ethanewer/ece455/util/README.md

# Utilities

Python tools that read the design files, simulate, lay out, and test them. Run from the repository root.

| Module | Purpose |
|---|---|
| `design.py` | The one place that knows where the design files are, the roles of the LTspice parts, and how the drawing's nodes map to board nets |
| `kicad.py` | Parses KiCad schematics, boards, and BOM exports into parts and nets, without kicad-cli |
| `ltspice.py` | Parses an LTspice `.asc` drawing into a netlist and writes an ngspice deck, including an equivalent of LTspice's UniversalOpAmp2 |
| `xlsx.py` | Reads cell values from an `.xlsx` workbook |
| `spice.py` | Runs ngspice operating-point, AC, noise, and transient analyses |
| `physics.py`, `crb.py` | Proton precession constants, the Curie-law FID amplitude, the FID model, and the frequency Cramér–Rao bound |
| `coil.py` | Winding length, resistance, and inductance by the CoilDesign.xlsx method, and their inverses |
| `printfile.py` | Measures printed parts from Bambu Studio `.gcode.3mf` files |
| `simulate.py` | `make sim`: writes `docs/simulation/` from the LTspice drawing, the tuning bank, the coil workbook and forms, and the firmware's ADC settings |
| `breadboard.py` | `make breadboard`: checks the fixed breadboard layout against the LTspice netlist and board nets, then writes `docs/breadboard/` |
| `firmware.py`, `firmware_host/` | Compile the Pico firmware on the host with stub SDK headers and run its estimator |
| `flash.py` | `make flash`: reboot a Pico into BOOTSEL over USB and copy a UF2 image onto it |
| `tests/` | `make test` |

The readers (`kicad`, `ltspice`, `xlsx`, `printfile`, `spice`) take paths and values and know nothing about this design. `tests/fixtures/` holds a frozen copy of the LTspice drawing with LTspice 17.2.4's results for it, so the translation is tested against LTspice even after the live drawing changes.
