ethanewer/ece455/local/device-diagram-options/diagram-options.md

# boat, towfish, sensor, proton wiggle

Five silly MS Paint–style options for how our proton magnetometer should work.

The boat tows the towfish. The sensor lives inside the towfish. We briefly line up the protons, let go, and listen to their wiggle. How fast they wiggle tells us the magnetic field.

## 1. The classic boat situation

Boat up here. Towfish down there. Tiny proton party inside.

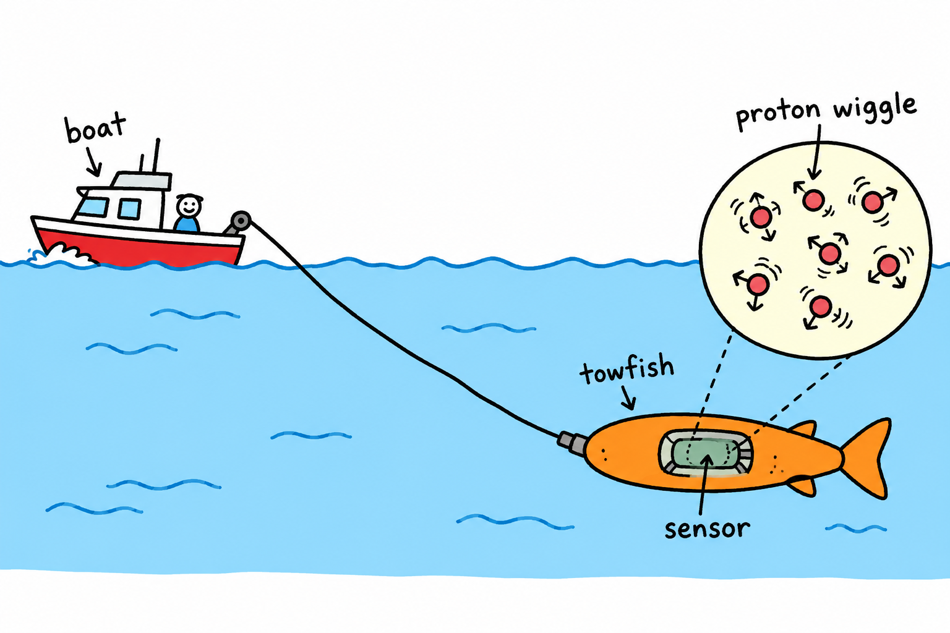
[picture p16: local/device-diagram-options/01-classic-side-view.png]
Boat towing an underwater towfish, with its sensor and a magnified proton wiggle.


## 2. Enhance. ENHANCE.

Zoom into the towfish, then into the sensor, then into the wiggle.

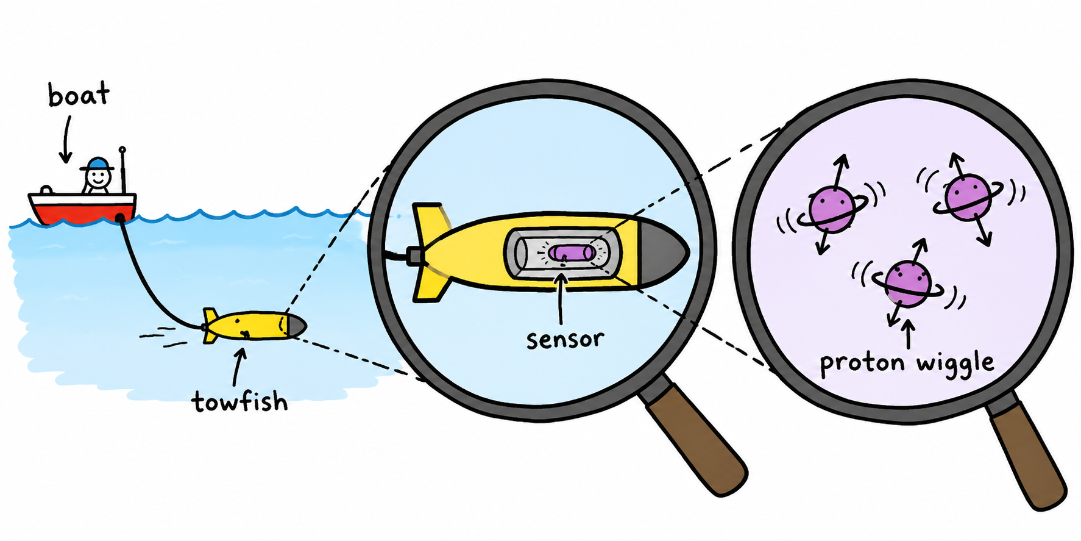
[picture p17: local/device-diagram-options/02-extreme-zoom.png]
Successive magnifying glasses reveal the sensor inside the towfish and the proton wiggle inside the sensor.


## 3. The wiggle trilogy

Tow it. Line the protons up. Let go and listen.

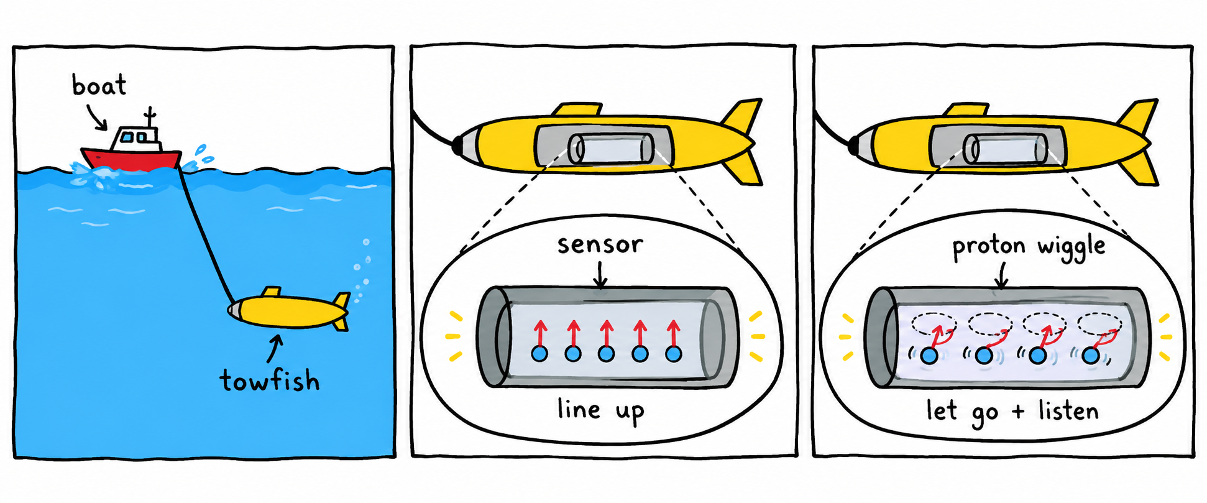
[picture p18: local/device-diagram-options/03-wiggle-comic.png]
Three-panel comic showing the boat and towfish, protons lining up inside the sensor, and proton wiggle after release.


## 4. Very serious science potato

The towfish has achieved potato form. Science continues.

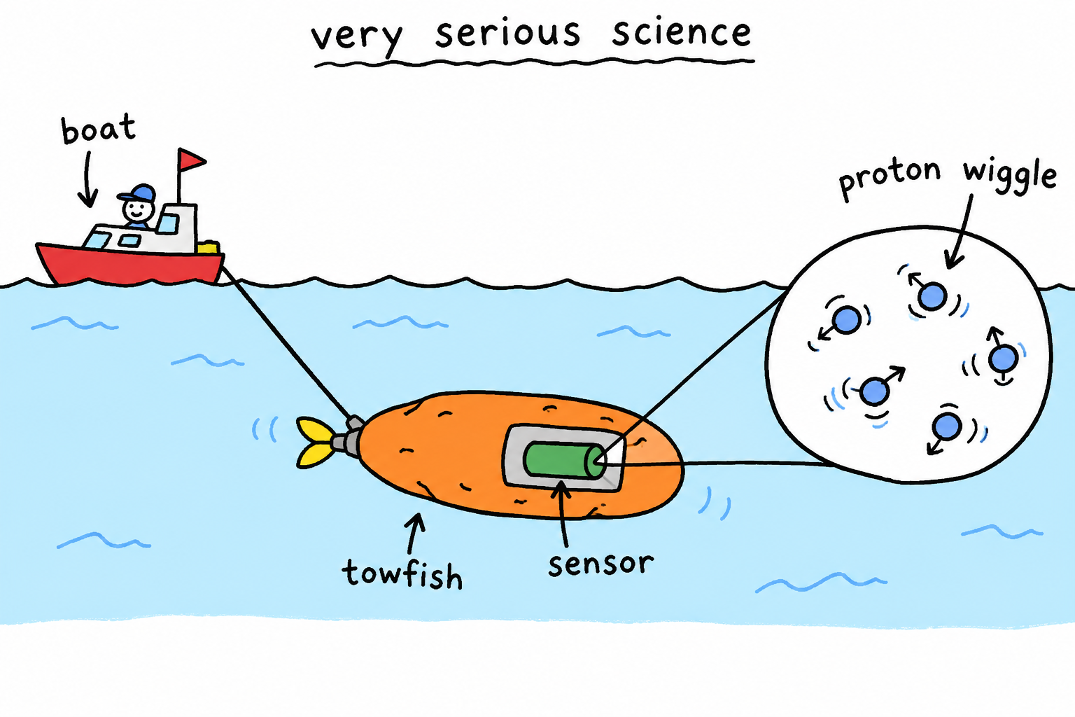
[picture p19: local/device-diagram-options/04-professional-potato.png]
A potato-shaped towfish contains the sensor, with a callout showing proton wiggle and a boat towing it.


## 5. Follow the wiggle

Tiny wiggles underwater become magnetic-field measurements on the boat.

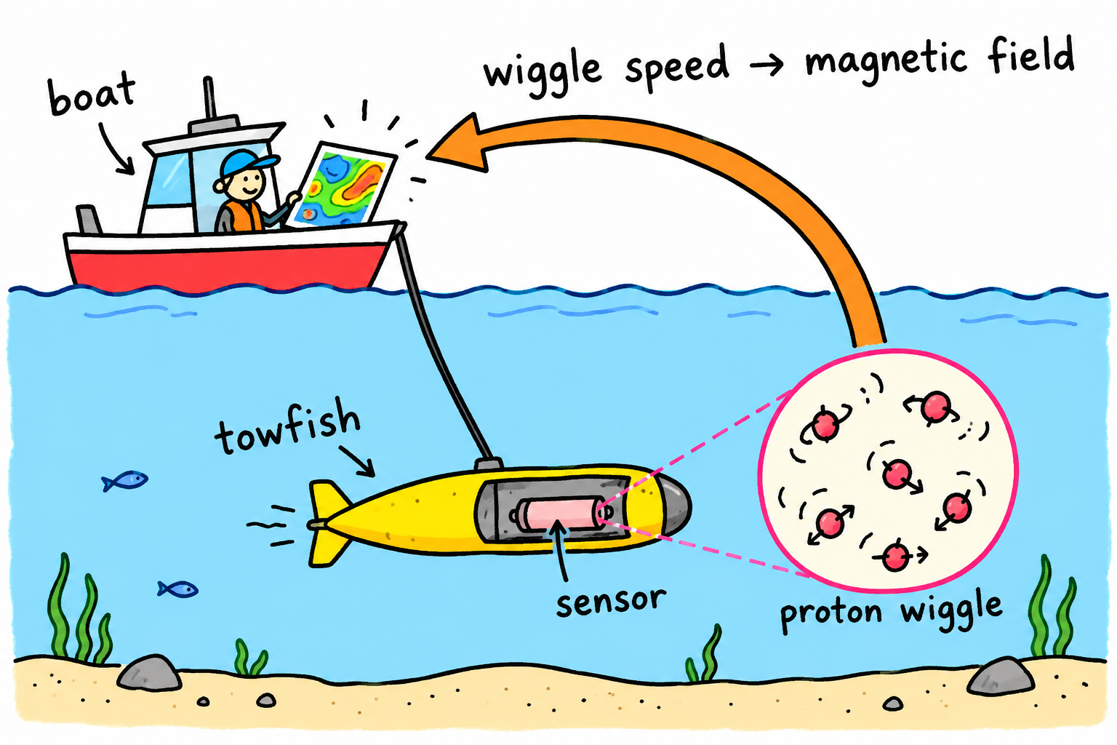
[picture p20: local/device-diagram-options/05-follow-the-wiggle.png]
Boat towing a towfish with a sensor, a proton wiggle close-up, and an arrow from wiggle speed to a magnetic-field map.


---

Generated with the built-in image generation tool. The five complete prompts are saved in [generation-prompts.json](generation-prompts.json). These are concept cartoons; shapes and sizes are illustrative.
