ethanewer/ece455/docs/past_work/proton_magnetometer/ECE 455 Final Documentation Slides Hook Line and Towfish.pptx.pdf

## Towfish Proton Precession Magnetometer (PPM) Design Documentation

Tanner Brasfield, Matt Schutt, Blake Helland

ECE 455: CAPSTONE DESIGN IN ELECTRICAL AND COMPUTER ENGINEERING

## Agenda

ECE 455: CAPSTONE DESIGN IN ELECTRICAL AND COMPUTER ENGINEERING

Background and PPM Coil Design

Circuit Block Diagram

Circuit Schematics, PCB and BOM

Software

Physical Towfish

Future Improvements

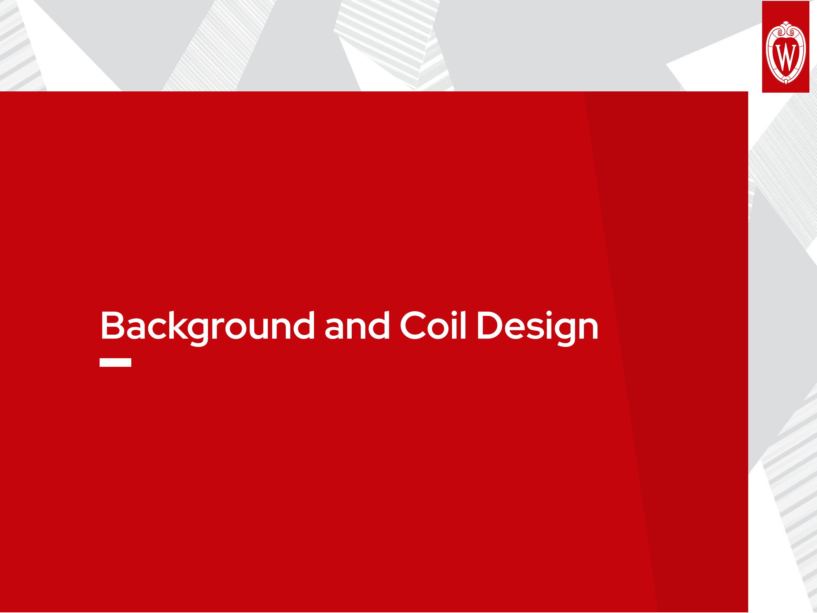
[picture p63: page 3]

## Background and Coil Design

## Proton Precession Magnetometry Background

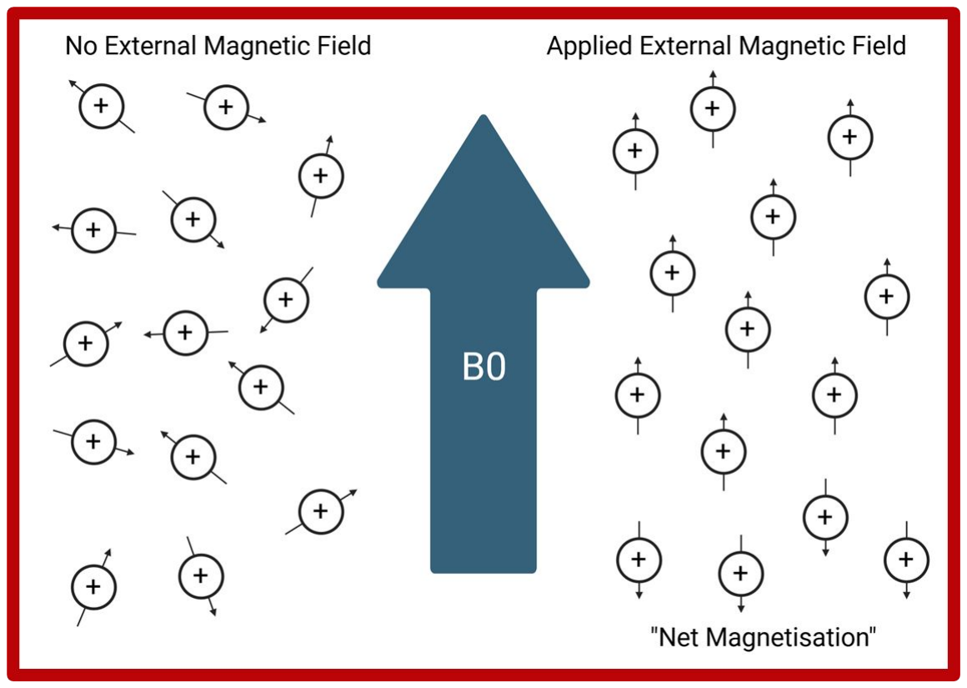
[picture p64: figure]

- Polarization: A DC current
through copper coils generates a
magnetic field (B₀) that aligns protons in a fluid such as water or kerosene.
- Switch-off: The current is abruptly cut off, causing the protons to begin realigning with Earth’s weaker magnetic field.
- Induction & Measurement: As the protons precess, they induce a small AC voltage in the coils, which is amplified and measured to determine the magnetic field strength.

## Coil Design

•3D-printed hollow coil
frame

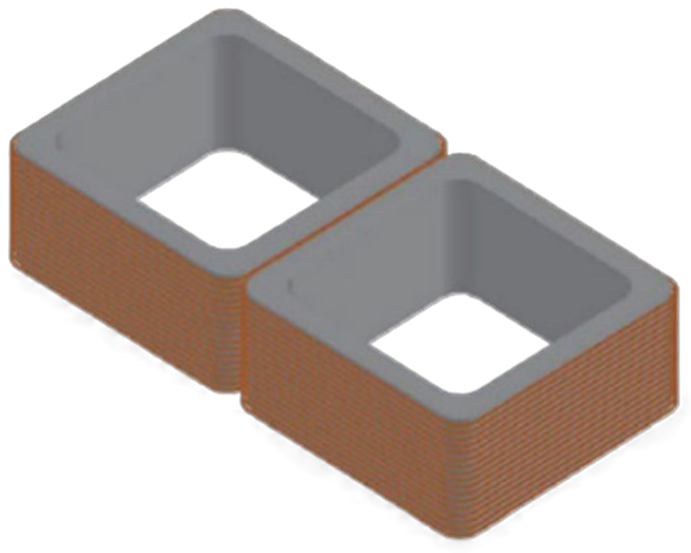
[picture p65: figure]

•10 x 10 x 10 cm

•265 turns per coil, 530
total turns

•Oppositely Wound

•18.5 Ohms Resistance

GitHub 3D Model Link: Link (https://github.com/mattyicebox/ECE445_Towfish_Magnetometer/blob/4ac4c7066d201a6bf55dc5be46255e430674249e/CAD_Files/SP26_HookLineandTowfish_AutoDeskInventorFil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)

## Coil Design Build Steps

•Enclosure: Custom 3D-printed 10x10x10 cm square housings
- Configuration: Oppositely wound coils, each wound to exactly 265 turns.
- Material: 24 AWG copper wire
- Insulation: Windings encapsulated in electrical tape to protect against shorts and improve mechanical stability
- Mounting: Coils securely mounted in PCB holder within Towfish
- PCB Connectivity: Direct terminal soldering to Coil(+) and Coil(-) pads.

## Image of Final Coils Design

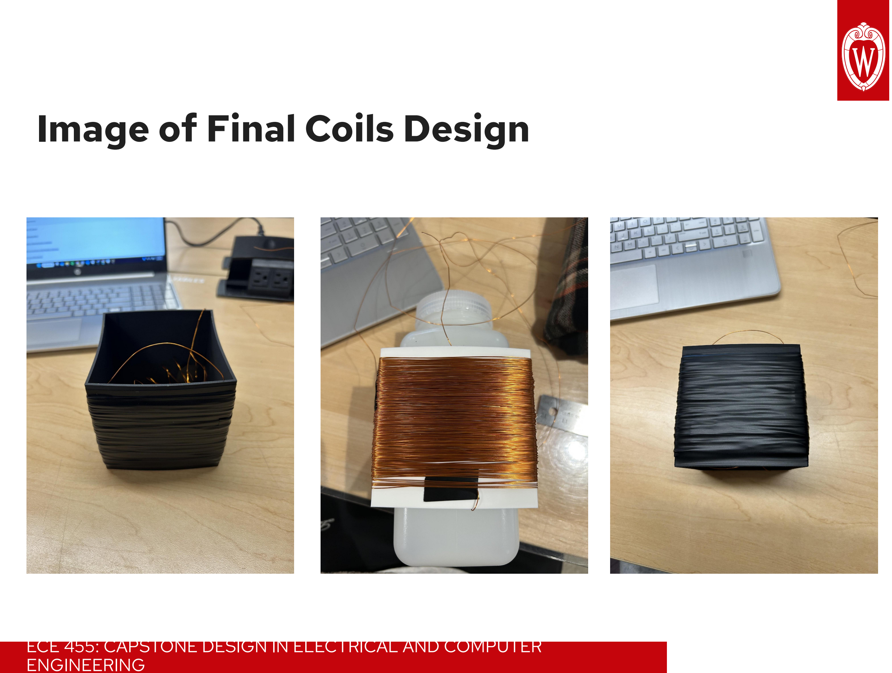
[picture p66: page 7]

## Reasoning For Oppositely Wound Coil Design

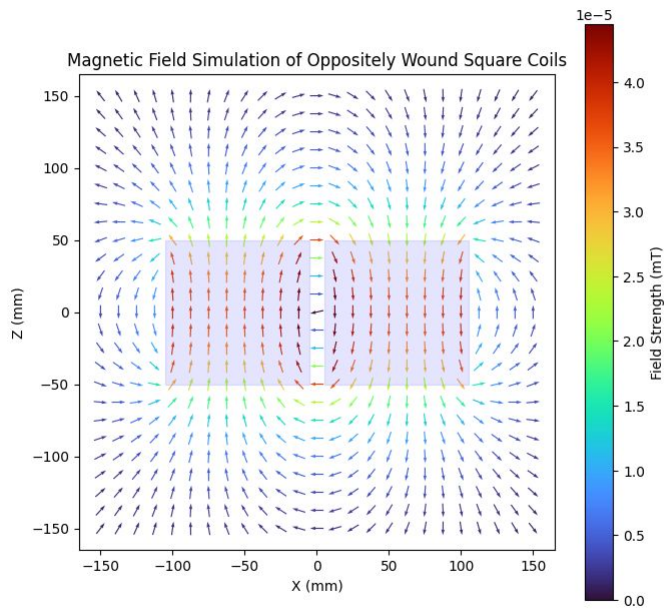
[picture p67: figure]

- Oppositely wound coils help
eliminate external noise by
cancelling voltage induced in one coil equally and
oppositely with voltage
induced in the other coil
- Flux Concentration:
Oppositely wound coils
compress the magnetic field into the center of the two coils, maximizing the
polarization of the fluid

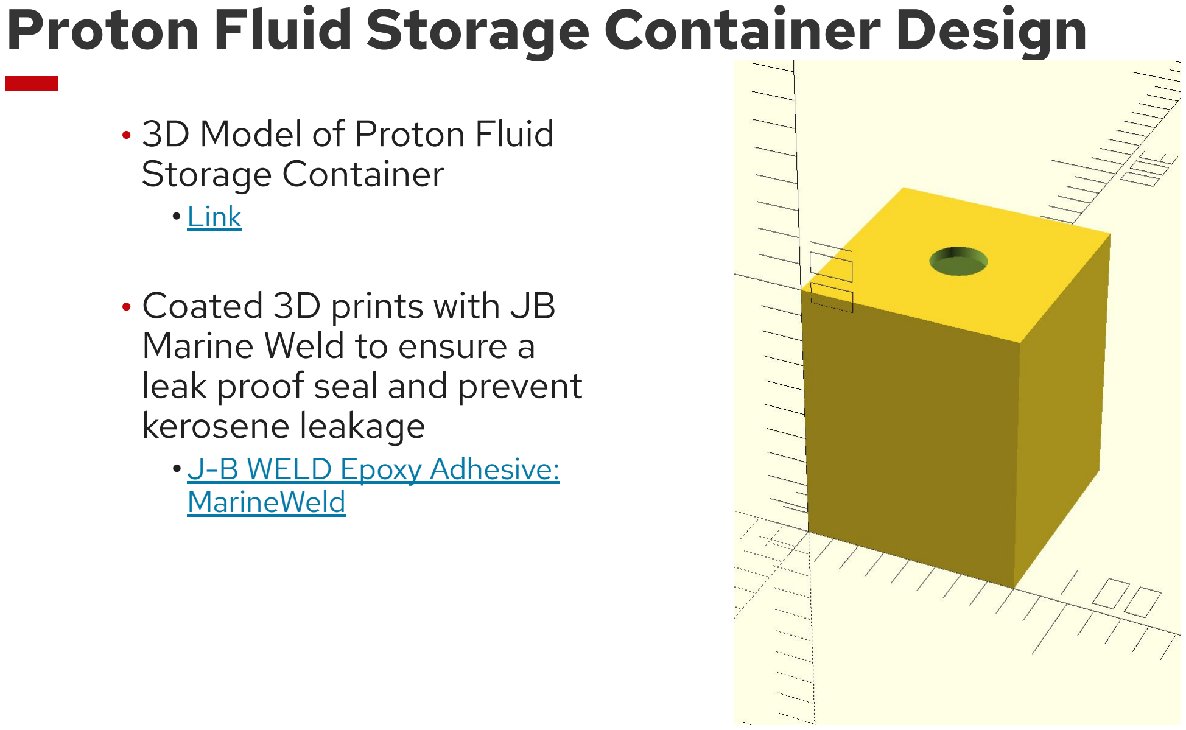
[picture p68: figure]
Proton Fluid Storage Container Design; • 3D Model of Proton Fluid Storage Container • Link; • Coated 3D prints with JB Marine Weld to ensure a leak proof seal and prevent kerosene leakage • J-B WELD Epoxy Adhesive: MarineWeld
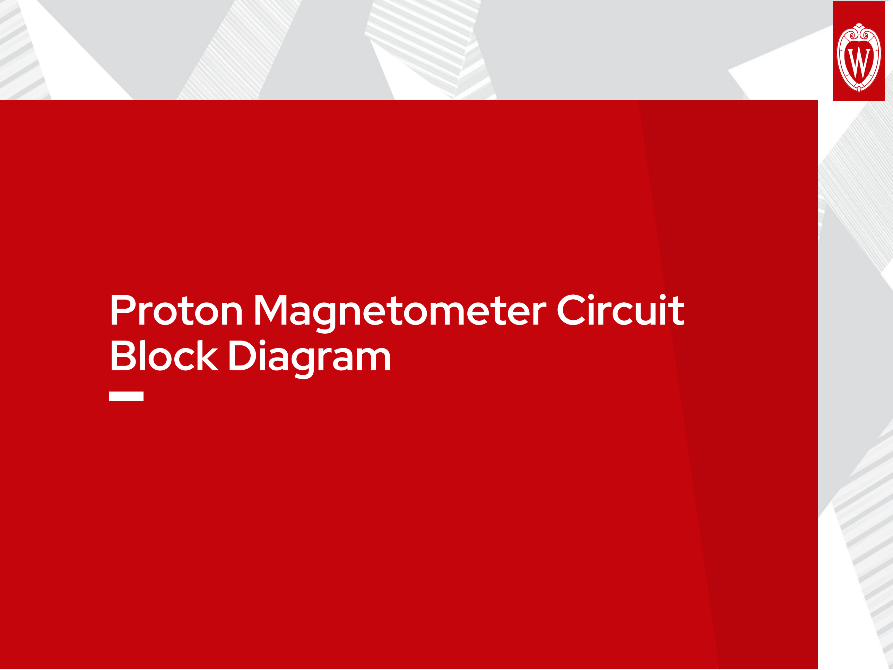
[picture p69: page 10]

## Proton Magnetometer Circuit Block Diagram

## Proton Magnetometer Circuit Design Block Diagram

Design for signal path to accurately measure Proton precession signal
- Powers and controls proton alignment
•Amplifies the proton alignment signal induced after polarization

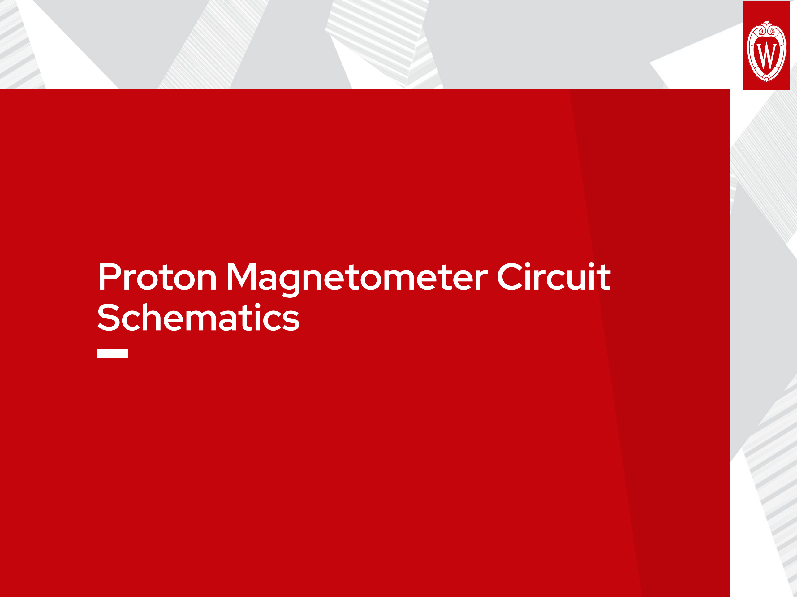
[picture p70: page 12]

## Proton Magnetometer Circuit Schematics

## Proton Magnetometer Circuit Schematics

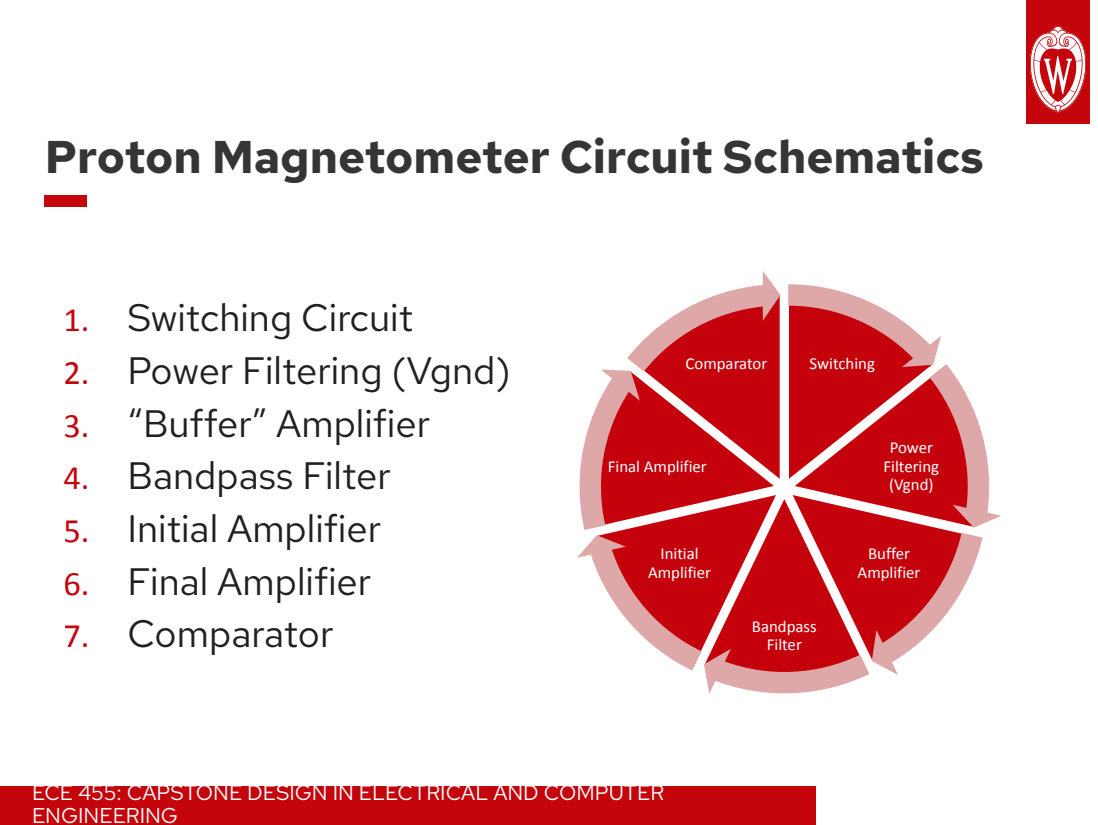
[picture p71: page 13]
Switching; Power Filtering (Vgnd); Buffer Amplifier; Bandpass Filter; Initial Amplifier; Final Amplifier; Comparator

1. Switching Circuit
2. Power Filtering (Vgnd)
3. “Buffer” Amplifier
4. Bandpass Filter
5. Initial Amplifier
6. Final Amplifier
7. Comparator

## Switching Circuit Schematic

- Link to Switching Circuit design files
- Link (https://github.com/mattyicebox/ECE445_Towfish_Magnetometer/blob/074da328fa0f320e46bdf93387bcc2017dd2d0d5/Hardware_Specs/Schematic%20PDF_%5BNo%20Variations%5D.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)
- Simulation File (https://github.com/mattyicebox/ECE455_Towfish_Magnetometer/blob/90d202d4218aa6b1bbdd6d729666215dad1faaf2/Simulations/SP26_HookLineandTowfish_SwitchingSimulati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)
- Switching Circuit Description
- Switches coil between DC polarization and AC sensing circuit to read signal
- When charging is complete and MOSFET is turned off, TVS diode and resistor are used to deplete stored energy before sensing
•Gate driver is used to control high-side MOSFET, and relay control MOSFET
- Current PCB design and BOM includes non-inverting drivers, but currently an inverting driver is soldered to the board for the high side MOSFET, along with a pulldown resistor. Both work, just changes "on" signal from microcontroller.
- Coil charge circuit is currently turned on with an input of 3.3V. Once saturated, turn off charge circuit, wait set time (~900us), then turn on sensing circuit relay with 3.3V input.
- This circuit was chosen for simplicity, and rapid discharge of the coil
- We recommend using a low side N-channel Mosfet to float the coil once it's discharged so you can use an instrumentation amplifier to remove noise in the coil before the main gain stages.

## Switching Circuit Schematic Design

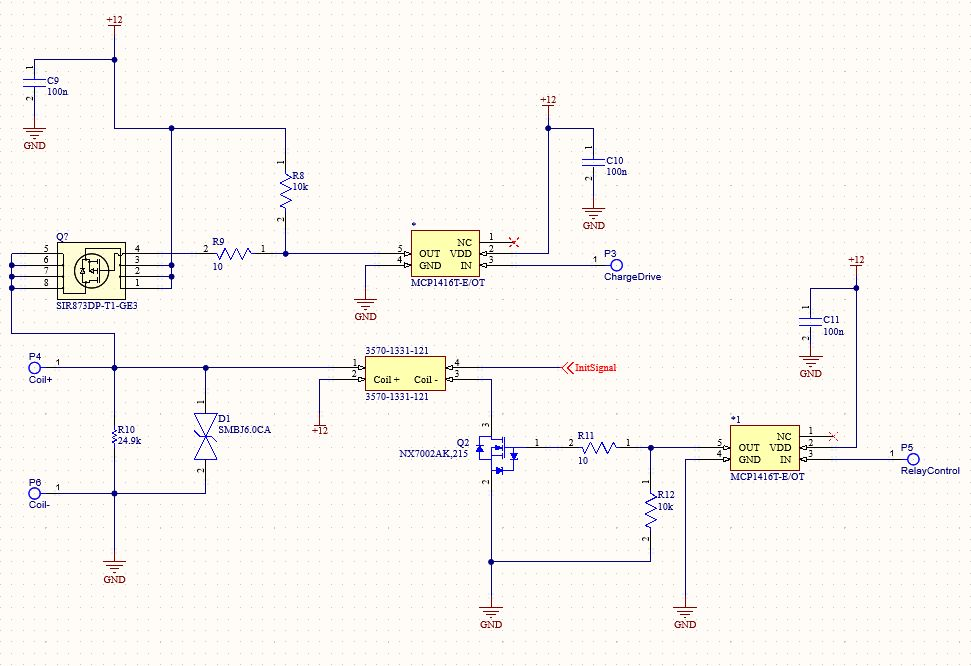
[picture p72: figure]

## Power Filtering Circuit Schematic

•Link to Power Filtering Circuit design files •Link (https://github.com/mattyicebox/ECE445_Towfish_Magnetometer/blob/074da328fa0f320e46bdf93387bcc2017dd2d0d5/Hardware_Specs/Schematic%20PDF_%5BNo%20Variations%5D.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)
•Power Filtering Circuit Description
•Generates stable virtual ground for amplifiers •Voltage divider creates ~6V for a virtual ground with two resistors and decoupling capacitors •Buffer amplifier used to stabilize and strengthen virtual ground for use in circuit
•We chose to create a virtual ground instead of creating a negative voltage for op amps to reduce switching noise

## Power Filtering Circuit Schematic Design

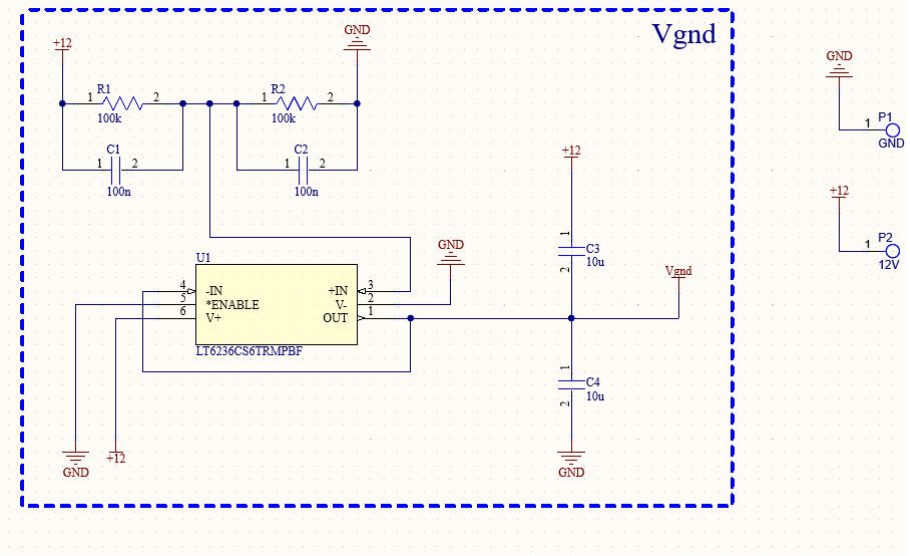
[picture p73: figure]

## “Buffer” Amplifier Circuit Schematic

## •Link to Buffer Amplifier Circuit design files

•Link (https://github.com/mattyicebox/ECE445_Towfish_Magnetometer/blob/074da328fa0f320e46bdf93387bcc2017dd2d0d5/Hardware_Specs/Schematic%20PDF_%5BNo%20Variations%5D.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)
•Simulation Link (https://github.com/mattyicebox/ECE455_Towfish_Magnetometer/blob/90d202d4218aa6b1bbdd6d729666215dad1faaf2/Simulations/SP26_HookLineandTowfish_BufferOffsetSimul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)

## •Buffer Amplifier Circuit Description

•Chosen for high impedance input for signal to prevent source loading
•Technically not a buffer stage as it has 10x gain •Before input, has a decoupling capacitor and a resistor to Vgnd to add DC offset to signal

## Buffer Amplifier Circuit Schematic Design

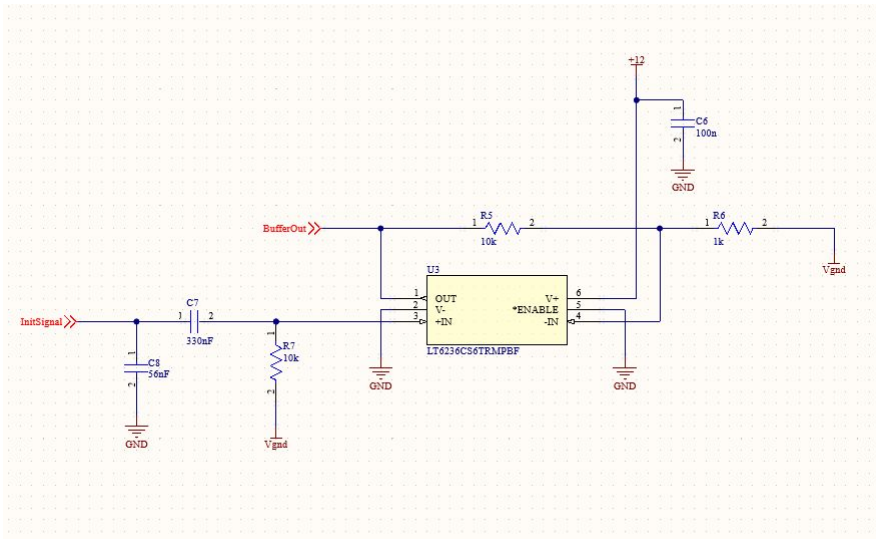
[picture p74: figure]

## Bandpass Filter Circuit Schematic

## •Link to Bandpass Filter Circuit design files

•Link (https://github.com/mattyicebox/ECE445_Towfish_Magnetometer/blob/074da328fa0f320e46bdf93387bcc2017dd2d0d5/Hardware_Specs/Schematic%20PDF_%5BNo%20Variations%5D.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)

## •Bandpass Filter Circuit Description

•Isolates target band (850–5kHz), adds 10x gain

## Bandpass Circuit Design

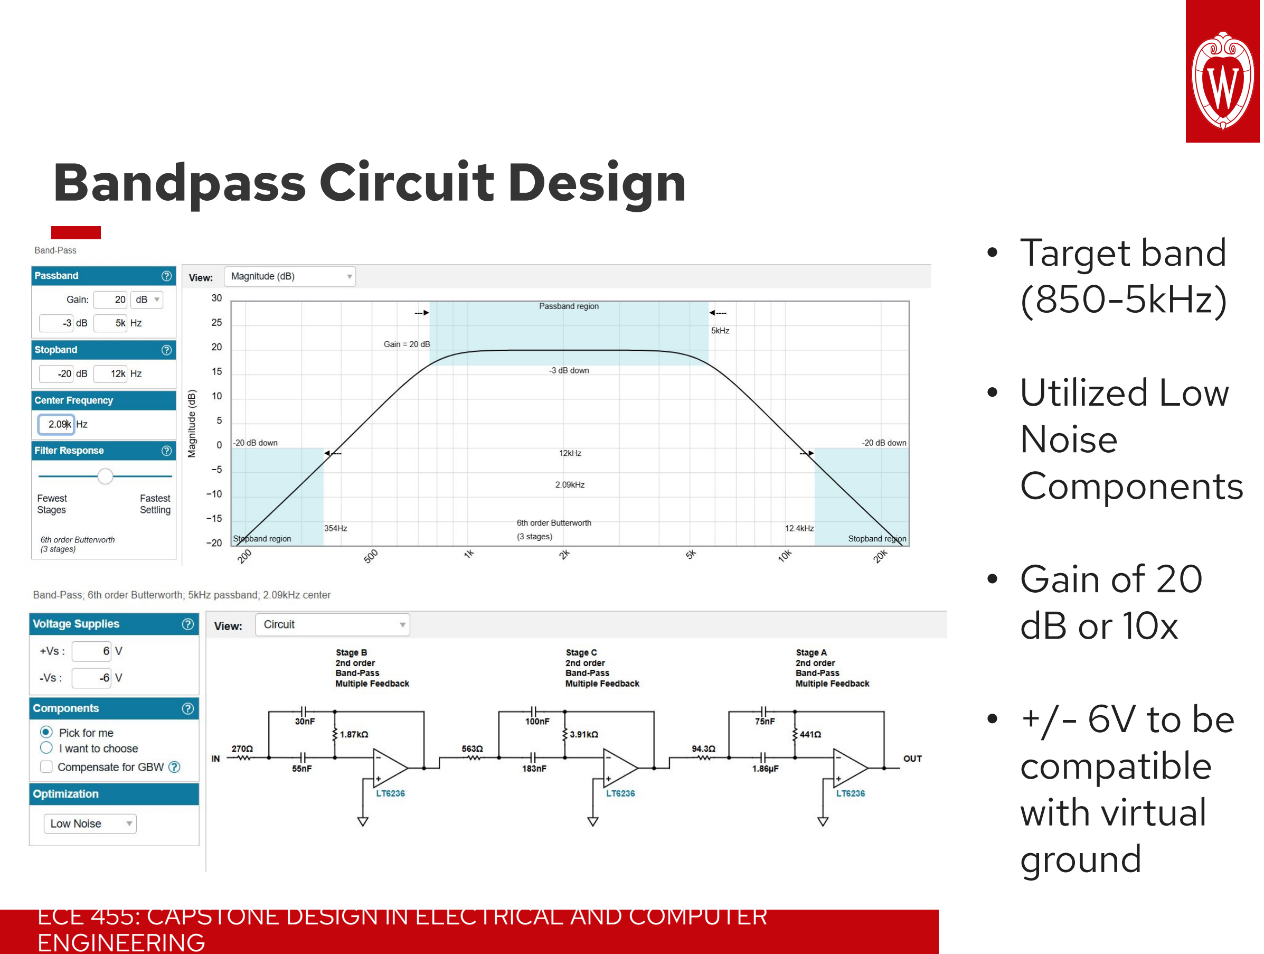
[picture p75: page 21]

- Target band
(850-5kHz)
- Utilized Low
Noise
Components
- Gain of 20
dB or 10x
- +/- 6V to be
compatible
with virtual
ground

## Bandpass Filter Circuit Schematic Design

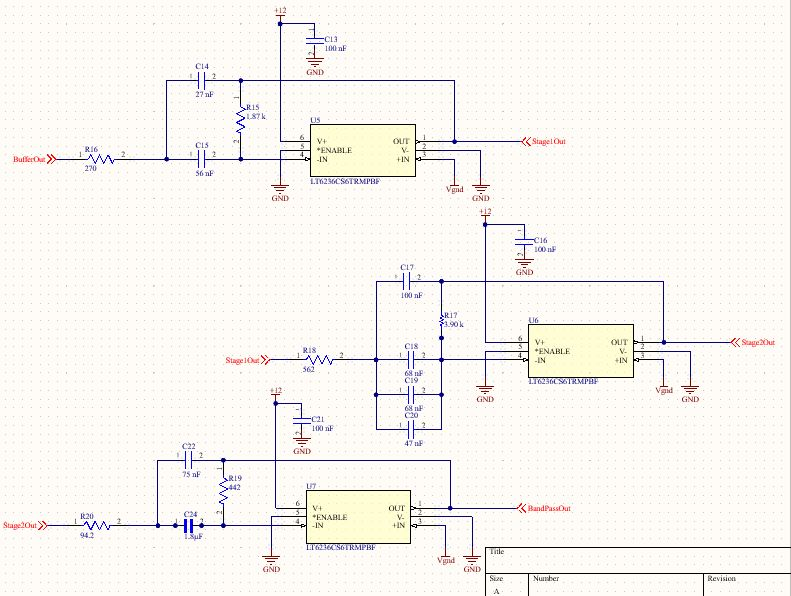
[picture p76: figure]

## Initial Amplifier Circuit Schematic

## •Link to Initial Amplifier Circuit design files

•Link (https://github.com/mattyicebox/ECE445_Towfish_Magnetometer/blob/074da328fa0f320e46bdf93387bcc2017dd2d0d5/Hardware_Specs/Schematic%20PDF_%5BNo%20Variations%5D.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)

## •Initial Amplifier Circuit Description

•Boosts signal by 10x using for signal enhancement
•Simple non-inverting amplifier
•Current PCB set to a gain of 2x for noise testing

## •Chosen for simplicity and reliability

## Initial Amplifier Circuit Schematic Design

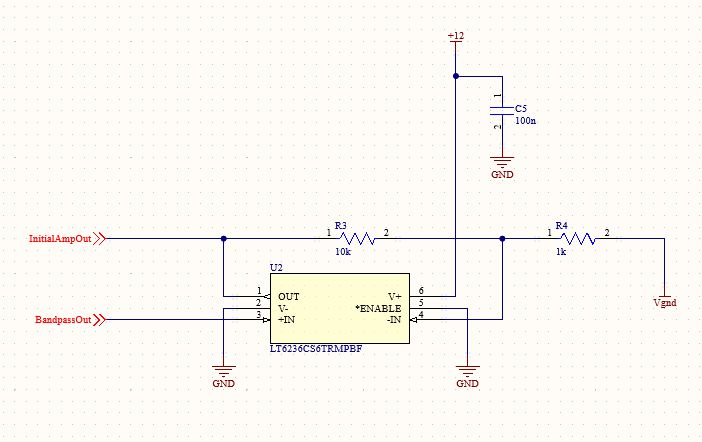
[picture p77: figure]

## Final Amplifier Circuit Schematic

## •Link to Final Amplifier Circuit design files

•Link (https://github.com/mattyicebox/ECE445_Towfish_Magnetometer/blob/074da328fa0f320e46bdf93387bcc2017dd2d0d5/Hardware_Specs/Schematic%20PDF_%5BNo%20Variations%5D.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)

## •Final Amplifier Circuit Description

•Boosts signal by 10x for signal enhancement •Simple non-inverting amplifier, same as initial amplifier
•Current PCB set to a gain of 2x for noise testing

## •Chosen for simplicity and reliability

## Final Amplifier Circuit Schematic Design

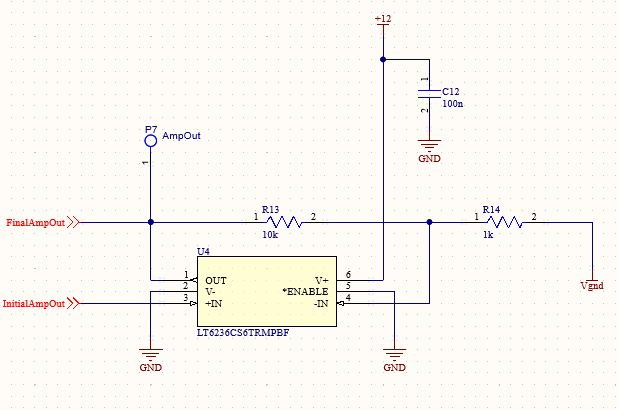
[picture p78: figure]

## Comparator Circuit Schematic

## •Link to Comparator Circuit design files

•Link (https://github.com/mattyicebox/ECE445_Towfish_Magnetometer/blob/074da328fa0f320e46bdf93387bcc2017dd2d0d5/Hardware_Specs/Schematic%20PDF_%5BNo%20Variations%5D.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)
•Simulation File (https://github.com/mattyicebox/ECE455_Towfish_Magnetometer/blob/90d202d4218aa6b1bbdd6d729666215dad1faaf2/Simulations/SP26_HookLineandTowfish_ComparatorSimulat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)

## •Comparator Circuit Description

•Digitizes sine wave to a square wave for microcontroller reading
•Hysteresis added with R24 and R22 to prevent chatter at zero crossings, adjustable if needed •Voltage divider to lower output to ~3.3V

## •Chosen to simplify software frequency measurement

## Comparator Circuit Schematic Design

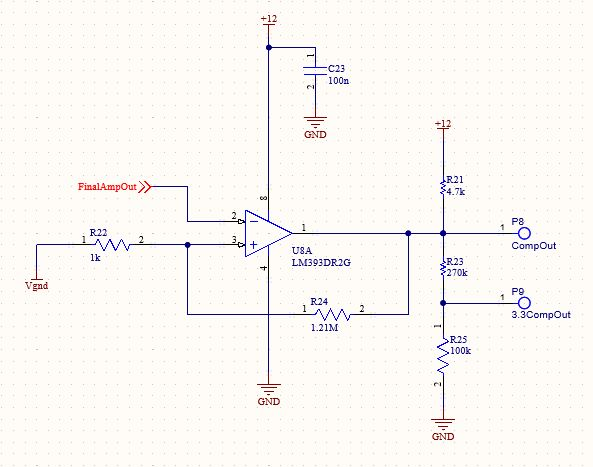
[picture p79: figure]
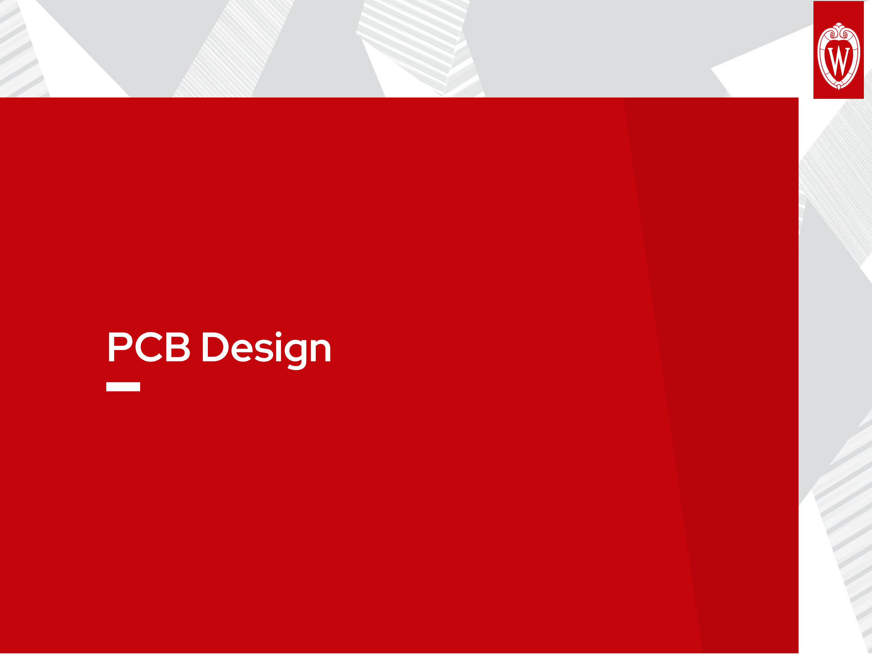
[picture p80: page 29]

## PCB Design

## PCB Design Overview

•4 Layer Board
1. Signal Layer
2. GND Layer
3. 12V Layer
4. Signal Layer

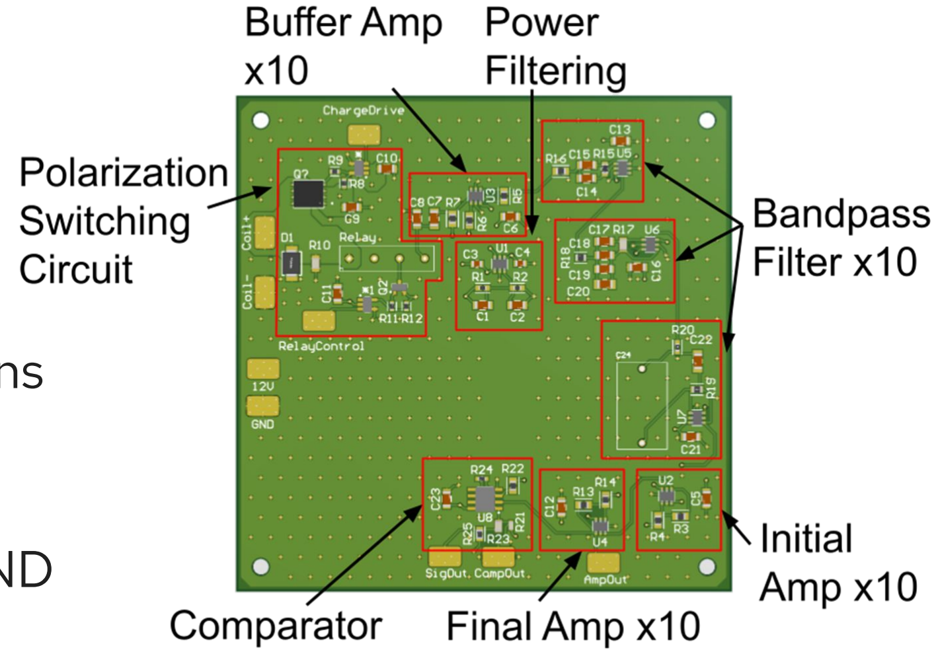
[picture p81: figure]

•Separated by sections
•Pads used for wire
connections
•Stitching Vias for GND
plane connections
•PCB Link (https://github.com/mattyicebox/ECE445_Towfish_Magnetometer/blob/08579f05e6128498e36a938e63e62c8eefcd9f1c/Hardware_Specs/BIGPCBV1.zip)

## PCB Issue Info

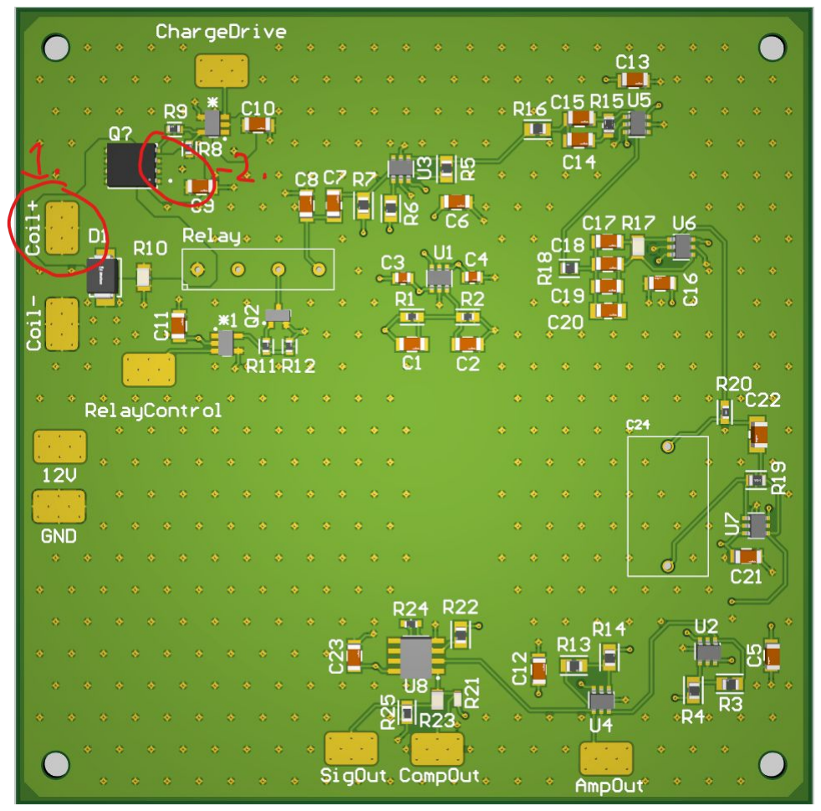
[picture p82: figure]

•Due to error when
ordering
1. Coil+ is not connected
to correct pour
2. N-channel Mosfet
source pour not
connected to 12V
•These issues were
fixed on board by
removing solder
mask and making
connections.
•PCB and schematic
are fixed

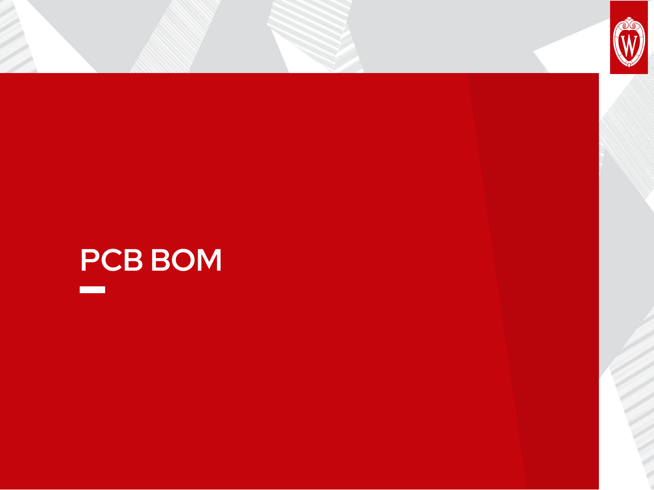
[picture p83: page 32]

## PCB BOM

## PCB Bom

- Link to PCB BOM GitHub: Link (https://github.com/mattyicebox/ECE445_Towfish_Magnetometer/blob/9278c8e1132b8ad25c7479a6de5f1147648d9e36/PCB_Order_Files/pcb.txt)

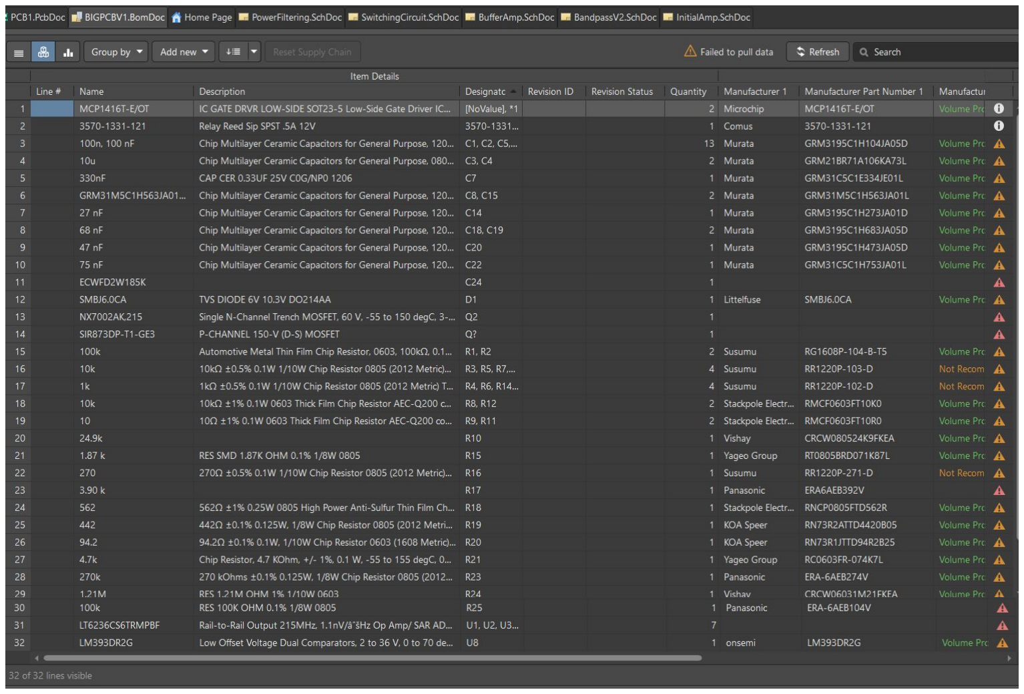
[picture p84: figure]
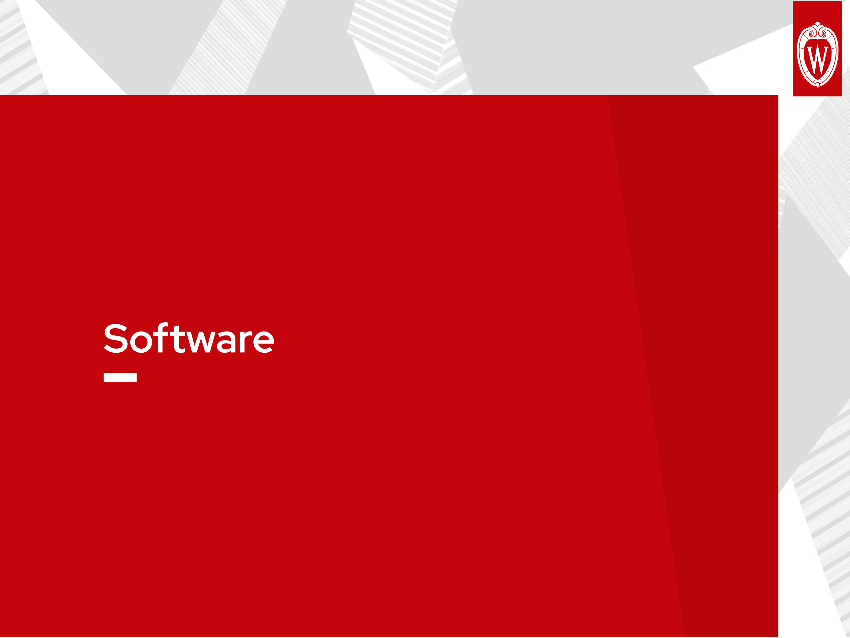
[picture p85: page 34]

## Software

## High-Level Overview

- Two Microcontrollers at use – Pi Zero and Pi Pico which communicate via UART
- Peripherals include GT-U7 GPS Module and a GY-521 IMU

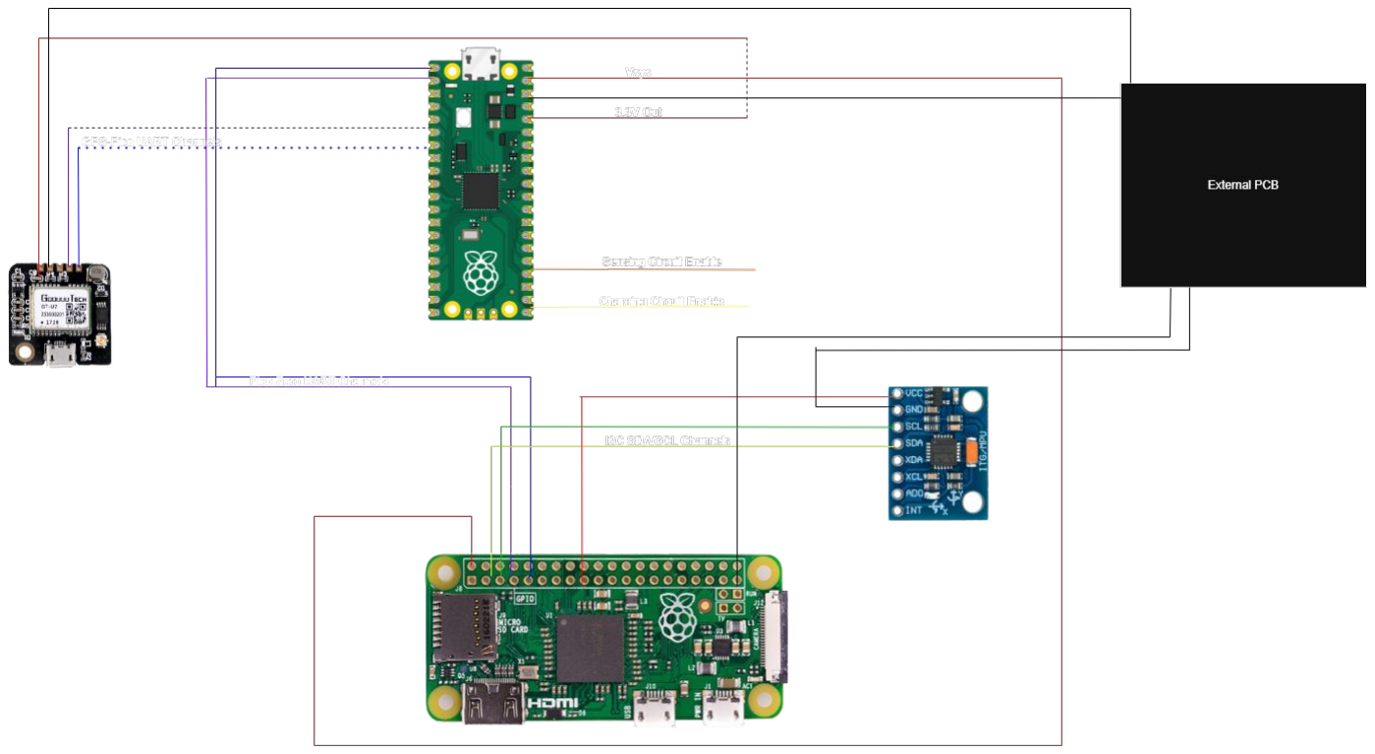
[picture p86: figure]

## Why 2 Microcontrollers?

- Please trust me, if you want to expand features/functionality to the boat keep 2 microcontrollers
- Pi Pico has 2 UART channels, but if you axe the pi zero, you can only read UART from GPS and one more peripheral, but still need to communicate with the boat, write to an external SD etc.
- Pi Zero also cannot be sole microcontroller (for the time being), as it doesn’t have the PIO functionality onboard the RP2040 Pico chip used for measuring the comparator output.

## Division of Labor Between Microcontrollers

- Pi Pico Responsibilities :
- Use PIO to gather
frequency data fed from
coil comparator (initiated by Pi Zero)
- Read GT-U7 GPS
coordinates
- Send data VIA UART to PI
- Pi Zero Responsibilities :
- Send controls signals to both send current through coils and stop charging
- Tell Pi Zero via UART to begin measurement
- Receive GPS/Frequency
Measurements, apply IMU
corrections to frequency data and calculate magnetic field strength
- Format all data into CSV file for storage, to be uncovered after a completed journey.

## GY-521 IMU

- Need to account for roll, pitch and yaw of the Towfish when measuring magnetic field in a single dimension
- Can gather this data by polling an IMU for duration of frequency measurement, and applying
corrections

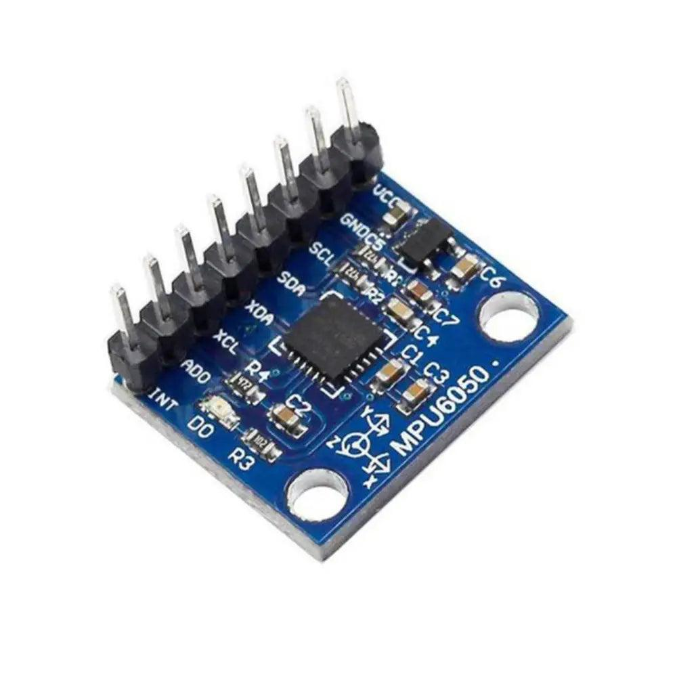
[picture p87: figure]

- Calculations and extra things of that nature are in a LaTeX file inside of the github repo – it's like 3 pages of calculations that are not needed here.

## Using Programable IO (PIO) to Measure Sensor Comparator Frequency

- Programmable IO (PIO) is a feature new to RP2040 chip, allowing for low-level assembly-like control of IO ports
- Take advantage of this instead of unreliable pi pico ADC in order to poll one pin from a comparator at a high frequency
- Can read 9MHz reliably from a lab oscilloscope, reads a 2kHz signal (frequency of Earths's b field) at a 0.3nT sensitivity
- Code is in the Github repo – please use it, it works well!
- If you'd like to axe the comparator and do an ADC, I'd recommend using a CPLD, an altera one preferably so you can use modelsim ,quartus etc tools that UW students are familiar with.

## Turning Frequency into Magnetic Field and Sensitivity

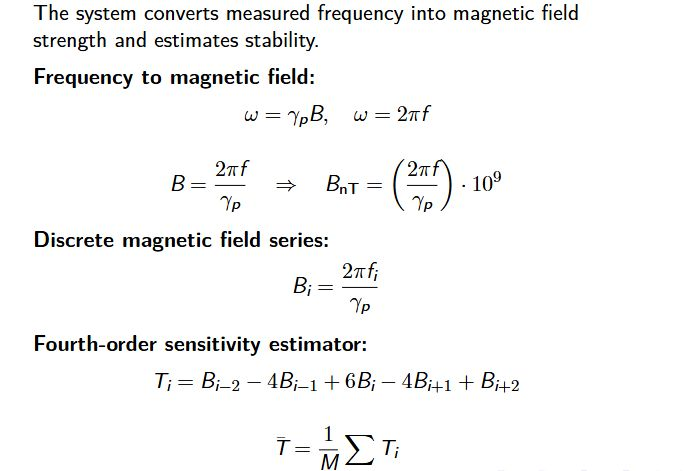
[picture p88: figure]

## GT-U7 GPS Module

- Gather GPS coordinates and send via UART channels to Pi Pico.
- GT-U7 takes a while to lock, module must have access to the sky to lock onto satellites.
- For future groups that will integrate this into telemetry of the boat – there are boat versions of the code with software that will enable idle charging and will tell the boat not to move until a gps-lock is achieved. Both of these require transmitting GPS coordinate to the boat's microcontroller via UART or some other comm. Protocol.

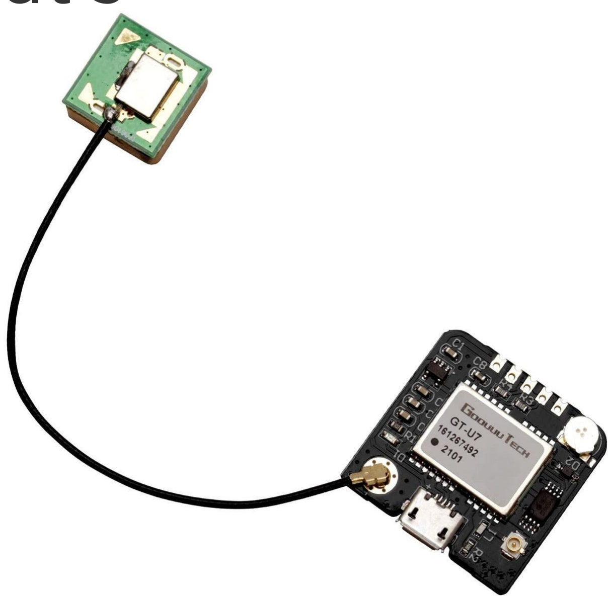
[picture p89: figure]

## IMPORTANT

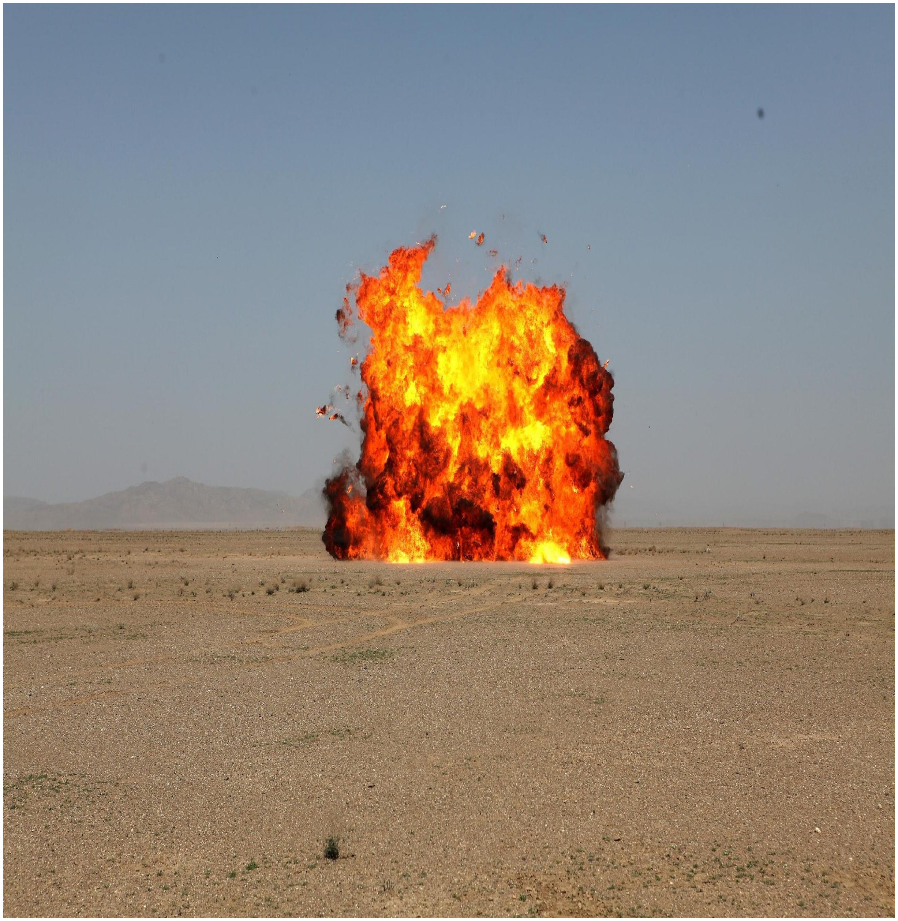
[picture p90: figure]

- The closer the timing
window between the
charging circuit discharging and initiating the sensing circuit, the better the
measurement
- However – if the charge
circuit is still discharging and the sensor circuit is enabled there is a chance of damage to the sensing circuit.

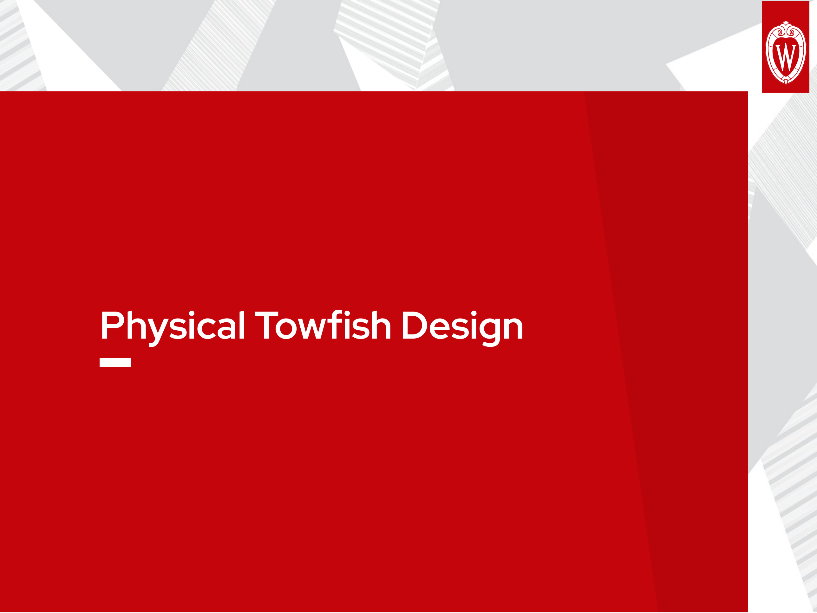
[picture p91: page 43]

## Physical Towfish Design

## Physical TowFish Design

- Low-cost 3D printed housing allows for more customization
- Multiple cable attachment points
- Hydro stabilizing fins
- 8 inch diameter housing to store large coils + proton rich fluid
- End cap complete with O-ring to provide waterproof seal

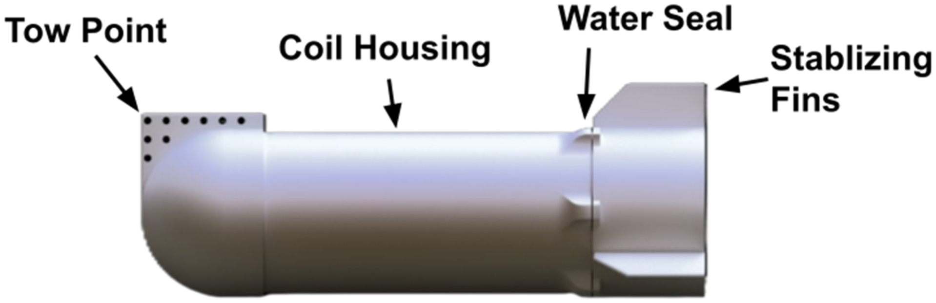
[picture p92: figure]

## Physical Towfish Design Process

- Glued in stopper block at front edge of Front Tube piece with Super Glue
- Glued in O-ring to Back Tube with super glue
- Super Glue (https://www.officedepot.com/a/products/778361/Super-Glue-Gel-1-Pack-Clear/)
- O'ring (https://www.amazon.com/dp/B0FM8D21DT?ref=ppx_yo2ov_dt_b_fed_asin_title&th=1)
- Connected Nose Cone to Front Tube and Front Tube to Back Tube with JB Weld Marine Weld
- J-B WELD Epoxy Adhesive: MarineWeld (https://www.grainger.com/product/5DFV0?gclsrc=aw.ds&gad_source=1&gad_campaignid=22475795893)
- Coated Entire Outside of all sections with Flex Seal Rubber Sealant to make 3D Prints Waterproof
- Flex Seal Liquid Rubber Sealant Coating Spray (https://www.quill.com/flex-seal-liquid-rubber-sealant-coating-spray-14-oz-black-fsr20/cbs/55379527.html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)

## Physical TowFish Design Process

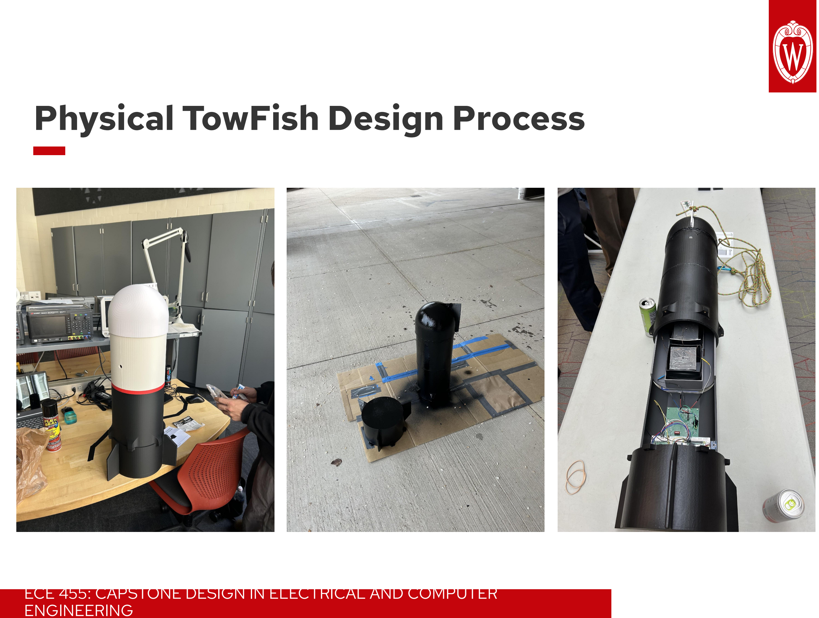
[picture p93: page 46]

## Physical TowFish Design Documentation Links

- 3D Model of Nose Cone GitHub Link: •Link (https://github.com/mattyicebox/ECE445_Towfish_Magnetometer/blob/4ac4c7066d201a6bf55dc5be46255e430674249e/CAD_Files/SP26_HookLineandTowfish_AutoDeskInventorFil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)
- 3D model of Front Tube GitHub Link: •Link (https://github.com/mattyicebox/ECE445_Towfish_Magnetometer/blob/4ac4c7066d201a6bf55dc5be46255e430674249e/CAD_Files/SP26_HookLineandTowfish_AutoDeskInventorFil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)
- 3D Model of Back Tube GitHub Link: •Link (https://github.com/mattyicebox/ECE445_Towfish_Magnetometer/blob/4ac4c7066d201a6bf55dc5be46255e430674249e/CAD_Files/SP26_HookLineandTowfish_AutoDeskInventorFil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)
- 3D Model of Back Cap GitHub Link: •Link (https://github.com/mattyicebox/ECE445_Towfish_Magnetometer/blob/4ac4c7066d201a6bf55dc5be46255e430674249e/CAD_Files/SP26_HookLineandTowfish_AutoDeskInventorFil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)
- 3D Model of Coil Holder inside of TowFish: •Link (https://github.com/mattyicebox/ECE445_Towfish_Magnetometer/blob/4ac4c7066d201a6bf55dc5be46255e430674249e/CAD_Files/SP26_HookLineandTowfish_AutoDeskInventorFil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)
- 3D Model of PCB Holder inside of TowFish: •Link (https://github.com/mattyicebox/ECE445_Towfish_Magnetometer/blob/4ac4c7066d201a6bf55dc5be46255e430674249e/CAD_Files/SP26_HookLineandTowfish_AutoDeskInventorFil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)
- 3D Model of Stopper Block inside of TowFish: •Link (https://github.com/mattyicebox/ECE445_Towfish_Magnetometer/blob/4ac4c7066d201a6bf55dc5be46255e430674249e/CAD_Files/SP26_HookLineandTowfish_AutoDeskInventorFil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)

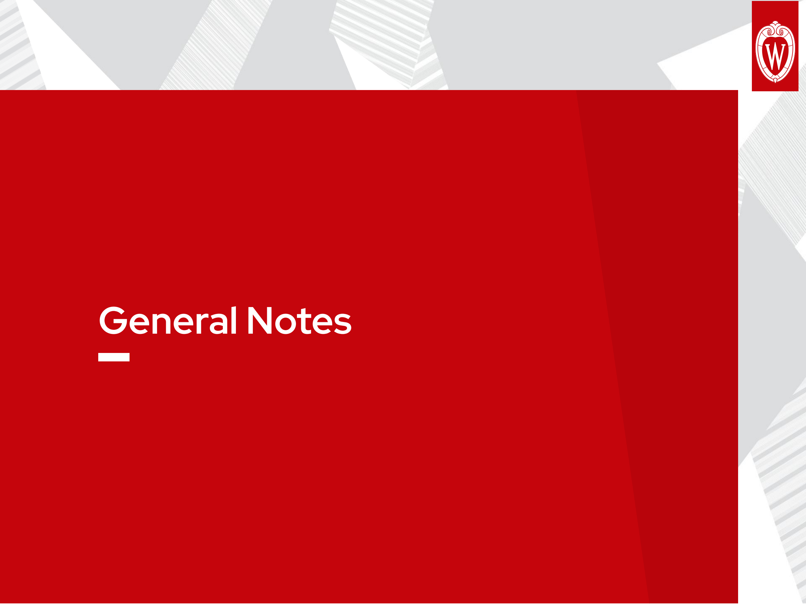
[picture p94: page 48]

## General Notes

## General Notes

## •Simulation files for most circuit schematics are available on GitHub to demonstrate working designs •Stencils for spray-painting Towfish with a Wisconsin inspired design have been added to GitHub

## •Finalize Towfish waterproofing by inserting the cable into the cable hole in Front Tube and seal with with JB Weld

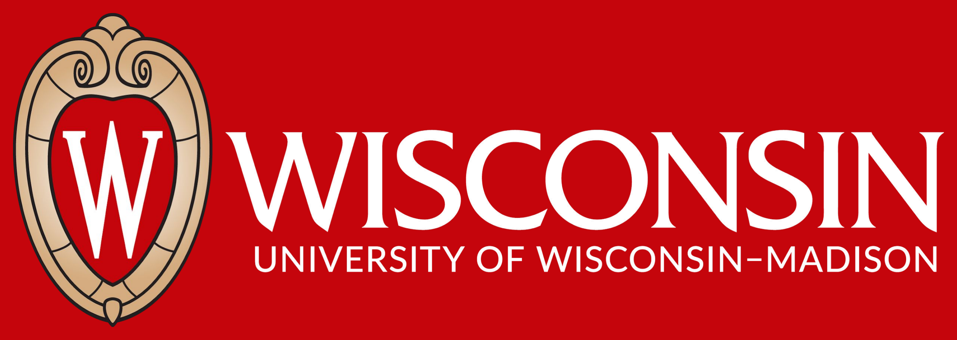
[picture p95: figure]
