ethanewer/ece455/CoilDesign.xlsx

Sheet: Coil summary
Final magnetometer coils - Once coil is wound, measure L and R and do recalculations!!
Characteristic | Polarization | Sensing / coil | Unit
Physical build and electrical resistance
Spool wire length | 153.92 | 384.96 | m
Usable wire length | 149.31 | 373.41 | m
Design wire OD | 0.714 | 0.462 | mm
Bobbin outer dimensions | 146 × 76 | 60 × 60 | mm
Bobbin inner dimensions | 140 × 70 | 56 × 56 | mm
Turns per complete layer | 140 | 216 | turns
First-layer turn perimeter | 0.447 | 0.242 | m
Perimeter added per layer | 0.006 | 0.004 | m
Wire in complete layers | 125.919 | 325.410 | m
Next-layer turn perimeter | 0.458 | 0.264 | m
Turns in partial final layer | 51 | 181 | turns
Estimated total turns | 331 | 1477 | turns
Occupied layers | 3 | 7 | layers
Wire used in winding | 149.29 | 373.20 | m
Wire left on spool | 4.63 | 11.76 | m
Estimated DC resistance at 20 °C | 7.91 | 49.97 | Ω
Polarization coil • predicted operation
Operating current | 3.00 |  | A
Applied coil voltage | 23.72 |  | V
Resistive power while on | 71.15 |  | W
Ampere-turns | 993.00 |  | A·turn
Estimated center field | 8.63 |  | mT
Estimated inductance | 9.84 |  | mH
Stored magnetic energy | 44.26 |  | mJ
L/R turn-on time constant | 1.24 |  | ms
Approximate TVS turn-off time | 0.37 |  | ms
Sensing coils • predicted receive behavior
Estimated inductance per coil |  | 76.28 | mH
Series-pair resistance |  | 99.94 | Ω
Estimated series-pair inductance |  | 152.57 | mH
Relative induced signal / coil |  | 2.40 | × baseline
Illustrative peak signal / coil |  | 36.02 | µV peak
Illustrative series-pair peak |  | 72.03 | µV peak
Johnson noise density / coil |  | 0.90 | nV/√Hz
Johnson noise density / pair |  | 1.27 | nV/√Hz
Relative coil-only SNR / coil |  | 0.76 | × baseline
Series-pair tuning capacitor |  | 51.53 | nF
Unloaded series Q near 1.795 kHz |  | 17.22 | dimensionless
Electrical amplitude ring-down τ |  | 3.05 | ms
Approximate 5τ settling time |  | 15.27 | ms

Sheet: Inputs and method
Inputs and calculation method
Values in the input columns are editable. Heavy-build OD uses conservative published limits.
Editable inputs
Characteristic | Polarization | Sensing / coil | Unit | Basis or interpretation
Wire length per spool | 505.00 | 1263.00 | ft | EMTEL listing; one polarization spool, one spool per sensing coil.
Design insulated wire outside diameter | 0.714 | 0.462 | mm | Heavy-build maximum OD from published magnet-wire dimensions; confirm actual EMTEL insulated OD.
Bobbin outer long dimension | 146.00 | 60.00 | mm | Approximate winding core dimensions.
Bobbin outer short dimension | 76.00 | 60.00 | mm | Approximate winding core dimensions.
Bobbin inner long dimension | 140.00 | 56.00 | mm | Approximate clear aperture.
Bobbin inner short dimension | 70.00 | 56.00 | mm | Approximate clear aperture.
Winding width | 100.00 | 100.00 | mm | Usable axial width; actual flanges may reduce this.
Lead / winding margin | 0.03 | 0.03 | fraction | 3% of spool length held for leads, imperfect packing and variation.
Copper resistance at 20 °C | 16.14 | 40.81 | Ω/1000 ft | Nominal AWG copper values; measure finished coils.
Planned complete layers | 2.00 | 6.00 | layers | Used to calculate a partial final layer without circular formulas.
Polarization current limit | 3.00 |  | A | Prior design limit.
Supply voltage ceiling | 30.00 |  | V | Prior design limit.
Assumed TVS voltage across coil during turn-off | 68.00 |  | V | Illustrative effective TVS voltage across the coil during current decay; final value depends on the selected TVS and pulse current.
Signal / tuning frequency | 1795.00 | 1795.00 | Hz | Approximate proton precession frequency.
Noise temperature | 293.15 | 293.15 | K | 20 °C ambient; hot coil resistance/noise will increase.
Earlier sensing baseline turns |  | 590.00 | turns/coil | 20 AWG comparison design.
Earlier sensing baseline resistance |  | 5.05 | Ω/coil | 20 AWG comparison design.
Earlier baseline peak signal |  | 15.00 | µV peak | Illustrative prior assumption, not a measured signal.
Earlier 1544-turn signal ratio |  | 2.51 | × | Earlier area-adjusted estimate relative to 590-turn baseline.
Polarization reference turns | 342.00 |  | turns | Prior single-build geometric estimate.
Polarization reference center field | 8.92 |  | mT | Earlier finite rectangular-coil center-field estimate at 3 A.
Polarization reference inductance | 10.50 |  | mH | Earlier estimate at 342 turns.
Sensing reference turns |  | 1544.00 | turns | Earlier single-build geometric estimate.
Legacy sensing reference inductance |  | 41.00 | mH | Earlier per-coil estimate at 1544 turns. Retained for comparison; no longer used for the final sensing-coil inductance estimate.
Sensing reference resistance |  | 52.00 | Ω | Earlier estimate per coil at 1544 turns.
Listing diameter (bare copper) | 0.645 | 0.404 | mm | EMTEL listing diameters match nominal bare AWG sizes; do not use as winding pitch.
Method and limits
Winding pitch | Floor(winding width / insulated OD). Close packing assumed. Listing diameters are bare copper sizes.
Turn length | First turn uses outer bobbin dimensions plus one wire OD on each side; each added layer raises rectangular perimeter by 8 × OD.
Turns | Full-layer wire length is an arithmetic series; remaining usable wire forms a partial final layer.
Resistance | Used wire length × nominal 20 °C Ω/1000 ft; includes winding length but excludes connection/contact resistance.
Field and inductance | Polarization field and inductance are scaled from prior finite-geometry estimates. Sensing inductance uses a Wheeler multilayer-solenoid approximation with an equivalent circular radius derived from the mean wound rectangular area; measure the finished coils.
Induced voltage | Scaled from earlier area-adjusted 2.51× signal at 1544 turns. The 15 µV baseline is illustrative, not a measured absolute prediction.
Noise and SNR | Johnson density = √(4kTR). Coil-only SNR ratio = signal ratio × √(Rbaseline/Rcoil). Amplifier and environmental noise excluded.
Resonance | Pair assumes two equal series-aiding coils with negligible mutual coupling: Lpair = 2L, Rpair = 2R. C = 1/[(2πf)²Lpair].
Q and ring-down | Unloaded series Q = 2πfL/R. Voltage amplitude ring-down τ = 2Lpair/Rpair = Q/(πf); loading changes both.
TVS turn-off | For the TVS directly across the polarization coil: t = (L/R) ln[1 + I·R/VTVS], where VTVS is the reverse voltage developed across the coil. The MOSFET sees approximately Vsupply + VTVS, plus parasitic overshoot.
