ethanewer/ece455/receiver_design/analysis/receiver-frequency-response.csv

frequency_hz | gain_db | phase_deg
100.0 | 39.2313026 | -1.586231690574447
101.157945 | 39.2312607 | -1.6045964203028775
102.329299 | 39.2312179 | -1.62317369445499
103.514217 | 39.2311741 | -1.6419659767493033
104.712855 | 39.2311292 | -1.6609757480930702
105.925373 | 39.2310833 | -1.6802055295005893
107.151931 | 39.2310363 | -1.6996578591748932
108.392691 | 39.2309883 | -1.71933531542606
109.64782 | 39.2309391 | -1.7392404937529016
110.917482 | 39.2308887 | -1.7593760354908534
112.201845 | 39.2308372 | -1.7797445934345069
113.501082 | 39.2307845 | -1.8003488662150775
114.815362 | 39.2307306 | -1.8211915811116692
116.144861 | 39.2306754 | -1.8422754883216994
117.489755 | 39.230619 | -1.8636033781496302
118.850223 | 39.2305612 | -1.8851780638182358
120.226443 | 39.230502 | -1.9070024101164917
121.6186 | 39.2304415 | -1.9290792932925296
123.026877 | 39.2303796 | -1.951411635431104
124.451461 | 39.2303163 | -1.9740023815352825
125.892541 | 39.2302514 | -1.996854528174334
127.350308 | 39.2301851 | -2.019971083376682
128.824955 | 39.2301172 | -2.0433551124665312
130.316678 | 39.2300477 | -2.067009697956819
131.825674 | 39.2299767 | -2.090937962467529
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
