ethanewer/ece455/receiver_design/analysis/receiver-waveforms.csv

time_s | fid_source_v | adc_differential_v
0.2000014 | 8.53776858e-08 | 2.38524967
0.2000064 | 5.34206833e-07 | 2.38528466
0.2000114 | 9.8138921e-07 | 2.3853205
0.2000164 | 1.42555029e-06 | 2.38535709
0.2000214 | 1.86532483e-06 | 2.38539431
0.2000264 | 2.29936111e-06 | 2.38543205
0.2000314 | 2.72632504e-06 | 2.3854702
0.2000364 | 3.14490431e-06 | 2.38550863
0.2000414 | 3.55381236e-06 | 2.38554723
0.2000464 | 3.95179239e-06 | 2.38558588
0.2000514 | 4.33762122e-06 | 2.38562445
0.2000564 | 4.71011301e-06 | 2.38566284
0.2000614 | 5.06812293e-06 | 2.38570093
0.2000664 | 5.41055068e-06 | 2.38573859
0.2000714 | 5.73634388e-06 | 2.38577571
0.2000764 | 6.04450128e-06 | 2.38581218
0.2000814 | 6.33407585e-06 | 2.38584789
0.2000864 | 6.60417768e-06 | 2.38588271
0.2000914 | 6.85397675e-06 | 2.38591656
0.2000964 | 7.08270544e-06 | 2.38594932
0.2001014 | 7.2896609e-06 | 2.3859809
0.2001064 | 7.47420722e-06 | 2.38601119
0.2001114 | 7.63577738e-06 | 2.3860401
0.2001164 | 7.77387499e-06 | 2.38606755
0.2001214 | 7.8880758e-06 | 2.38609345
0.2001264 | 7.97802905e-06 | 2.38611772
0.2001314 | 8.04345849e-06 | 2.38614028
0.2001364 | 8.08416325e-06 | 2.38616107
0.2001414 | 8.10001848e-06 | 2.38618003
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
