ethanewer/ece455/docs/week_2/figures/finding-titan_coil-orientation-cad.jpg

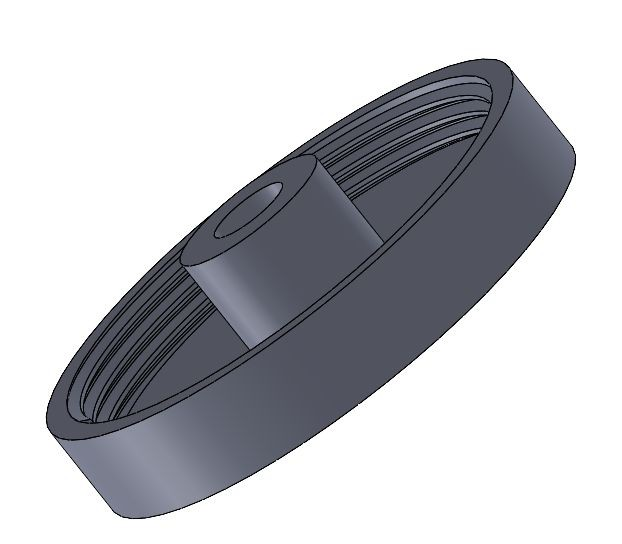
docs/week_2/figures/finding-titan_coil-orientation-cad.jpg
