ethanewer/ece455/docs/week_2/figures/finding-titan_comparator-square-wave.jpg

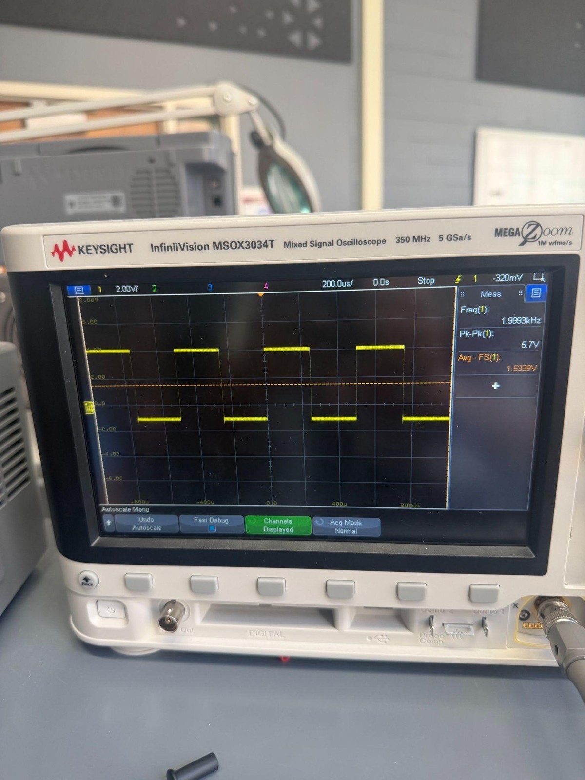
docs/week_2/figures/finding-titan_comparator-square-wave.jpg
