ethanewer/ece455/docs/week_2/figures/finding-titan_power-pcb.jpg

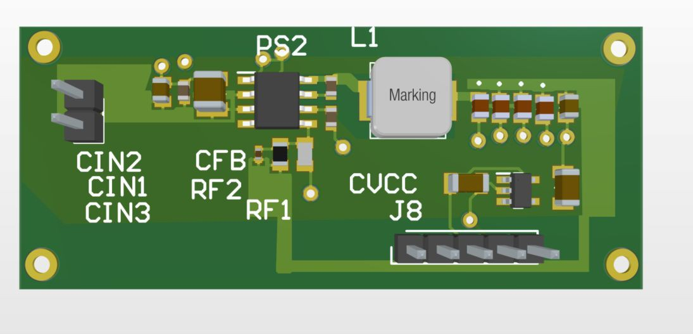
docs/week_2/figures/finding-titan_power-pcb.jpg
