ethanewer/ece455/docs/week_2/figures/finding-titan_preamp-output.jpg

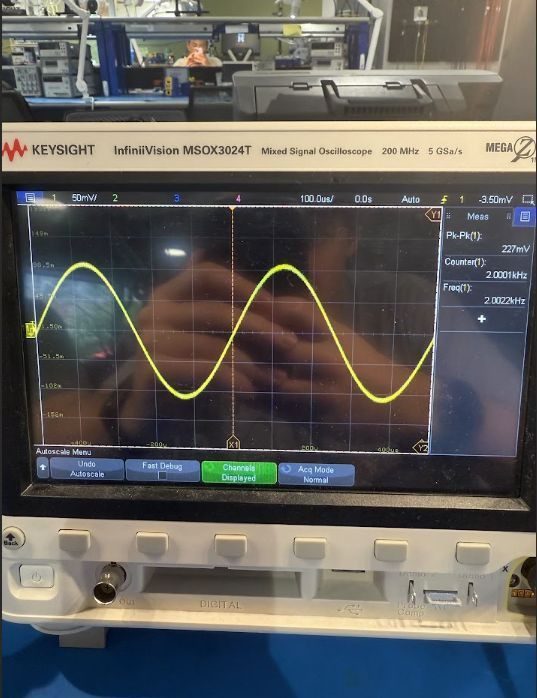
docs/week_2/figures/finding-titan_preamp-output.jpg
