ethanewer/ece455/docs/week_2/figures/finding-titan_sensing-coil-response.jpg

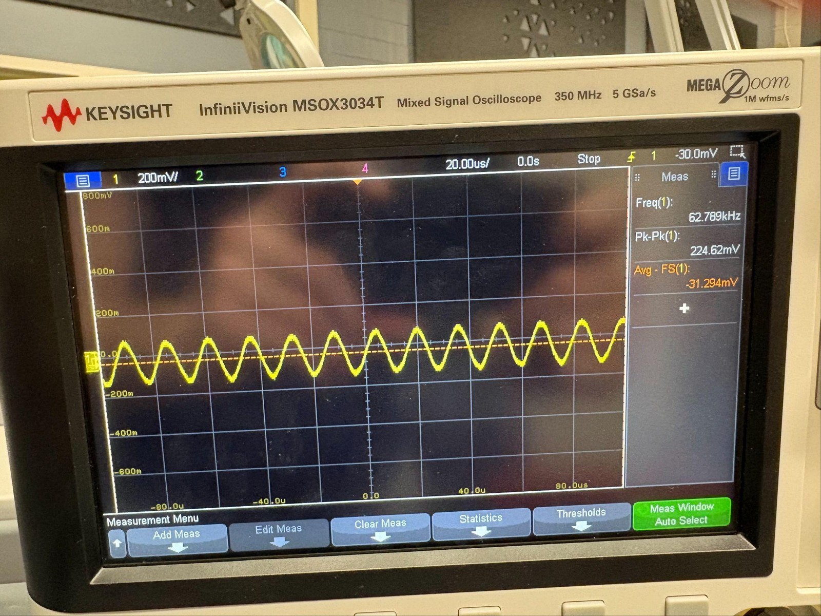
docs/week_2/figures/finding-titan_sensing-coil-response.jpg
