ethanewer/ece455/docs/week_2/figures/hook-line_bandpass-response.jpg

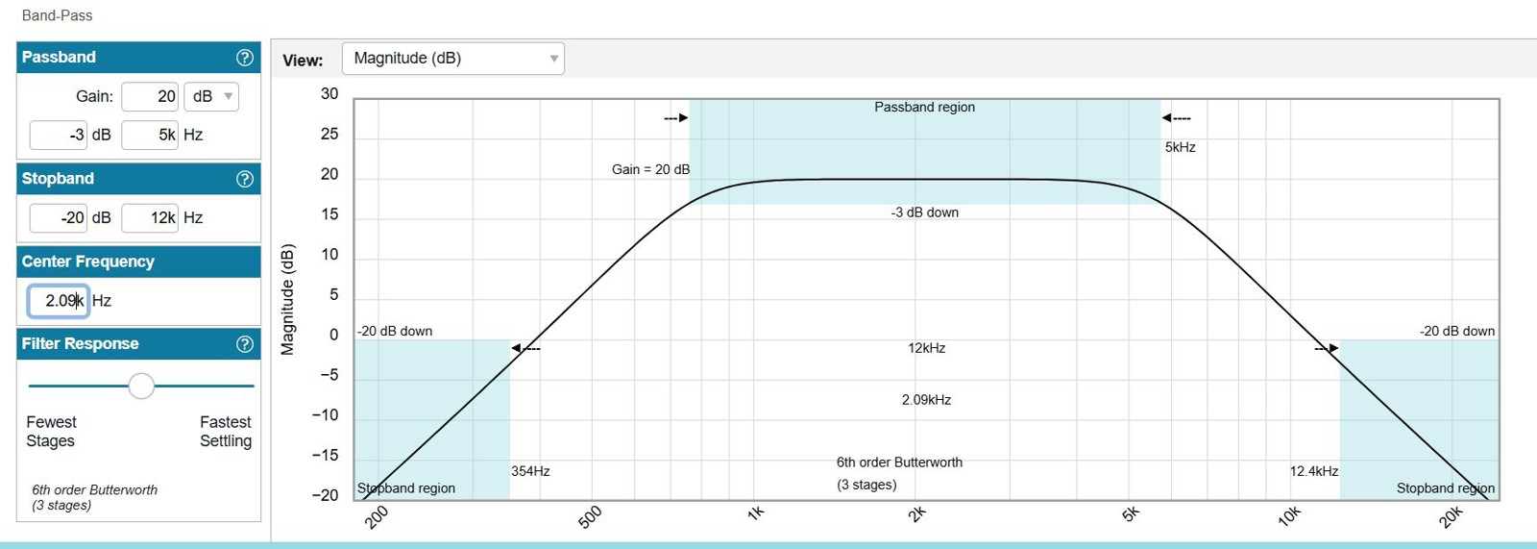
docs/week_2/figures/hook-line_bandpass-response.jpg
