ethanewer/ece455/docs/week_2/figures/hook-line_coil-housing-cad.jpg

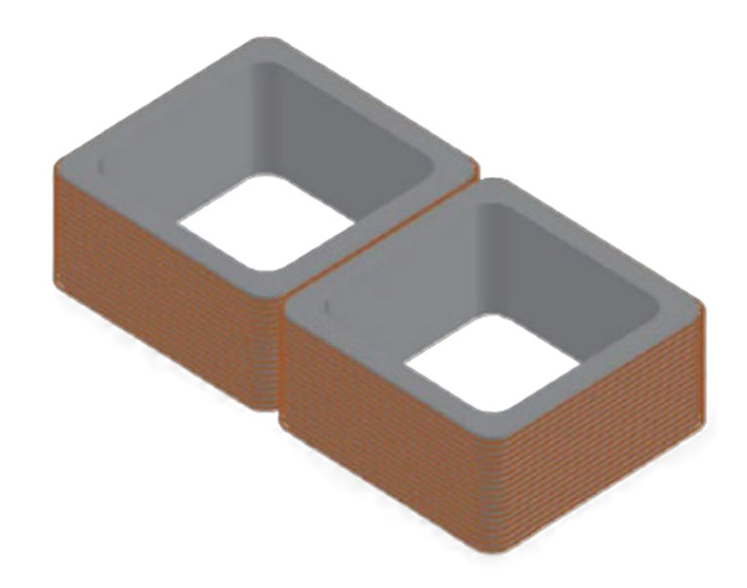
docs/week_2/figures/hook-line_coil-housing-cad.jpg
