ethanewer/ece455/docs/week_2/figures/hook-line_fluid-container-cad.jpg

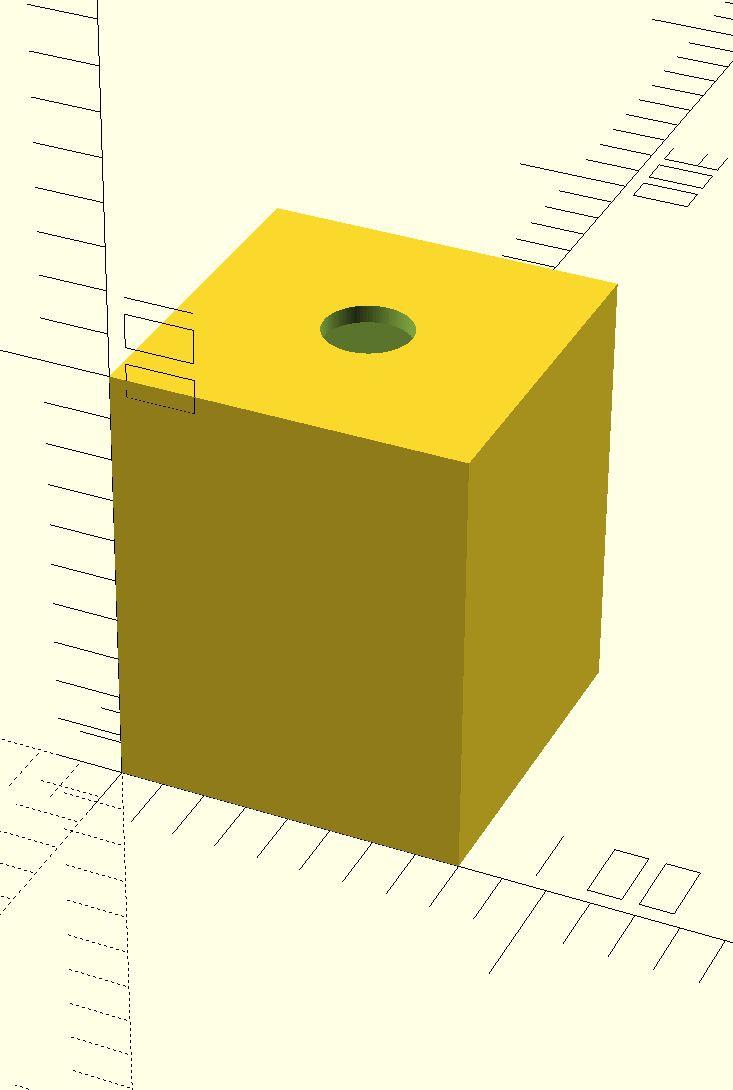
docs/week_2/figures/hook-line_fluid-container-cad.jpg
