ethanewer/ece455/docs/week_2/figures/hook-line_opposed-coil-field-sim.jpg

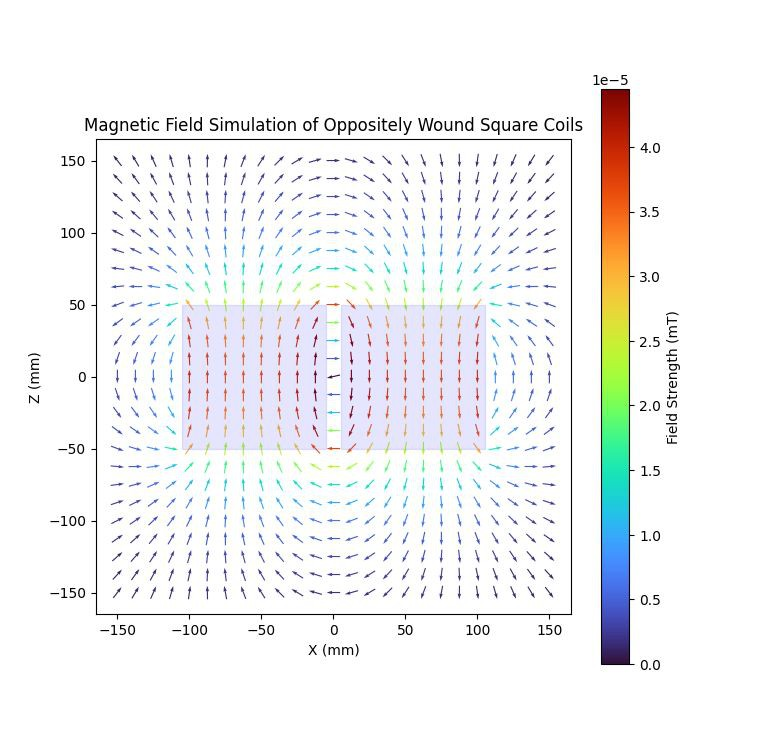
docs/week_2/figures/hook-line_opposed-coil-field-sim.jpg
