ethanewer/ece455/docs/week_2/figures/hook-line_pcb-3d.jpg

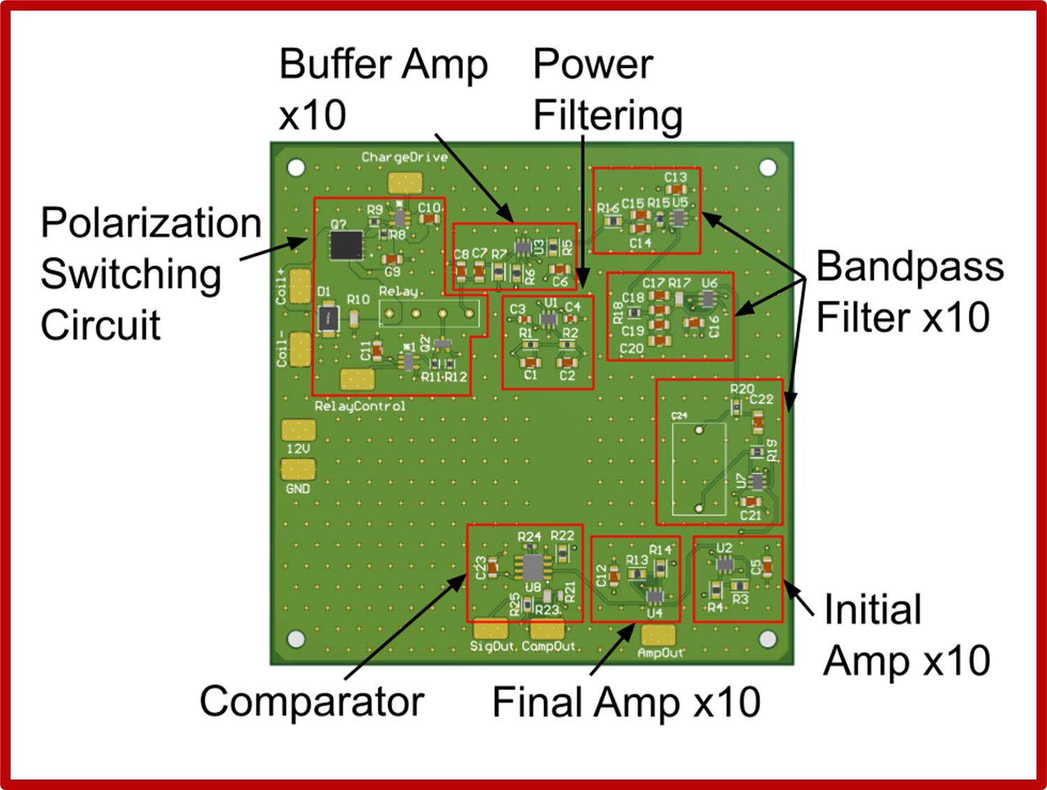
docs/week_2/figures/hook-line_pcb-3d.jpg
