ethanewer/ece455/docs/week_2/figures/hook-line_pcb-sections.jpg

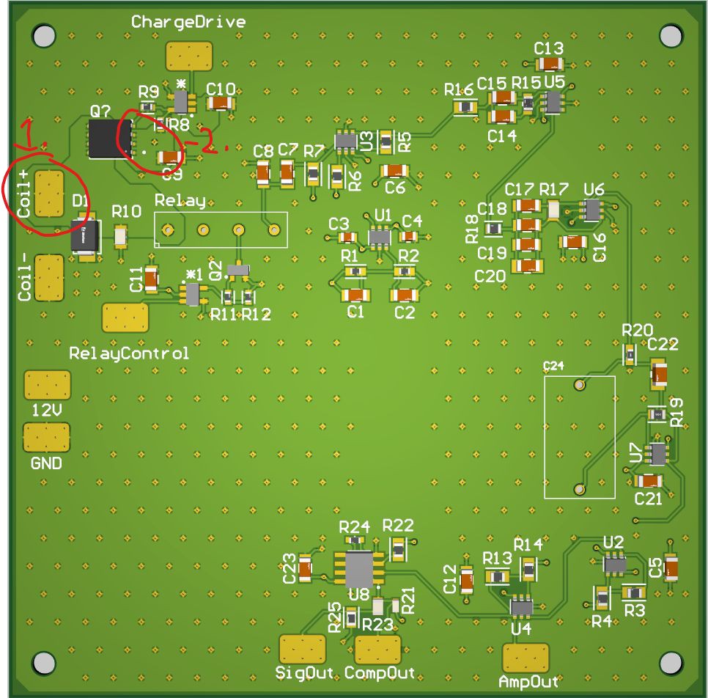
docs/week_2/figures/hook-line_pcb-sections.jpg
