ethanewer/ece455/docs/week_2/figures/hook-line_software-architecture.jpg

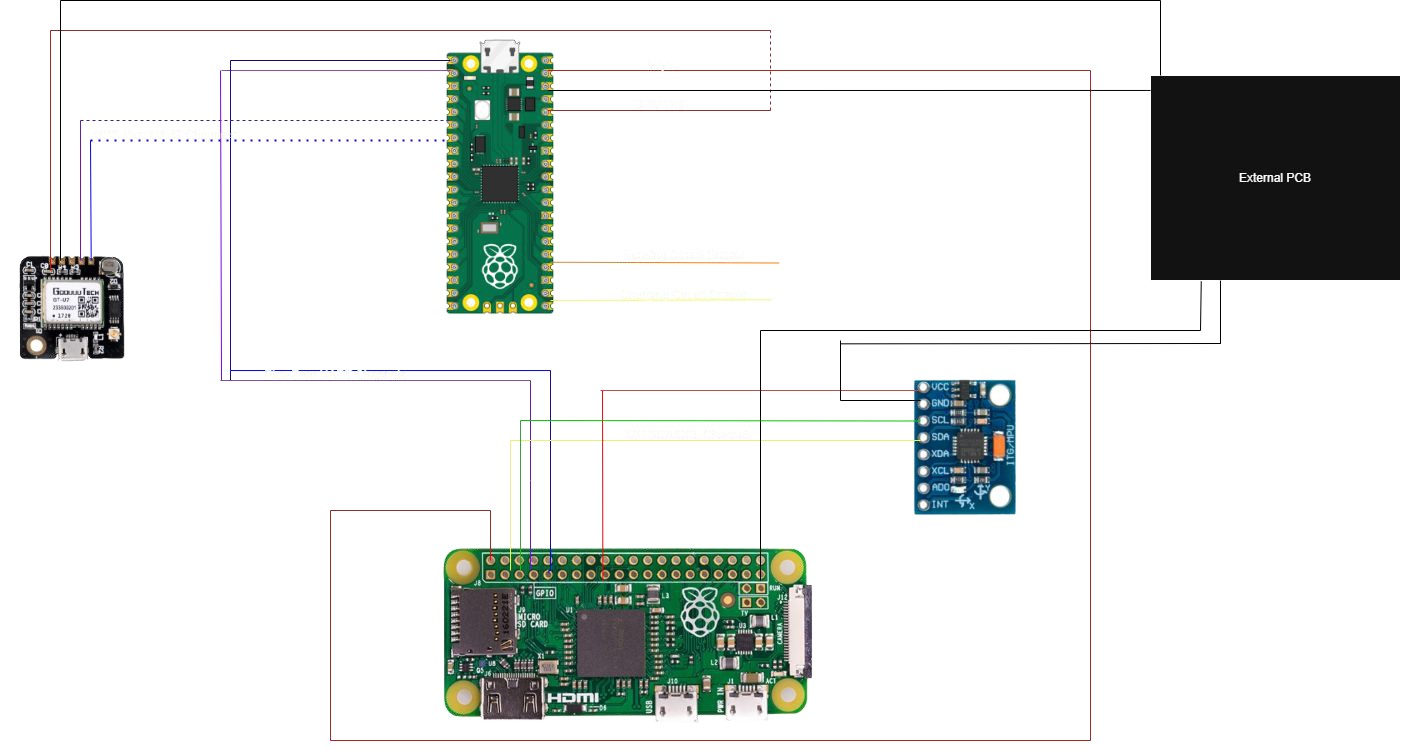
docs/week_2/figures/hook-line_software-architecture.jpg
