ethanewer/ece455/docs/week_2/figures/hook-line_towfish-internal.jpg

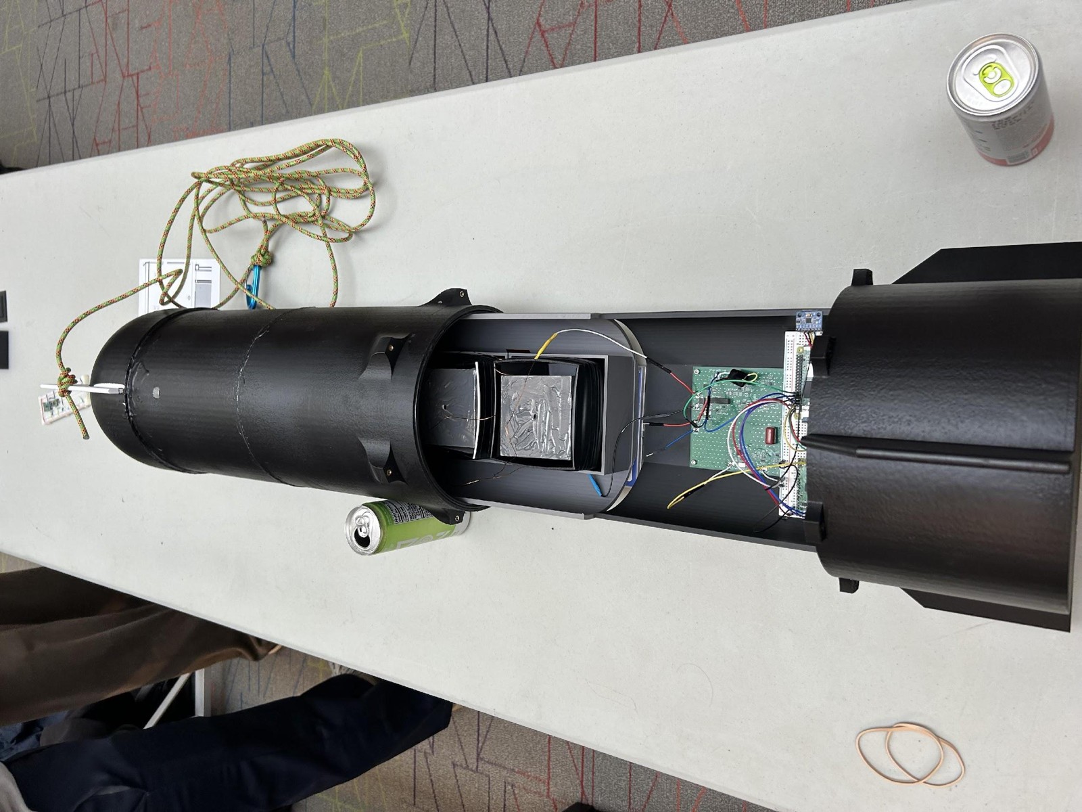
docs/week_2/figures/hook-line_towfish-internal.jpg
