ethanewer/ece455/docs/week_2/figures/hook-line_wound-coil.jpg

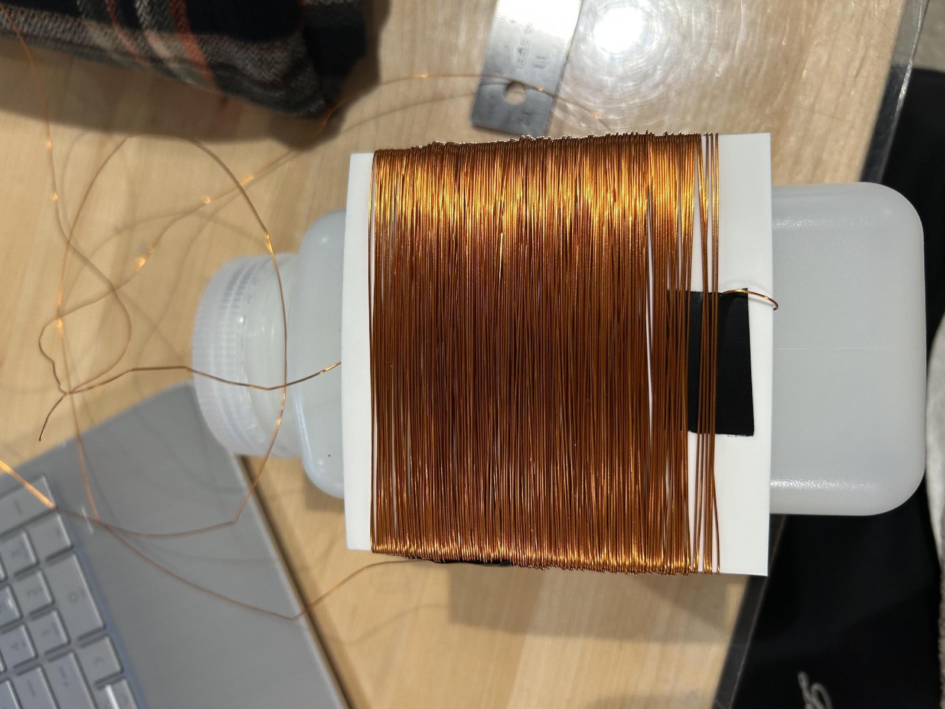
docs/week_2/figures/hook-line_wound-coil.jpg
