ethanewer/ece455/docs/week_2/figures/larmor-lads_function-generator-demo.jpg

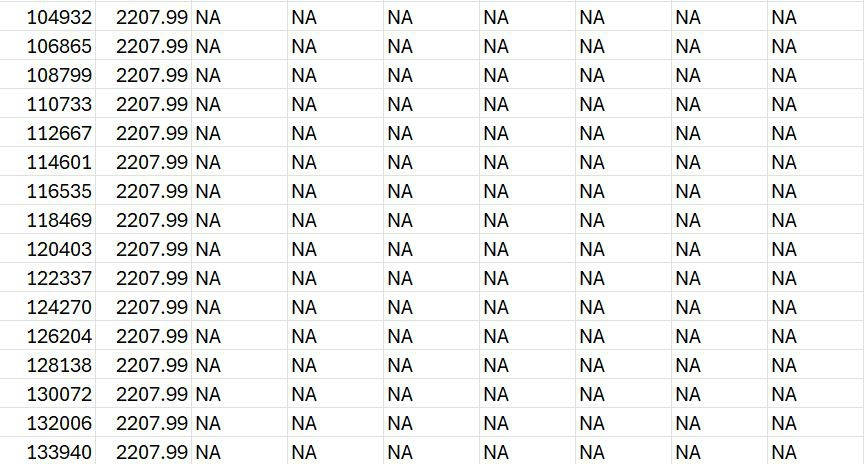
docs/week_2/figures/larmor-lads_function-generator-demo.jpg
