ethanewer/ece455/docs/week_2/figures/larmor-lads_mosfet-breadboard-demo.jpg

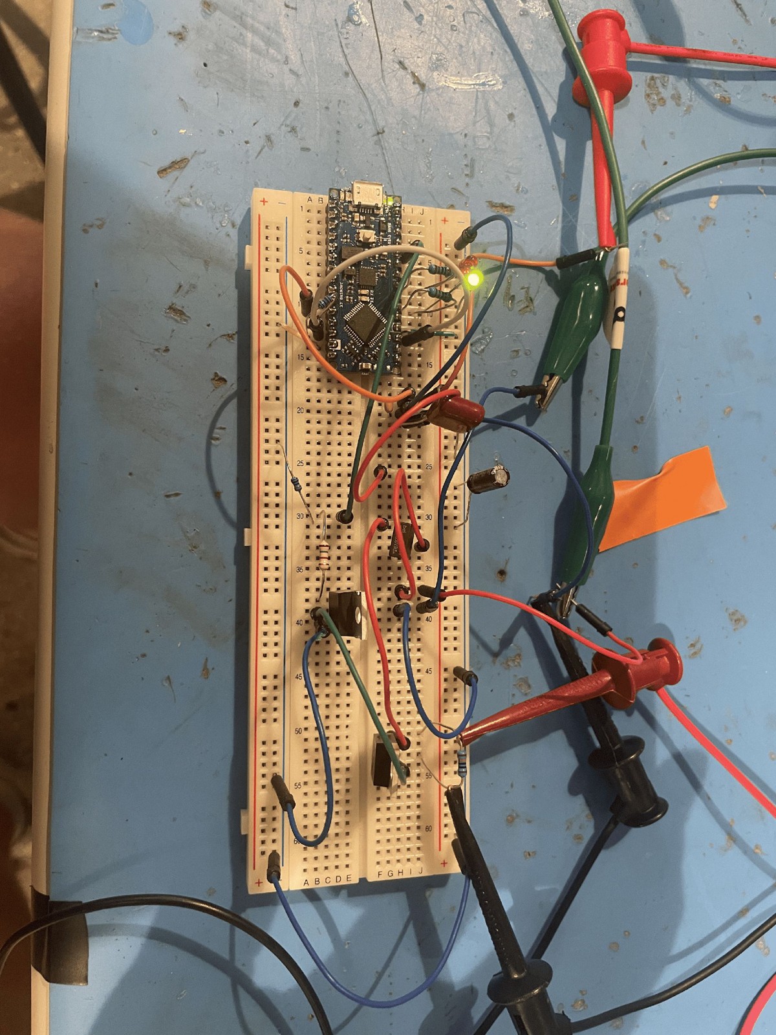
docs/week_2/figures/larmor-lads_mosfet-breadboard-demo.jpg
