ethanewer/ece455/docs/week_2/figures/larmor-lads_opamp-chain-schematic.jpg

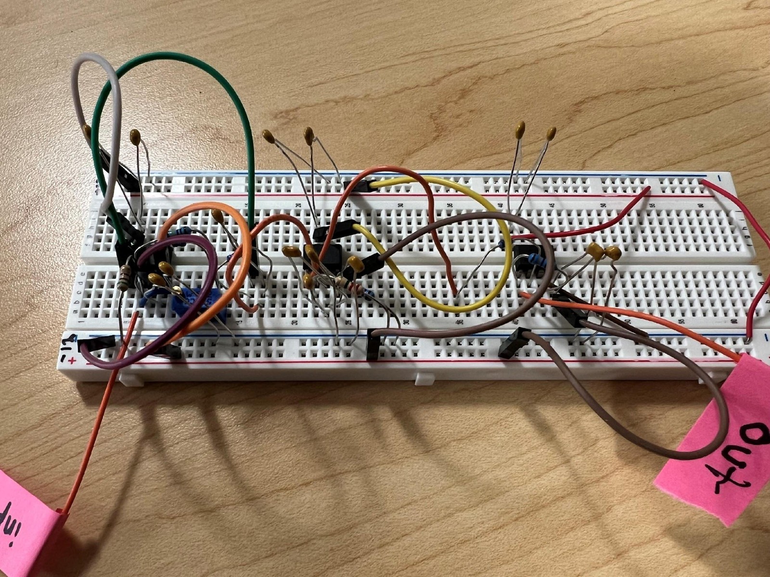
docs/week_2/figures/larmor-lads_opamp-chain-schematic.jpg
