ethanewer/ece455/docs/week_2/figures/larmor-lads_polarization-block-diagram.jpg

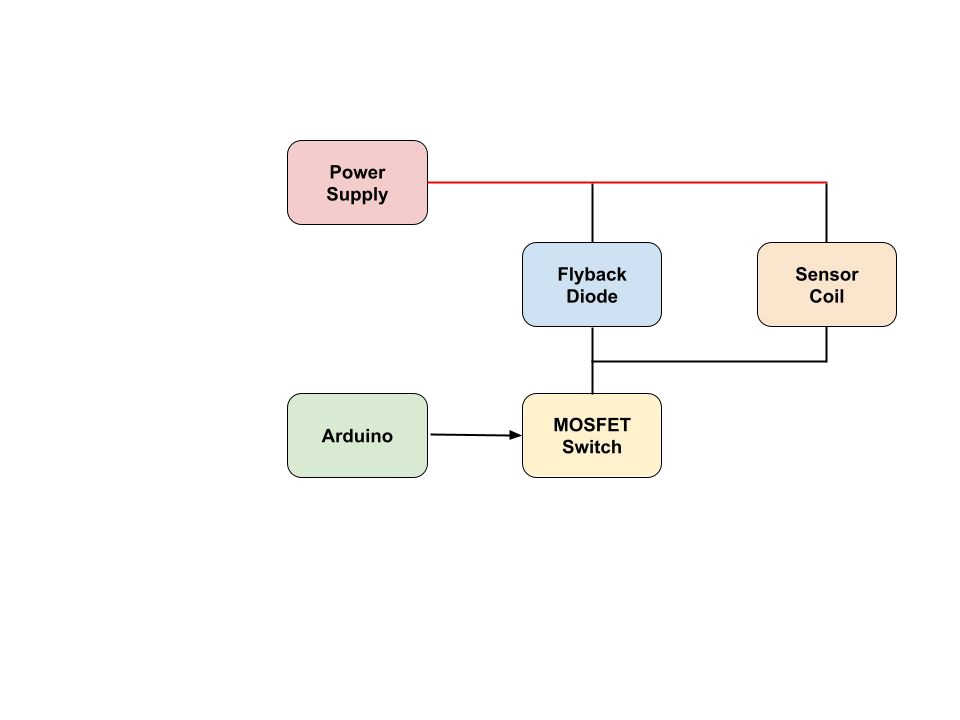
docs/week_2/figures/larmor-lads_polarization-block-diagram.jpg
