ethanewer/ece455/docs/week_2/figures/larmor-lads_polarization-pcb-3d.jpg

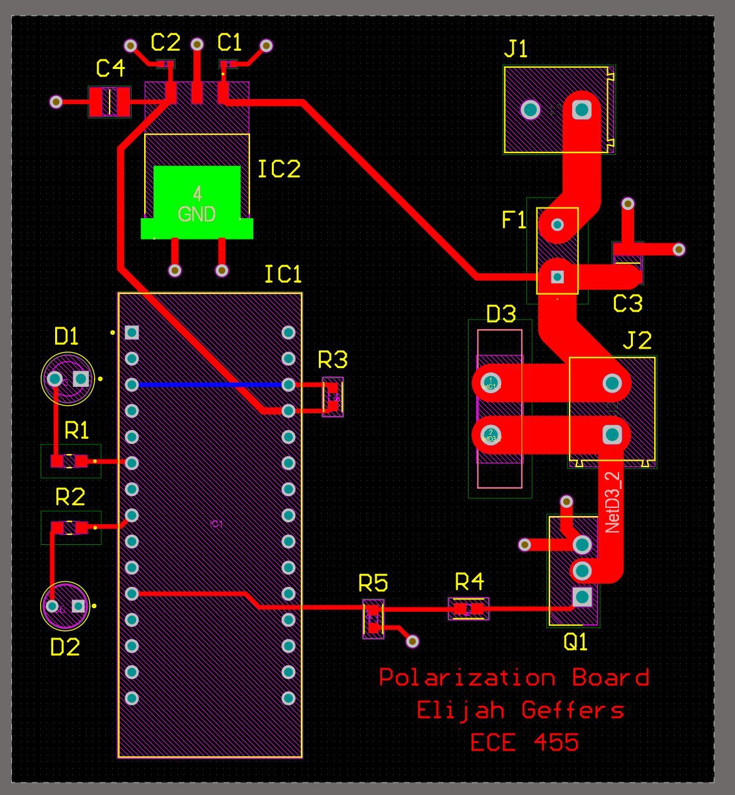
docs/week_2/figures/larmor-lads_polarization-pcb-3d.jpg
