ethanewer/ece455/docs/week_2/figures/larmor-lads_solenoid-field-diagram.jpg

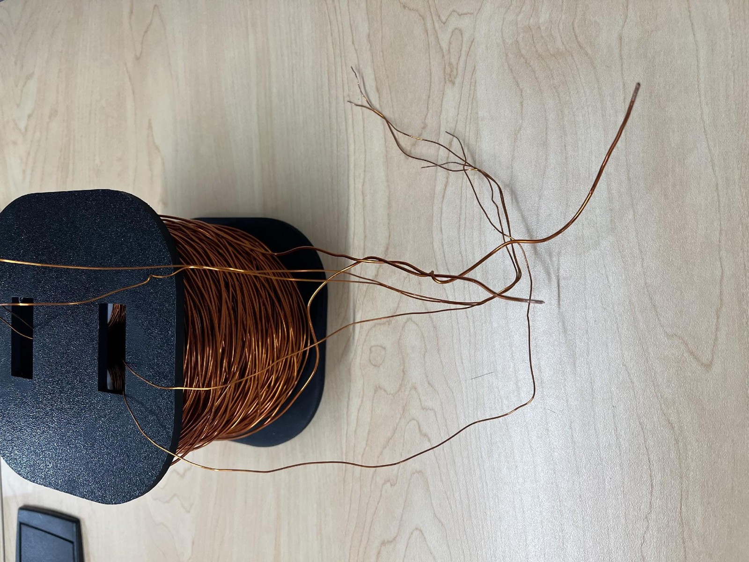
docs/week_2/figures/larmor-lads_solenoid-field-diagram.jpg
