ethanewer/ece455/docs/week_2/figures/towfish-furious_analog-chain-output.jpg

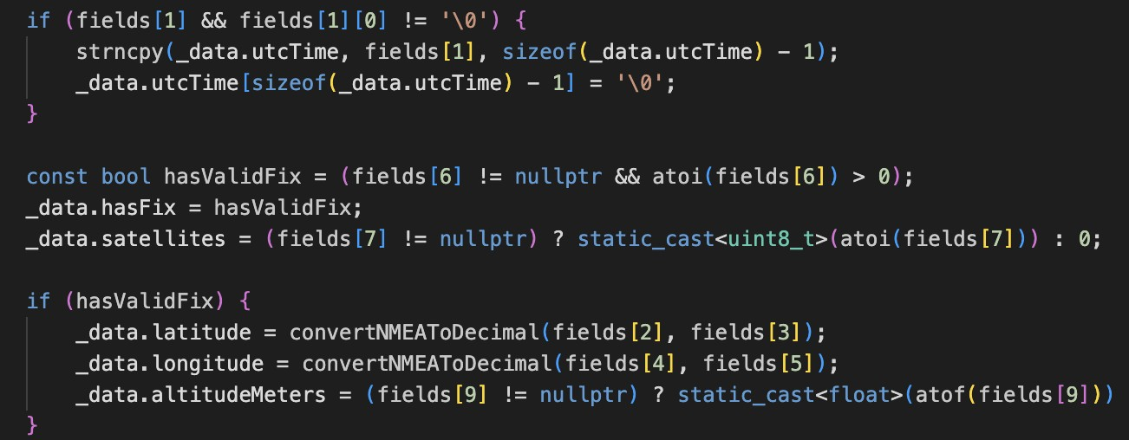
docs/week_2/figures/towfish-furious_analog-chain-output.jpg
