ethanewer/ece455/docs/week_2/figures/towfish-furious_coil-winding.jpg

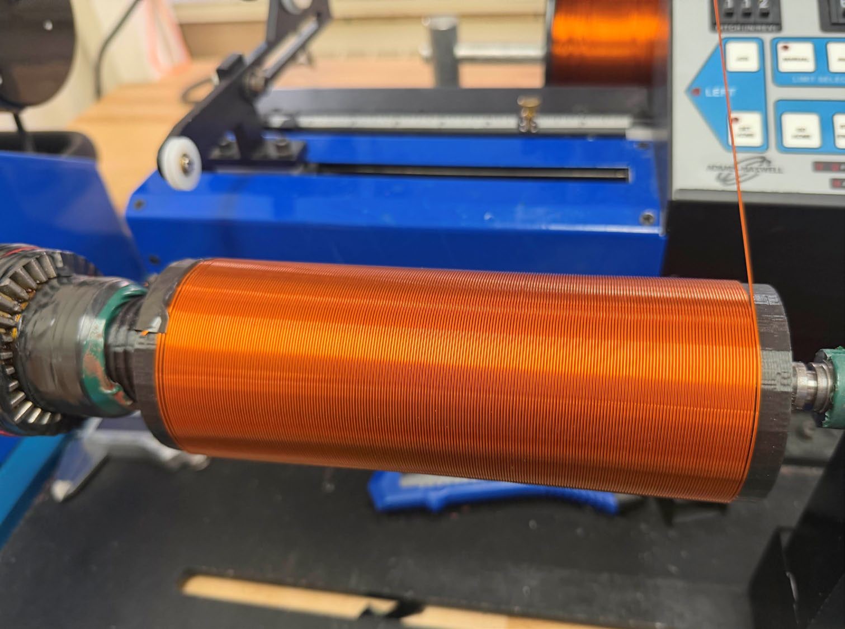
docs/week_2/figures/towfish-furious_coil-winding.jpg
