ethanewer/ece455/docs/week_2/figures/towfish-furious_csv-output.jpg

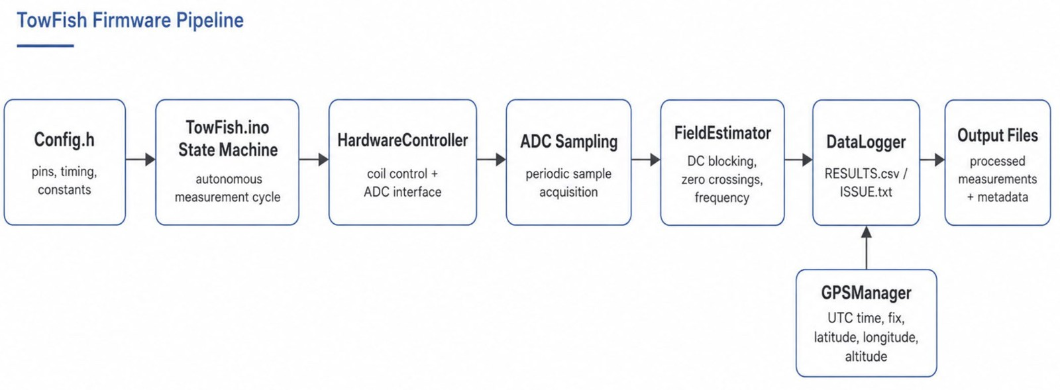
docs/week_2/figures/towfish-furious_csv-output.jpg
