ethanewer/ece455/docs/week_2/figures/towfish-furious_final-coil-bottle-cad.jpg

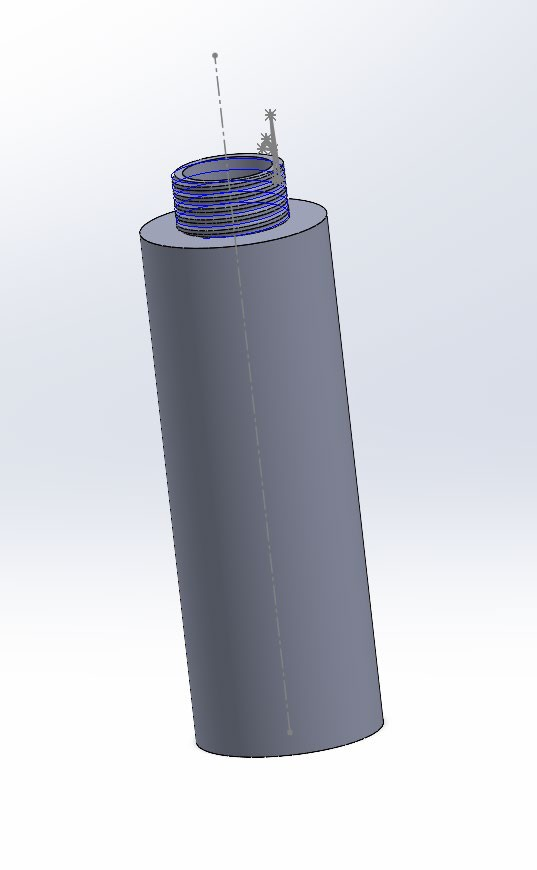
docs/week_2/figures/towfish-furious_final-coil-bottle-cad.jpg
