ethanewer/ece455/docs/week_2/figures/towfish-furious_firmware-architecture.jpg

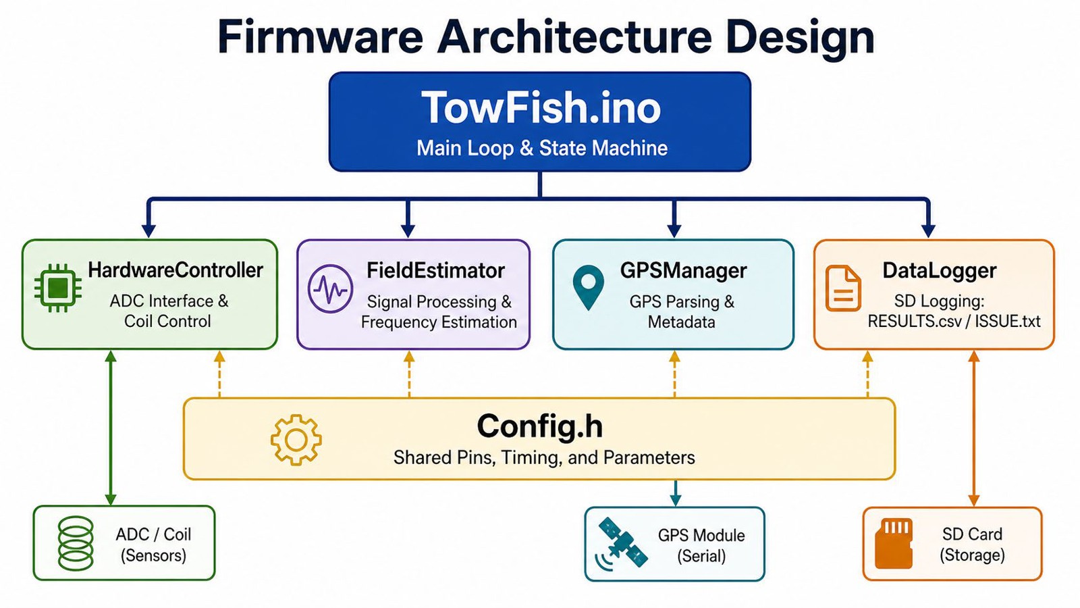
docs/week_2/figures/towfish-furious_firmware-architecture.jpg
