ethanewer/ece455/docs/week_2/figures/towfish-furious_signal-block-diagram.jpg

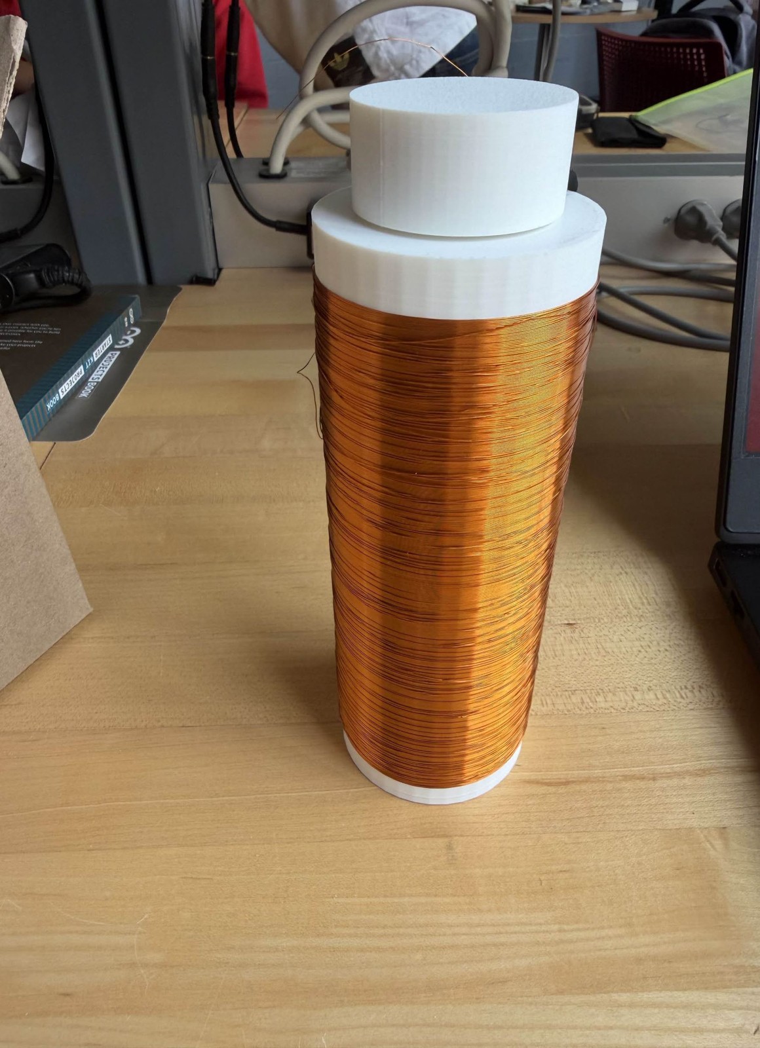
docs/week_2/figures/towfish-furious_signal-block-diagram.jpg
