ethanewer/ece455/docs/week_2/figures/towfish-furious_toroid-cad.jpg

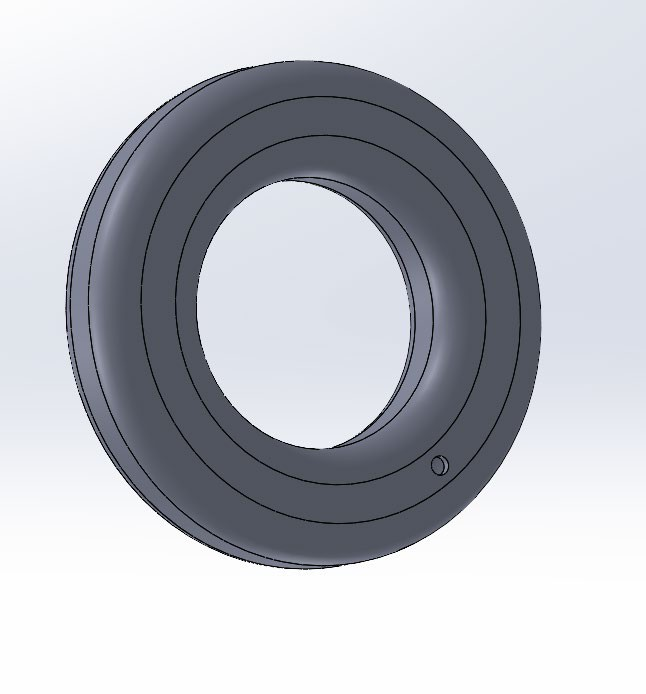
docs/week_2/figures/towfish-furious_toroid-cad.jpg
