ethanewer/ece455/local/board-photo/bb-caps.png

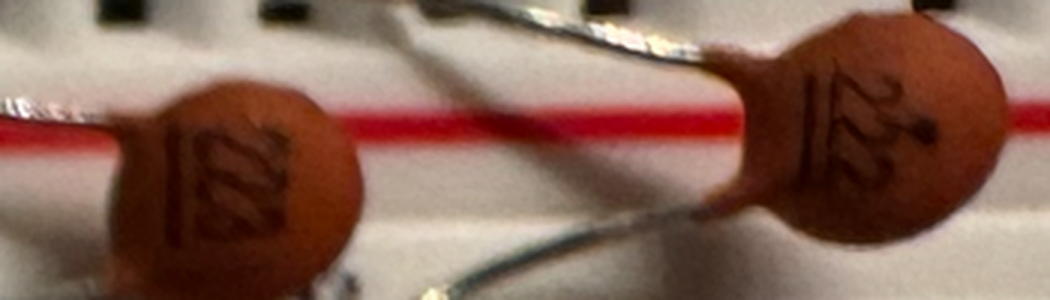
local/board-photo/bb-caps.png
