ethanewer/ece455/local/board-photo/bb-clamps.png

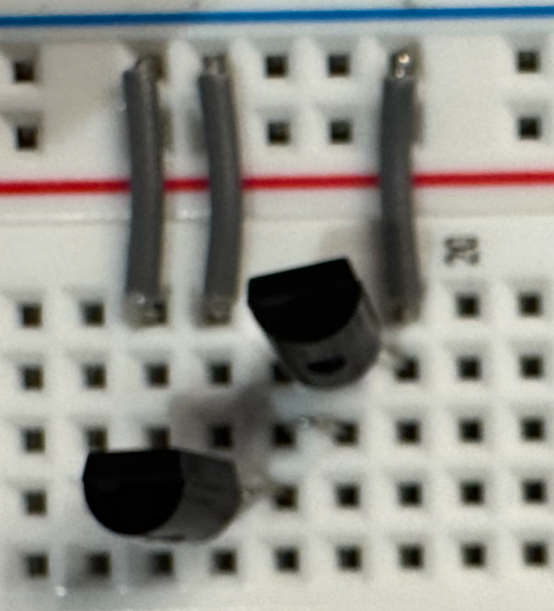
local/board-photo/bb-clamps.png
