ethanewer/ece455/local/board-photo/bb-filter.png

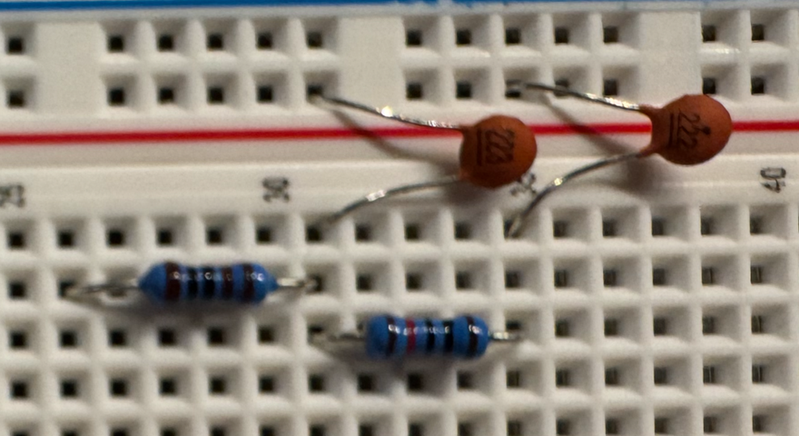
local/board-photo/bb-filter.png
