ethanewer/ece455/local/board-photo/bb-r2.png

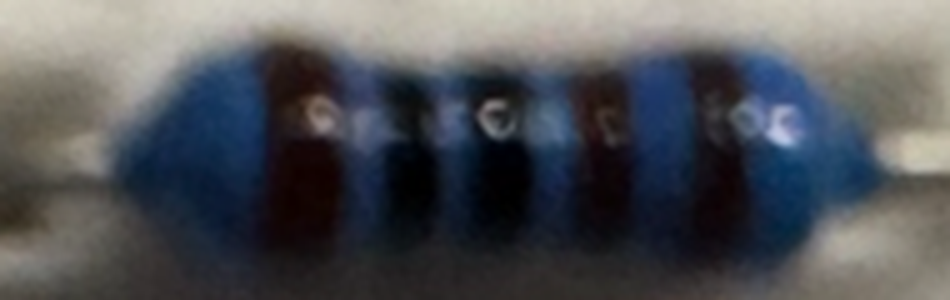
local/board-photo/bb-r2.png
