ethanewer/ece455/local/board-photo/bb-r3.png

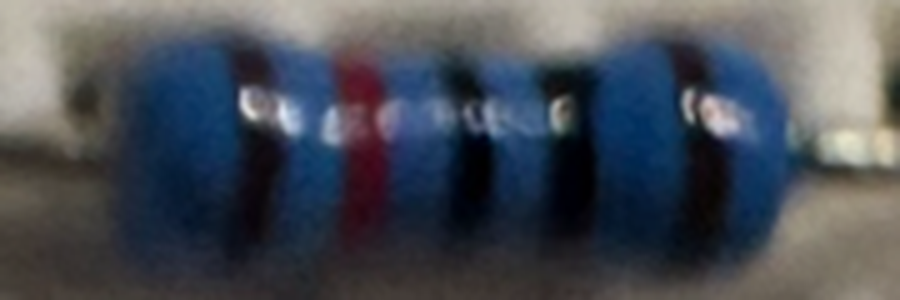
local/board-photo/bb-r3.png
