ethanewer/ece455/local/board-photo/gain.png

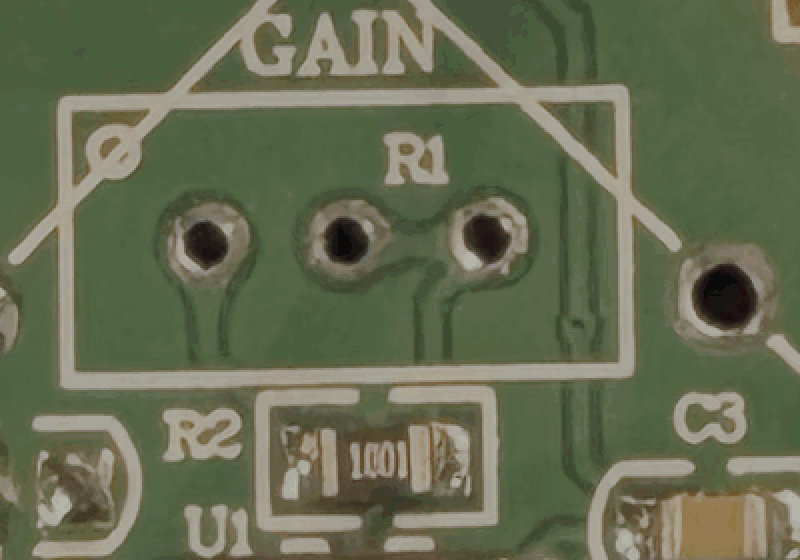
local/board-photo/gain.png
