ethanewer/ece455/local/board-photo/input.png

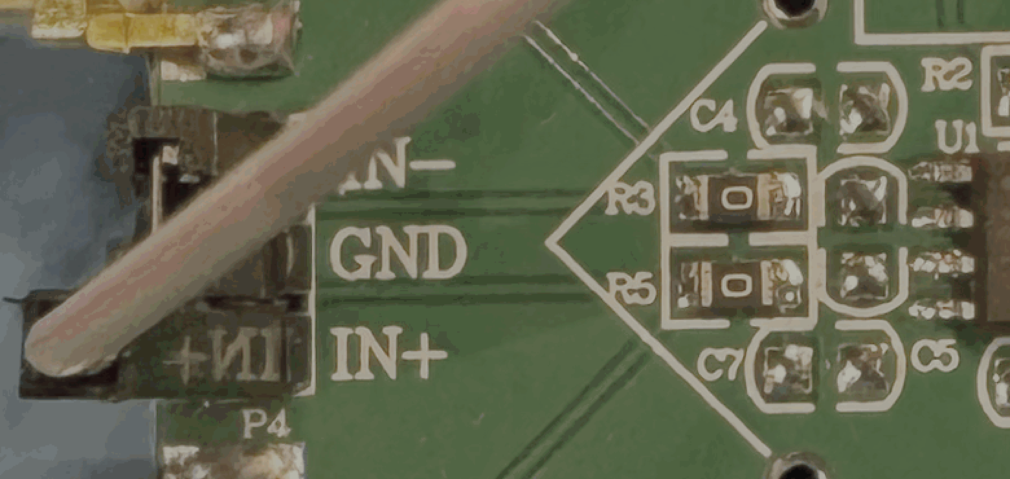
local/board-photo/input.png
