ethanewer/ece455/local/board-photo/ref.png

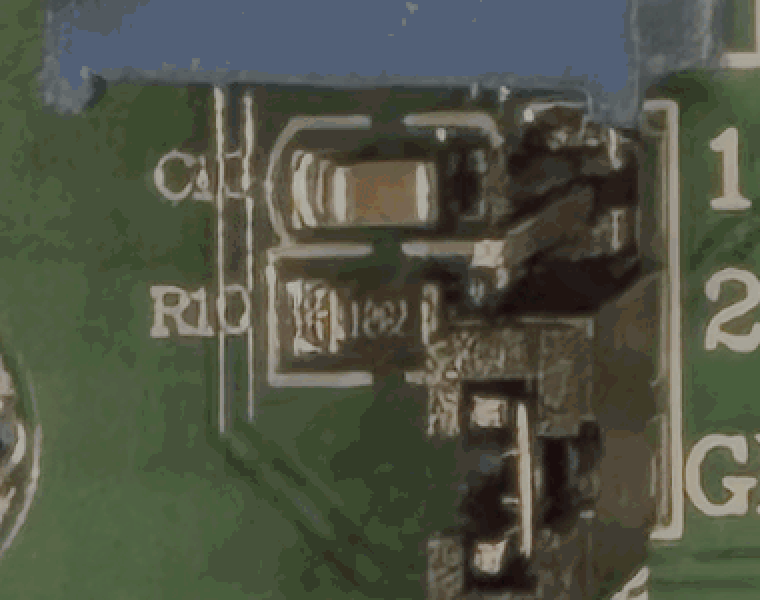
local/board-photo/ref.png
