ethanewer/ece455/From Downloads, Desktop & iCloud/Week8 # Waiting for new amplifier components to arrive # Ethan_Ewer.pdf

# October 21st Progress Report

## Ethan Ewer

## Problem (repeated from last week): Custom Amplifier has a lot of noise

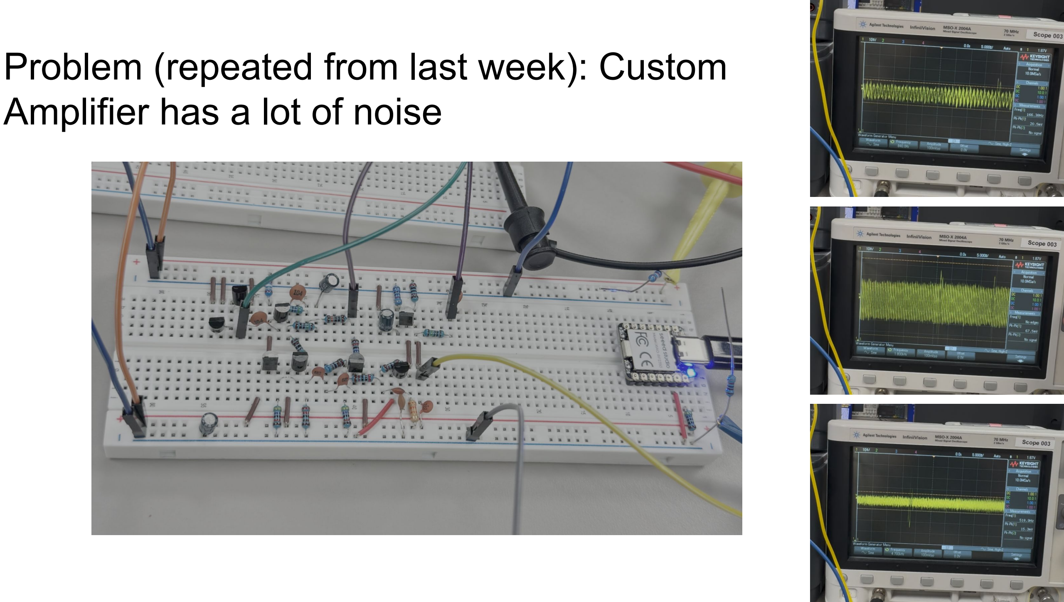
[picture p167: page 2]

## Solution (repeated from last week): - Use an existing design that meets our requirements - Add passive pre-amp and post-amp filters

Requirements:

- Input noise under 4.5 nV/√Hz
- Input impedance over 1 MΩ
- 200 V/V gain
- Bandwidth flat up to 2.2 kHz


## AD8421 selected in pre-built amplifier

Requirements:

- Input noise under 4.5 nV/√Hz (gets 3.2 nV/√Hz)
- Input impedance over 1 MΩ (gets 30 GΩ)
- 200 V/V gain (configurable from 1-10000 V/V)
- Bandwidth flat up to 2.2 kHz (yes)


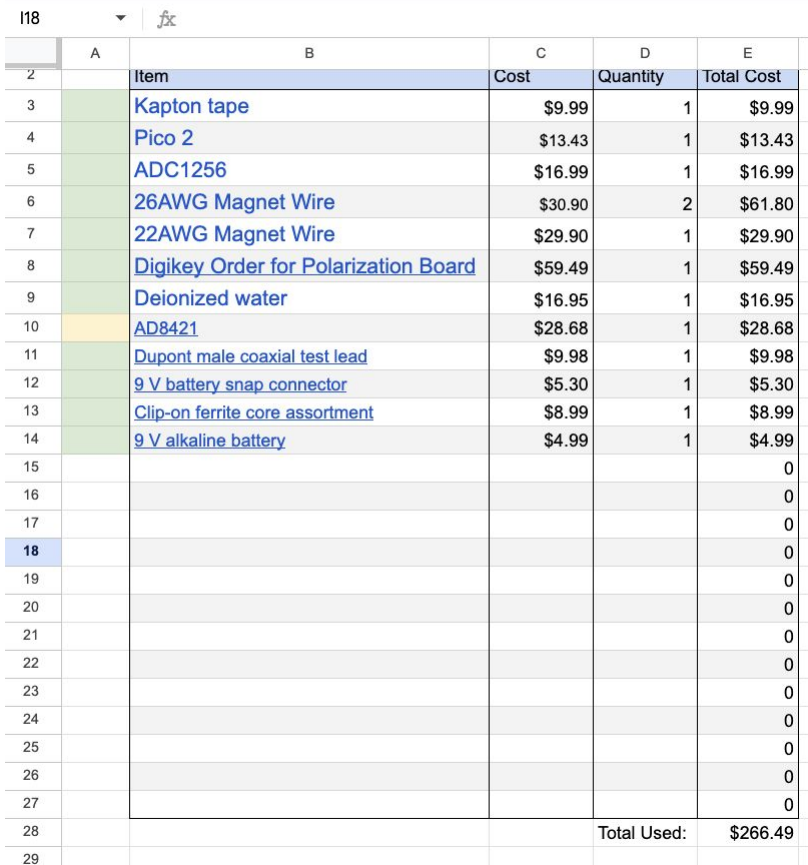
[picture p168: figure]

## Updated BOM

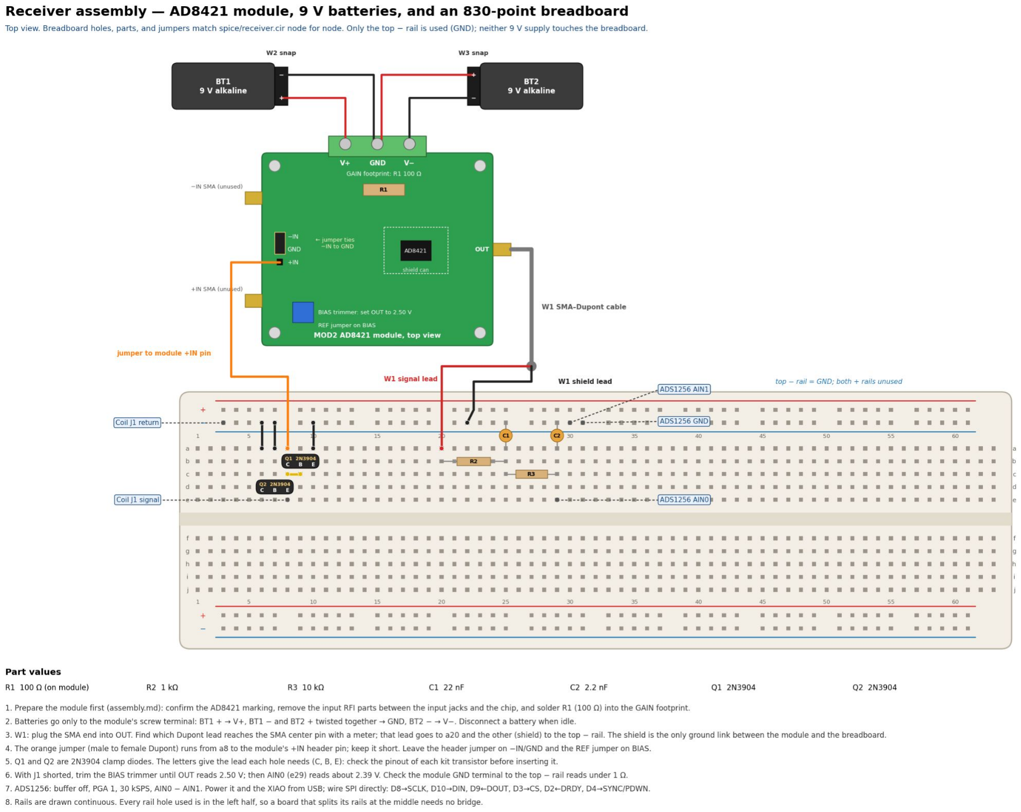
[picture p169: figure]

## Updated Design

## In progress: testing new amplifier (it came this morning)

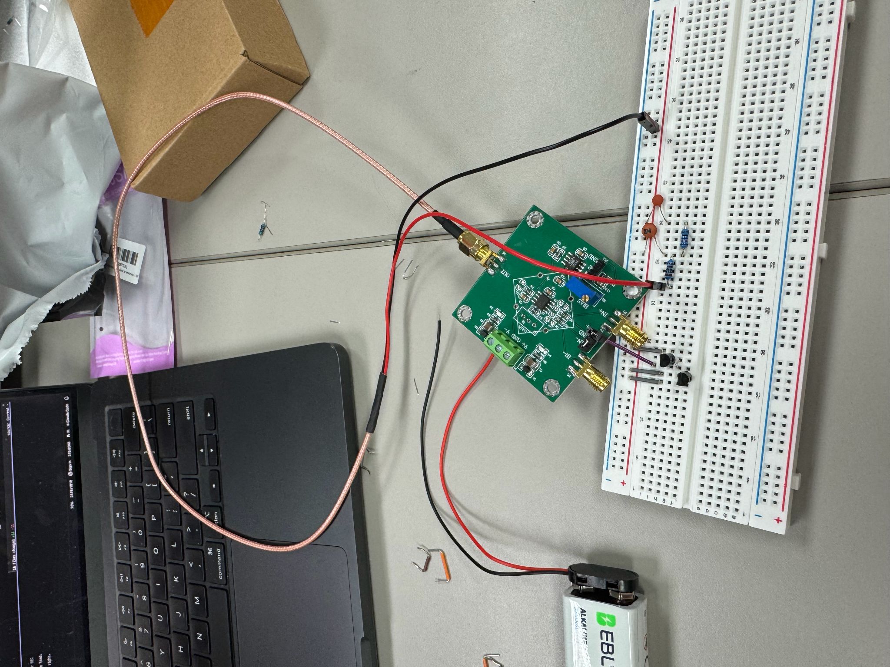
[picture p170: figure]

## Next Steps

- Wait for ordered amplifier to arrive (estimated arrival by 10/26) and then test it
- Test amplifier with ADC and MCU
- Test end-to-end device

## Feedback
