ethanewer/ece455/receiver_design/bom.csv

Reference | Qty | Value or part | Package
R1 | 1 | 100 ohm | Thomson kit axial nominal
R2 | 1 | 1 kohm | Thomson kit axial nominal
R3 | 1 | 10 kohm | Thomson kit axial nominal
C1 | 1 | 22 nF | Thomson kit ceramic nominal
C2 | 1 | 2.2 nF | Thomson kit ceramic nominal
Q1 Q2 | 2 | 2N3904 | Thomson kit TO-92 nominal
MOD2 | 1 | AD8421 instrumentation amplifier module | Amazon purchase
W1 | 1 | SMA male to Dupont male coaxial test lead | Amazon purchase
W2 W3 | 2 | 9 V battery snap connector | Amazon purchase
BT1 BT2 | 2 | 9 V alkaline battery | Amazon purchase
U1 | 1 | Seeed Studio XIAO RP2350 | Already purchased module
MOD1 | 1 | HiLetgo ADS1256 5V 8-channel 24-bit ADC module | Already purchased module
