ethanewer/ece455/kicad/signal_control_board/SignalProcessing&ControlBoard.csv

Reference | Qty | Value | Footprint | Datasheet | Description
A1 | 1 | RaspberryPi_Pico | Module:RaspberryPi_Pico_Common_Unspecified | https://datasheets.raspberrypi.com/pico/pico-datasheet.pdf | Versatile and inexpensive microcontroller module powered by RP2040 dual-core Arm Cortex-M0+ processor up to 133 MHz, 264kB SRAM, 2MB QSPI flash; also supports Raspberry Pi Pico 2
C1 | 1 | 470pF | Capacitor_SMD:C_1206_3216Metric_Pad1.33x1.80mm_HandSolder | https://yageogroup.com/content/datasheet/asset/file/KEM_C1003_C0G_SMD | C1206C471J5GACTU
C2 | 1 | 1nF | Capacitor_SMD:C_1206_3216Metric_Pad1.33x1.80mm_HandSolder | https://www.vishay.com/docs/28580/vjw1hvmlcccommseries.pdf | VJ1206A102JBETW1HV
C3 | 1 | 2.2nF | Capacitor_SMD:C_1210_3225Metric_Pad1.33x2.70mm_HandSolder | https://www.vishay.com/docs/28580/vjw1hvmlcccommseries.pdf | VJ1210A222JXGTW1HV
C4 | 1 | 3.3nF | Capacitor_SMD:C_1206_3216Metric_Pad1.33x1.80mm_HandSolder | https://yageogroup.com/content/datasheet/asset/file/KEM_C1091_C0G_ESD | C1206C332J2GEC7210
C5 | 1 | 4.7nF | Capacitor_SMD:C_1206_3216Metric_Pad1.33x1.80mm_HandSolder | https://product.tdk.com/system/files/dam/doc/product/capacitor/ceramic/mlcc/catalog/mlcc_commercial_midvoltage_en.pdf | C3216C0G2J472J085AA
C6 | 1 | 10nF | Capacitor_SMD:C_1206_3216Metric_Pad1.33x1.80mm_HandSolder | https://yageogroup.com/content/datasheet/asset/file/KEM_C1091_C0G_ESD | C1206C103J1GEC7210
C7 | 1 | 22nF | Capacitor_THT:C_Rect_L13.0mm_W6.0mm_P10.00mm_FKS3_FKP3_MKS4 | https://product.tdk.com/system/files/dam/doc/product/capacitor/film/mkp_mfp/data_sheet/20/20/ds/mmkp_b32641h_b32643h.pdf | B32641H6223J000
C8 | 1 | 47nF | Capacitor_THT:C_Rect_L18.0mm_W6.0mm_P15.00mm_FKS3_FKP3 | https://product.tdk.com/system/files/dam/doc/product/capacitor/film/mkp_mfp/data_sheet/20/20/ds/mmkp_b32641h_b32643h.pdf | B32642H6473J000
C9 | 1 | 82nF | Capacitor_THT:C_Rect_L26.5mm_W6.0mm_P22.50mm_MKS4 | https://product.tdk.com/system/files/dam/doc/product/capacitor/film/mkp_mfp/data_sheet/20/20/ds/mmkp_b32641h_b32643h.pdf | B32643H6823J000
C10 | 1 | 100nF | Capacitor_THT:C_Rect_L18.0mm_W9.0mm_P15.00mm_FKS3_FKP3 | https://product.tdk.com/system/files/dam/doc/product/capacitor/film/mkp_mfp/data_sheet/20/20/ds/mmkp_b32641h_b32643h.pdf | B32642H6104J000
C11 | 1 | 150nF | Capacitor_THT:C_Rect_L18.0mm_W11.0mm_P15.00mm_FKS3_FKP3 | https://product.tdk.com/system/files/dam/doc/product/capacitor/film/mkp_mfp/data_sheet/20/20/ds/mmkp_b32641h_b32643h.pdf | B32642H6154J000
C12 | 1 | 220n | Capacitor_SMD:C_1206_3216Metric_Pad1.33x1.80mm_HandSolder | https://yageogroup.com/content/datasheet/asset/file/KEM_C1090_X7R_ESD | C1206C224K1RECAUTO
C13 | 1 | 2.2u | Capacitor_SMD:C_1206_3216Metric_Pad1.33x1.80mm_HandSolder | https://datasheets.kyocera-avx.com/KGM_X7R.pdf | 12061C225KAT2A
C14,C21 | 2 | 1u | Capacitor_SMD:C_1206_3216Metric_Pad1.33x1.80mm_HandSolder | https://www.vishay.com/docs/45199/vjcommercialseries.pdf | VJ1206Y105KXJAT
C15,C17,C19 | 3 | 0.1u | Capacitor_SMD:C_1206_3216Metric_Pad1.33x1.80mm_HandSolder | https://yageogroup.com/content/datasheet/asset/file/KEM_C1002_X7R_SMD | C1206C104K4RACTU
C16,C20 | 2 | 22u | Capacitor_SMD:C_1206_3216Metric_Pad1.33x1.80mm_HandSolder | https://mm.digikey.com/Volume0/opasdata/d220001/medias/docus/1080/EMK316BB7226ML-T_SS.pdf | EMK316BB7226ML-T
C18 | 1 | 10u | Capacitor_SMD:C_1206_3216Metric_Pad1.33x1.80mm_HandSolder | https://product.tdk.com/system/files/dam/doc/product/capacitor/ceramic/mlcc/catalog/mlcc_automotive_general_en.pdf | CGA5L1X7R1C106K160AC
D1,D2 | 2 | D | Diode_SMD:D_SOD-123 | https://www.vishay.com/docs/86356/1n4148w.pdf | 1N4148W-E3-08
J1 | 1 | SensingCoils | TerminalBlock_Phoenix:TerminalBlock_Phoenix_MKDS-1,5-2-5.08_1x02_P5.08mm_Horizontal | phoenixcontact.com/us/products/1715721/pdf | 1715721
J2 | 1 | Power | TerminalBlock_Phoenix:TerminalBlock_Phoenix_MKDS-1,5-2-5.08_1x02_P5.08mm_Horizontal | phoenixcontact.com/us/products/1715721/pdf | 1715721
J3 | 1 | SPI | Connector_PinSocket_2.54mm:PinSocket_1x08_P2.54mm_Vertical | https://www.sameskydevices.com/product/resource/digikeypdf/ssk02-fph-254.pdf | SSK02-FPH-254-A8
J4 | 1 | AIN | Connector_PinSocket_2.54mm:PinSocket_2x08_P2.54mm_Vertical | sameskydevices.com/product/resource/digikeypdf/ssk04-fph-254.pdf | SSK04-FPH-254-B8
J5 | 1 | Amplifier Input | TerminalBlock_Phoenix:TerminalBlock_Phoenix_MKDS-1,5-2-5.08_1x02_P5.08mm_Horizontal | phoenixcontact.com/us/products/1715721/pdf | 1715721
J6 | 1 | Amplifier Output | TerminalBlock_Phoenix:TerminalBlock_Phoenix_MKDS-1,5-2-5.08_1x02_P5.08mm_Horizontal | phoenixcontact.com/us/products/1715721/pdf | 1715721
J7 | 1 | UART | Connector_PinSocket_2.54mm:PinSocket_1x04_P2.54mm_Vertical | https://www.sameskydevices.com/product/resource/digikeypdf/ssk02-fph-254.pdf | SSK02-FPH-254-A4
L1 | 1 | 22uH | Wurth_7447714220:L_Wurth_7447714220_WE-PD_1050 | https://www.we-online.com/components/products/datasheet/7447714220.pdf | 7447714220
Q1,Q2 | 2 | NMOS | Package_TO_SOT_THT:TO-92_Inline | https://ww1.microchip.com/downloads/en/DeviceDoc/TN0606-N-Channel-Enhancement-Mode-Vertical-DMOS-FET-Data-Sheet-20005935A.pdf | TN0606N3-G
R1 | 1 | 220 | Resistor_SMD:R_1206_3216Metric_Pad1.30x1.75mm_HandSolder | https://www.vishay.com/docs/20043/crcwhpe3.pdf | CRCW1206220RJNEAHP
R2 | 1 | 100 | Resistor_SMD:R_1206_3216Metric_Pad1.30x1.75mm_HandSolder | https://www.seielect.com/catalog/SEI-RNCP.pdf | RNCP1206FTD100R
R3,R6,R7,R8 | 4 | 10k | Resistor_SMD:R_1206_3216Metric_Pad1.30x1.75mm_HandSolder | https://www.seielect.com/catalog/SEI-RMCF_RMCP.pdf | RMCF1206FT10K0
R4 | 1 | 100k | Resistor_SMD:R_1206_3216Metric_Pad1.30x1.75mm_HandSolder | https://yageogroup.com/content/datasheet/asset/file/PYU-RC_GROUP_51_ROHS_L | RC1206FR-07100KL
R5 | 1 | 24.9k | Resistor_SMD:R_1206_3216Metric_Pad1.30x1.75mm_HandSolder | https://yageogroup.com/content/datasheet/asset/file/PYU-RC_GROUP_51_ROHS_L | RC1206FR-0724K9L
R9 | 1 | 510 | Resistor_SMD:R_1206_3216Metric_Pad1.30x1.75mm_HandSolder | https://industrial.panasonic.com/ww/products/pt/general-purpose-chip-resistors/models/ERJ8GEYJ511V | ERJ-8GEYJ511V
RV1 | 1 | 1K Potentiometer | Potentiometer_THT:Potentiometer_Bourns_3296W_Vertical | https://www.bourns.com/docs/product-datasheets/3296.pdf | 3296W-1-102LF
SW1 | 1 | SW_DIP_x03 | Button_Switch_THT:SW_DIP_SPSTx03_Slide_9.78x9.8mm_W7.62mm_P2.54mm | https://www.ctscorp.com/Files/DataSheets/Switches/DIP-Switches/CTS-Switches-DIP-208-Series-Datasheet.pdf | 208-3
SW2 | 1 | SW_DIP_x08 | Button_Switch_THT:SW_DIP_SPSTx08_Slide_9.78x22.5mm_W7.62mm_P2.54mm | https://www.ctscorp.com/Files/DataSheets/Switches/DIP-Switches/CTS-Switches-DIP-208-Series-Datasheet.pdf | 208-8
SW3 | 1 | Button1 | Button_Switch_THT:SW_PUSH_6mm_H9.5mm | https://configured-product-images.s3.amazonaws.com/Datasheets/TL1105.pdf | TL1105BF160Q
SW4 | 1 | Button2 | Button_Switch_THT:SW_PUSH_6mm_H9.5mm | https://configured-product-images.s3.amazonaws.com/Datasheets/TL1105.pdf | TL1105BF160Q
TP1,TP2,TP3,TP4,TP5,TP6 | 6 | TestPoint | TestPoint:TestPoint_Keystone_5000-5004_Miniature | https://www.keyelco.com/userAssets/file/K75p62.pdf | 5001
U1 | 1 | Buck Converter IC | Package_SO:Texas_HTSOP-8-1EP_3.9x4.9mm_P1.27mm_EP2.95x4.9mm_Mask2.4x3.1mm_ThermalVias | https://www.ti.com/lit/ds/symlink/lmr36510.pdf?HQS=dis-dk-null-digikeymode-dsf-pf-null-wwe&ts=1791384474900 | LMR36510ADDAR
U2 | 1 | Buffer | Package_TO_SOT_SMD:SOT-23-5 | https://www.ti.com/lit/ds/symlink/opa320.pdf?HQS=dis-dk-null-digikeymode-dsf-pf-null-wwe&ts=1791392075697 | OPA320AIDBVR
