ethanewer/ece455/receiver_design/digikey_missing_components.csv

item | cost | quantity | total cost
[Seeed Studio XIAO RP2350 - already purchased](https://www.digikey.com/en/products/detail/seeed-technology-co-ltd/102010550/24814463) | N/A | 1 | 0.00
[HiLetgo ADS1256 module - already purchased; no DigiKey module listing](https://www.amazon.com/dp/B09KGXC44Q) | N/A | 1 | 0.00
