ethanewer/ece455/3d_models/Coil Frame V2.SLDPRT

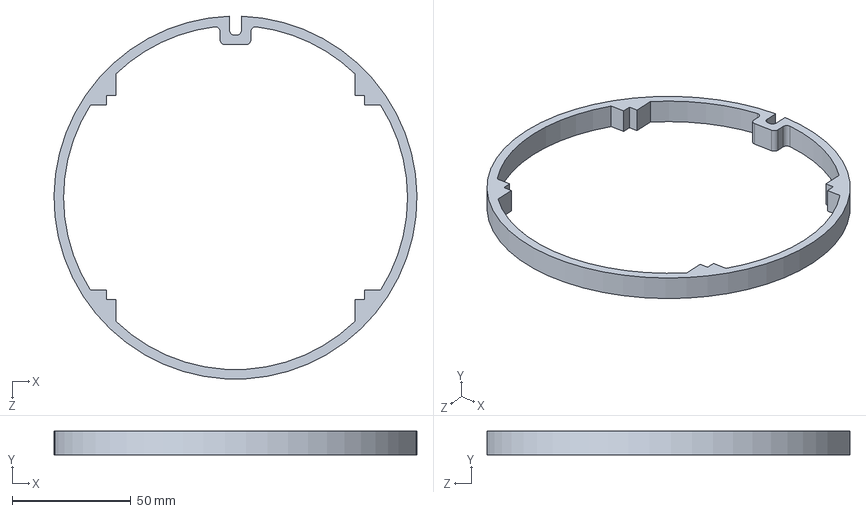
[picture p171: CAD file, 2026-11-12]
3d_models/Coil Frame V2.SLDPRT
153.1 x 10.0 x 152.9 mm
