ethanewer/ece455/3D_Modeling/Sensor coil V1.SLDPRT

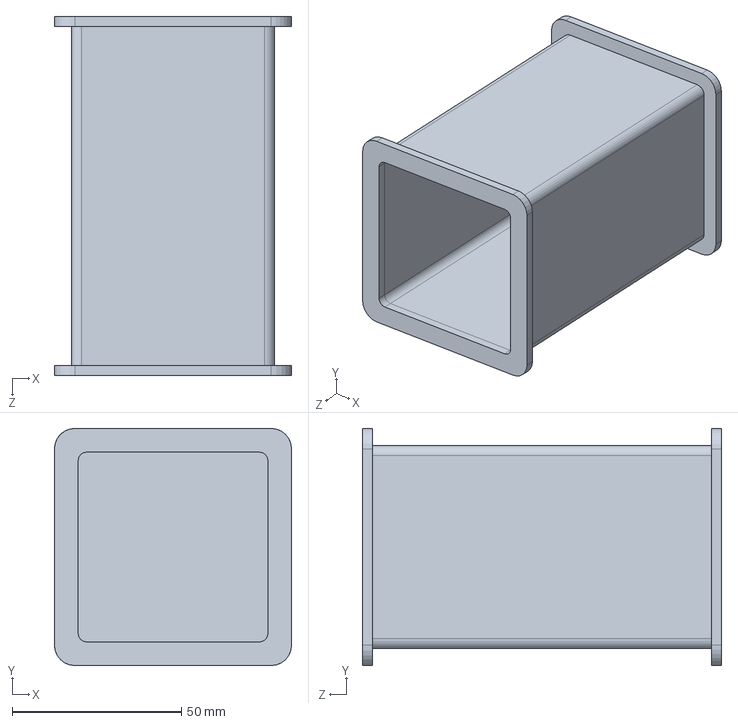
[picture p172: CAD file, 2026-09-17]
3D_Modeling/Sensor coil V1.SLDPRT
70.0 x 70.0 x 106.0 mm
