ethanewer/ece455/3D_Modeling/Polarization Coil V1.SLDPRT

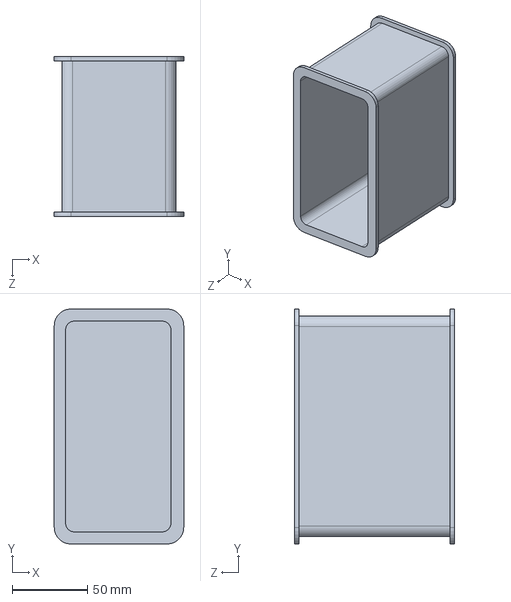
[picture p173: CAD file, 2026-09-17]
3D_Modeling/Polarization Coil V1.SLDPRT
86.0 x 156.0 x 106.0 mm
