ethanewer/ece455/(list of files, cad)

Other CAD files:
3D_Modeling/Polarization Coil V1.gcode.3mf
3d_models/Coil Frame V2.gcode.3mf
3D_Modeling/Sensor coil V1.gcode.3mf
3d_models/Polarization Coil V2.gcode.3mf
3d_models/Polarization Coil V2.SLDPRT
3d_models/Coil Frame V1.gcode.3mf
3d_models/Coil Frame V1.SLDPRT
