ethanewer/ece455/From Downloads, Desktop & iCloud/Week6 # Building and Testing the Singnal Processing Pipeline # Ethan_Ewer.pdf

# October 7th Progress Report

## Ethan Ewer

## Used Claude to build a breadboard layout for a circuit netlist

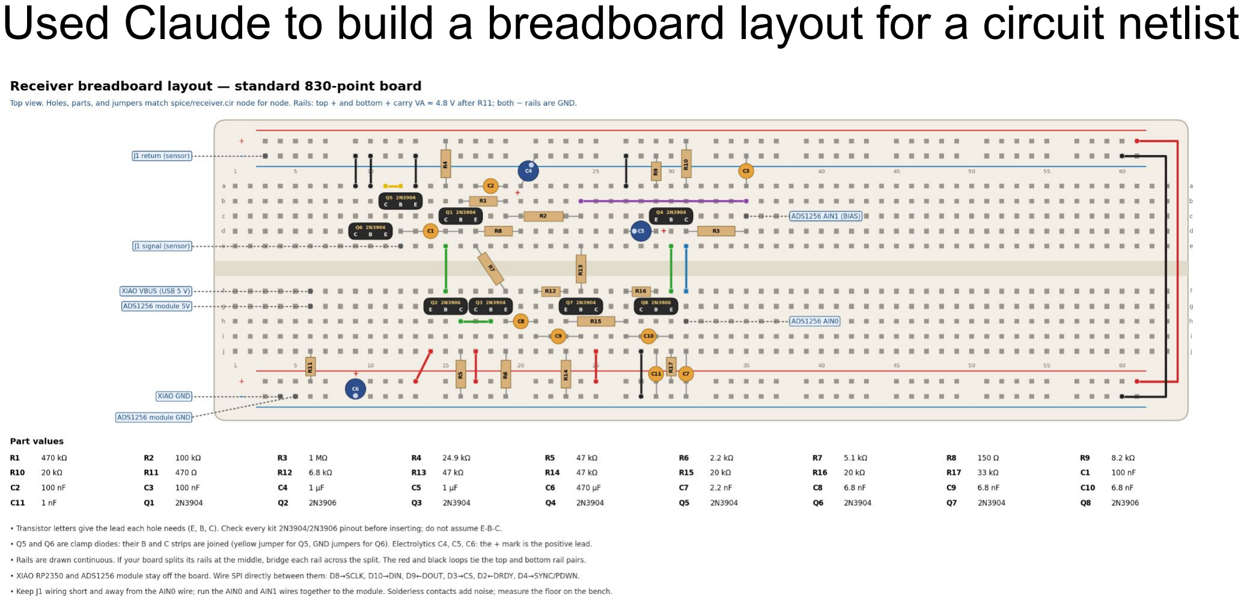
[picture p174: page 2]

## Assembled amplifier and band pass filter circuit

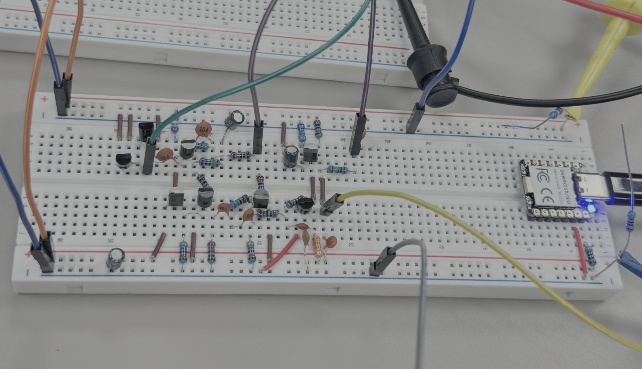
[picture p175: figure]

## Measured amplifier gain as ~3600 V/V in passband, and lower outside

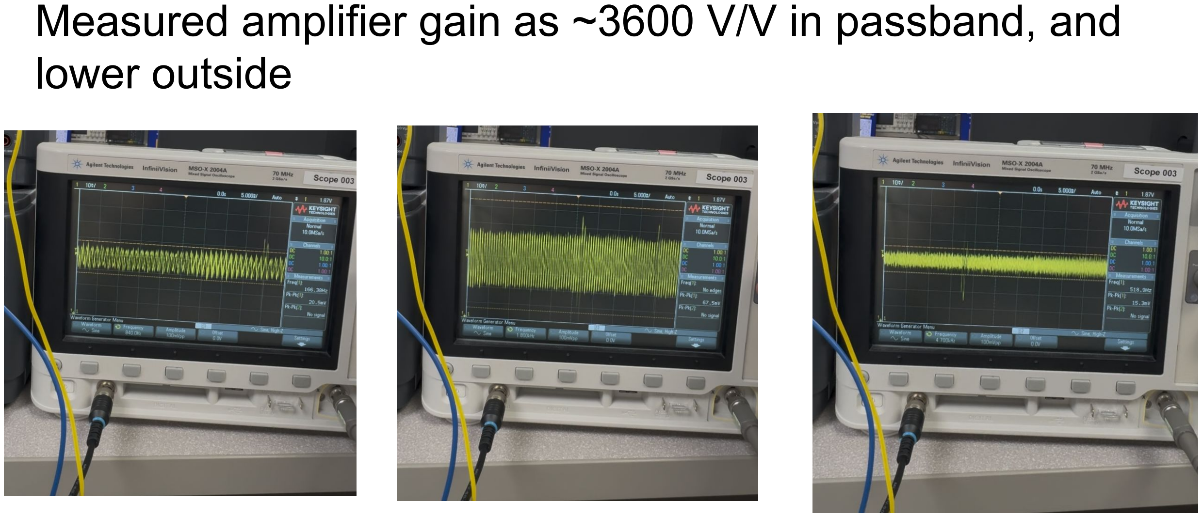
[picture p176: page 4]

## Next Steps

- Make circuit on a PCB
- Redesign the amplifier with op-amps instead of transistors (transistors were used because they were in the Thomson lab kits)
- Test amplifier with the rest of the system
