ethanewer/ece455/docs/week_2/figures/larmor-lads_assembled-pcb-bottom.jpg

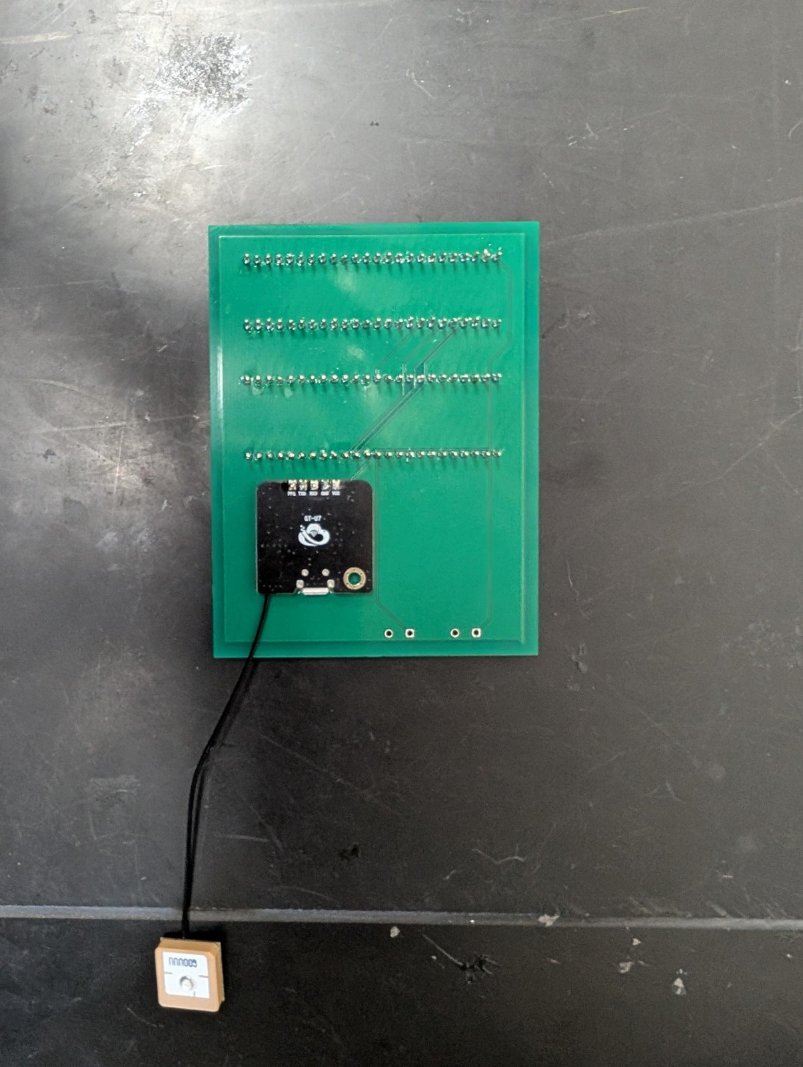
docs/week_2/figures/larmor-lads_assembled-pcb-bottom.jpg
