ethanewer/ece455/spreadsheets/TuningCapacitors.xlsx

Proton Precession Magnetometer | LC Tuning
100 equally spaced capacitances | 0–400 nF | two series sensing coils
Coil 1 inductance (mH) | 13.450 |  |  |  | MODEL NOTES
Coil 2 inductance (mH) | 13.130 |  |  |  | Ideal LC: f = 1 / (2π√(LC)); B = f / 0.04257747892 (nT).
Series inductance (mH) | 26.580 |  |  |  | At 0 nF, ideal LC resonance is undefined (frequency and field are blank).
Proton ratio (Hz/nT) | 0.0425774789 |  |  |  | Series inductance assumes negligible mutual coupling; real coil coupling and stray C shift resonance.
Maximum capacitance (nF) | 400.00 |  |  |  | Frequency/field are LC tuning equivalents, not direct measurements of Earth's magnetic field.
Number of points | 100
Step size (nF) | 4.040404 |  |  |  | Existing 11-capacitor bank reference (not one of the 100 equal steps)
 |  |  |  |  | Nominal bank total (nF) | 392.67 | Frequency (Hz) | 1557.86 | Field (nT) | 36588.85673
Point | Capacitance (nF) | Frequency (Hz) | Magnetic field (nT) | Magnetic field (µT)
1 | 0.000
2 | 4.040 | 15357.84 | 360703.4551 | 360.703
3 | 8.081 | 10859.64 | 255055.8591 | 255.056
4 | 12.121 | 8866.86 | 208252.2369 | 208.252
5 | 16.162 | 7678.92 | 180351.7276 | 180.352
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
