ethanewer/ece455/docs/simulation/tuning-bank.csv

target_hz | field_ut | coil | inductance_mh | required_nf | bank_nf | tuned_hz | capacitors | switches
1500.0000 | 35.2308 | TuningCapacitors.xlsx | 26.5800 | 423.5481 | 422.6700 | 1501.5574 | C11 C10 C9 C8 C7 C6 C5 C4 C3 C2 C1 | SW1-1 SW1-2 SW1-3 SW2-1 SW2-2 SW2-3 SW2-4 SW2-5 SW2-6 SW2-7 SW2-8
1500.0000 | 35.2308 | AmplificationSim.asc | 28.1100 | 400.4948 | 400.6700 | 1499.6720 | C11 C10 C9 C8 C6 C5 C4 C3 C2 C1 | SW1-1 SW1-2 SW1-3 SW2-1 SW2-3 SW2-4 SW2-5 SW2-6 SW2-7 SW2-8
1750.0000 | 41.1026 | TuningCapacitors.xlsx | 26.5800 | 311.1782 | 311.2000 | 1749.9388 | C11 C9 C8 C7 C5 C4 C3 | SW1-1 SW1-3 SW2-1 SW2-2 SW2-4 SW2-5 SW2-6
1750.0000 | 41.1026 | AmplificationSim.asc | 28.1100 | 294.2411 | 294.1700 | 1750.2114 | C11 C9 C8 C6 C5 C1 | SW1-1 SW1-3 SW2-1 SW2-3 SW2-4 SW2-8
2000.0000 | 46.9744 | TuningCapacitors.xlsx | 26.5800 | 238.2458 | 238.1700 | 2000.3183 | C11 C9 C5 C2 C1 | SW1-1 SW1-3 SW2-4 SW2-7 SW2-8
2000.0000 | 46.9744 | AmplificationSim.asc | 28.1100 | 225.2783 | 225.2000 | 2000.3478 | C10 C9 C7 C6 C5 C4 C3 C2 | SW1-2 SW1-3 SW2-2 SW2-3 SW2-4 SW2-5 SW2-6 SW2-7
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
