ethanewer/ece455/docs/week_2/figures/finding-titan_measurement-state-machine.jpg

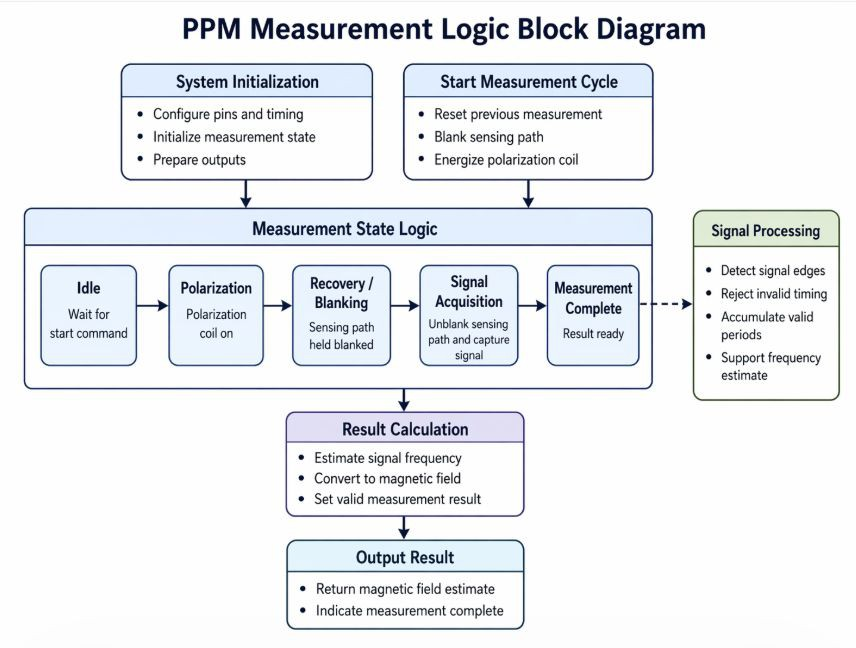
docs/week_2/figures/finding-titan_measurement-state-machine.jpg
