ethanewer/ece455/docs/past_work/proton_magnetometer/Magnetometer Detection Assessment - Vietnam Aircraft Recovery.pdf

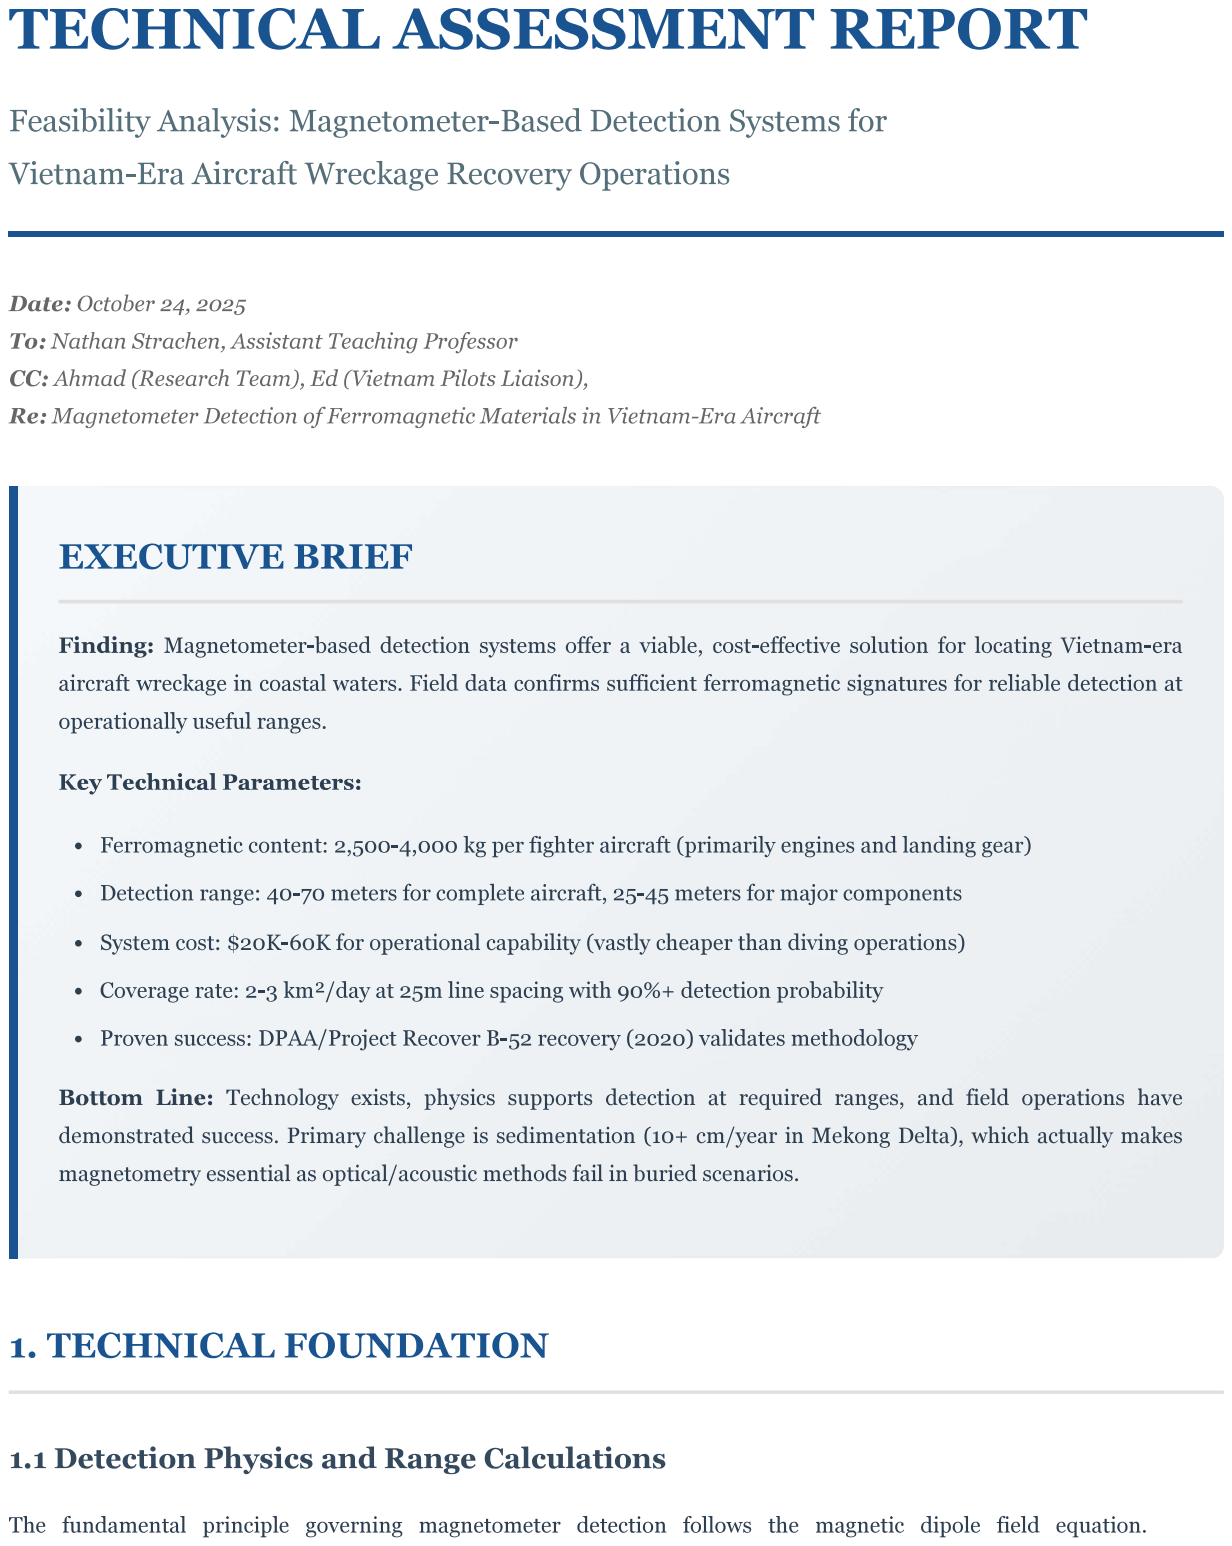
[picture p184: page 1]

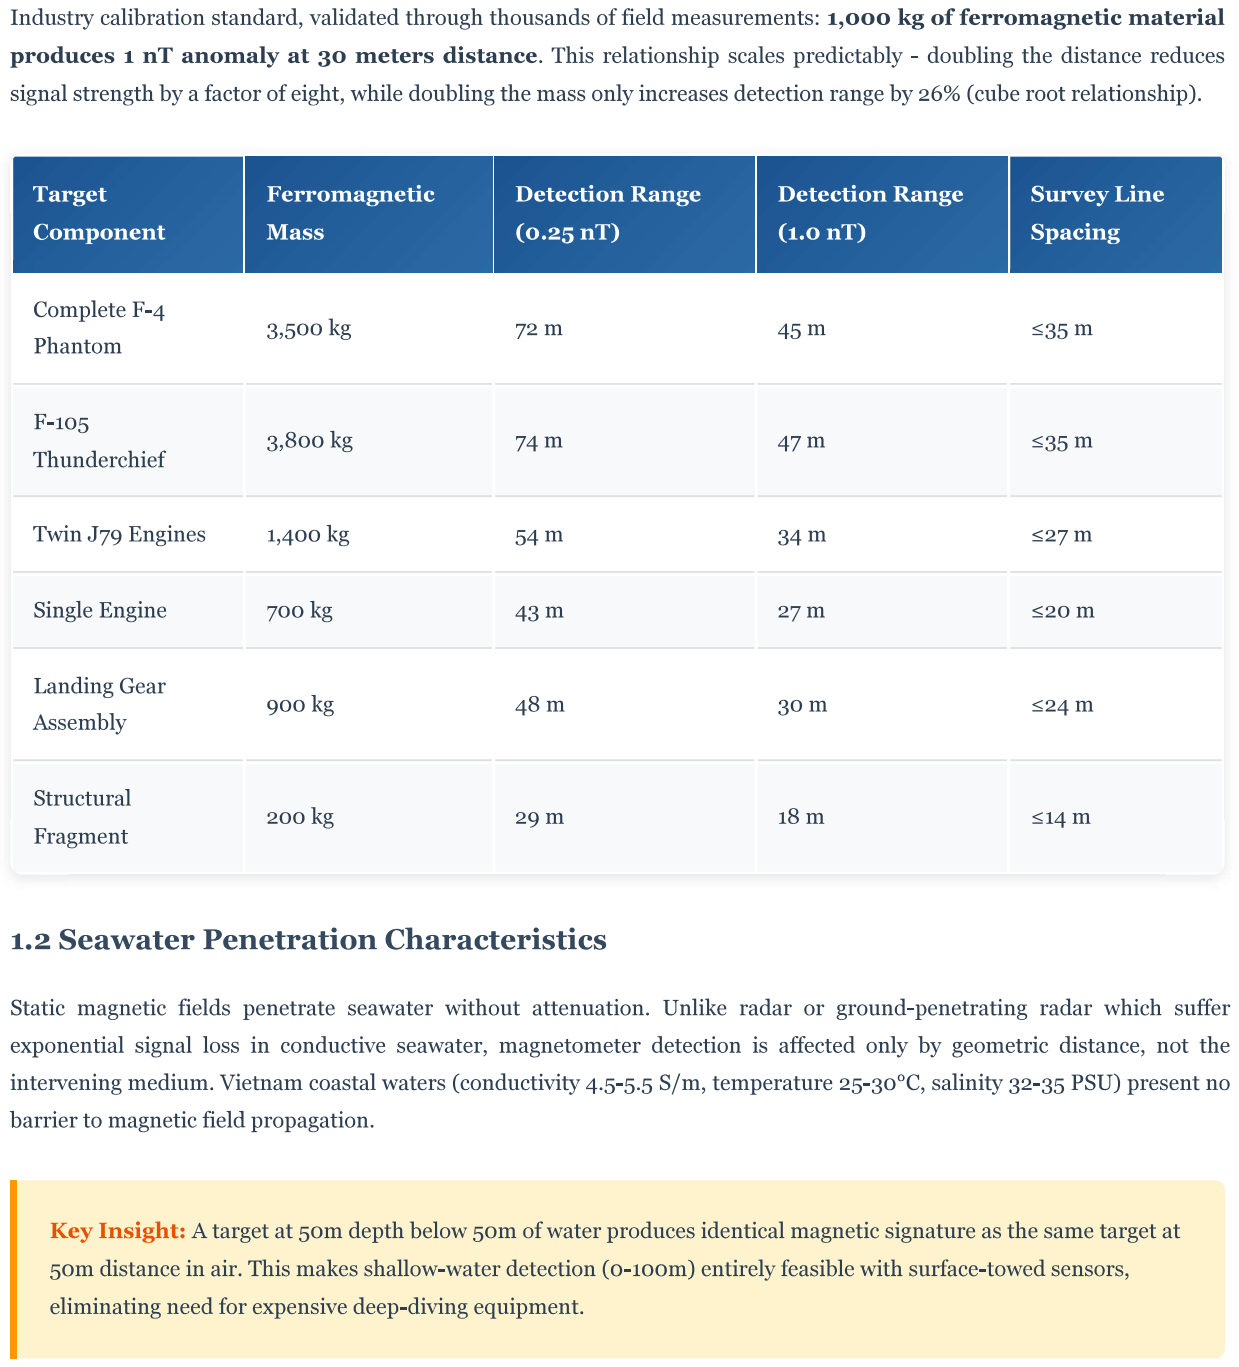
[picture p185: page 2]

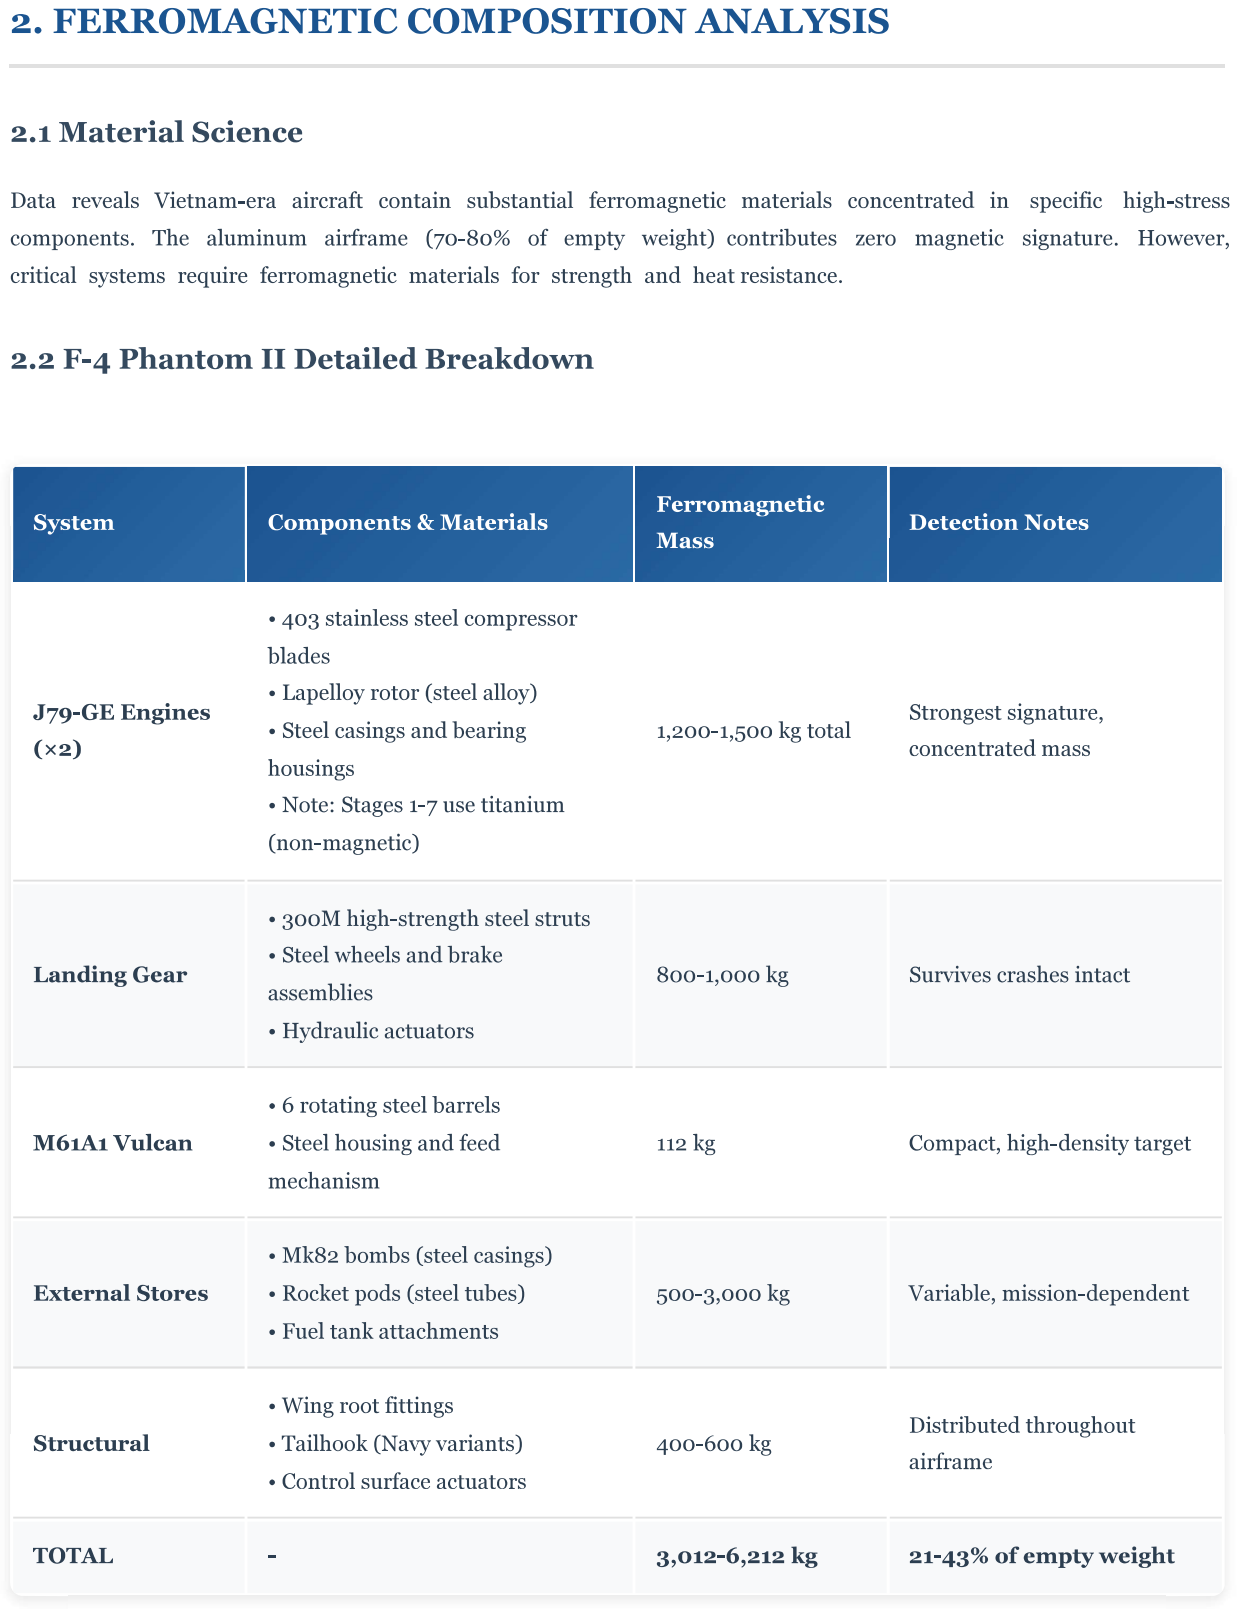
[picture p186: page 3]

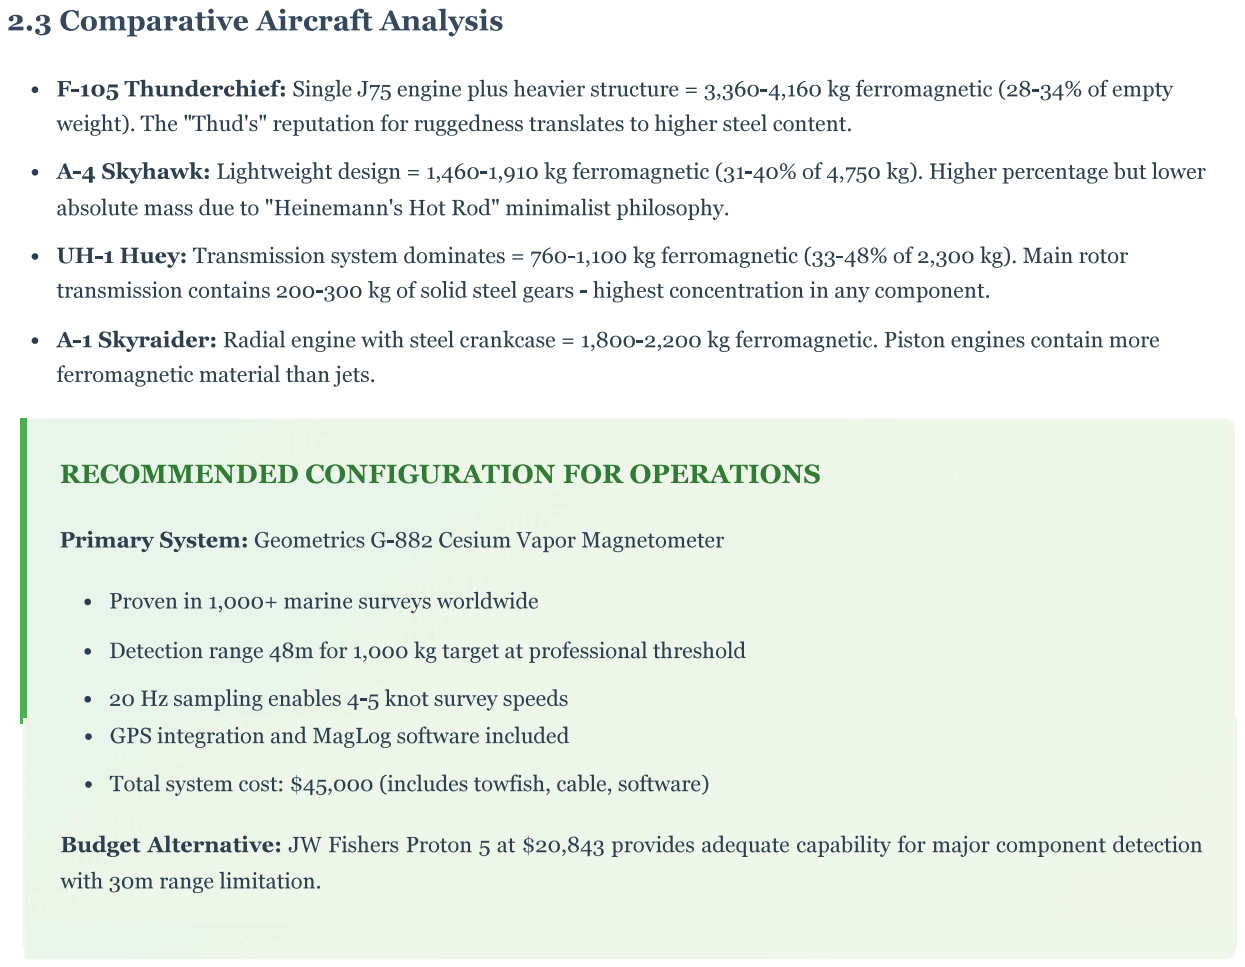
[picture p187: page 4]

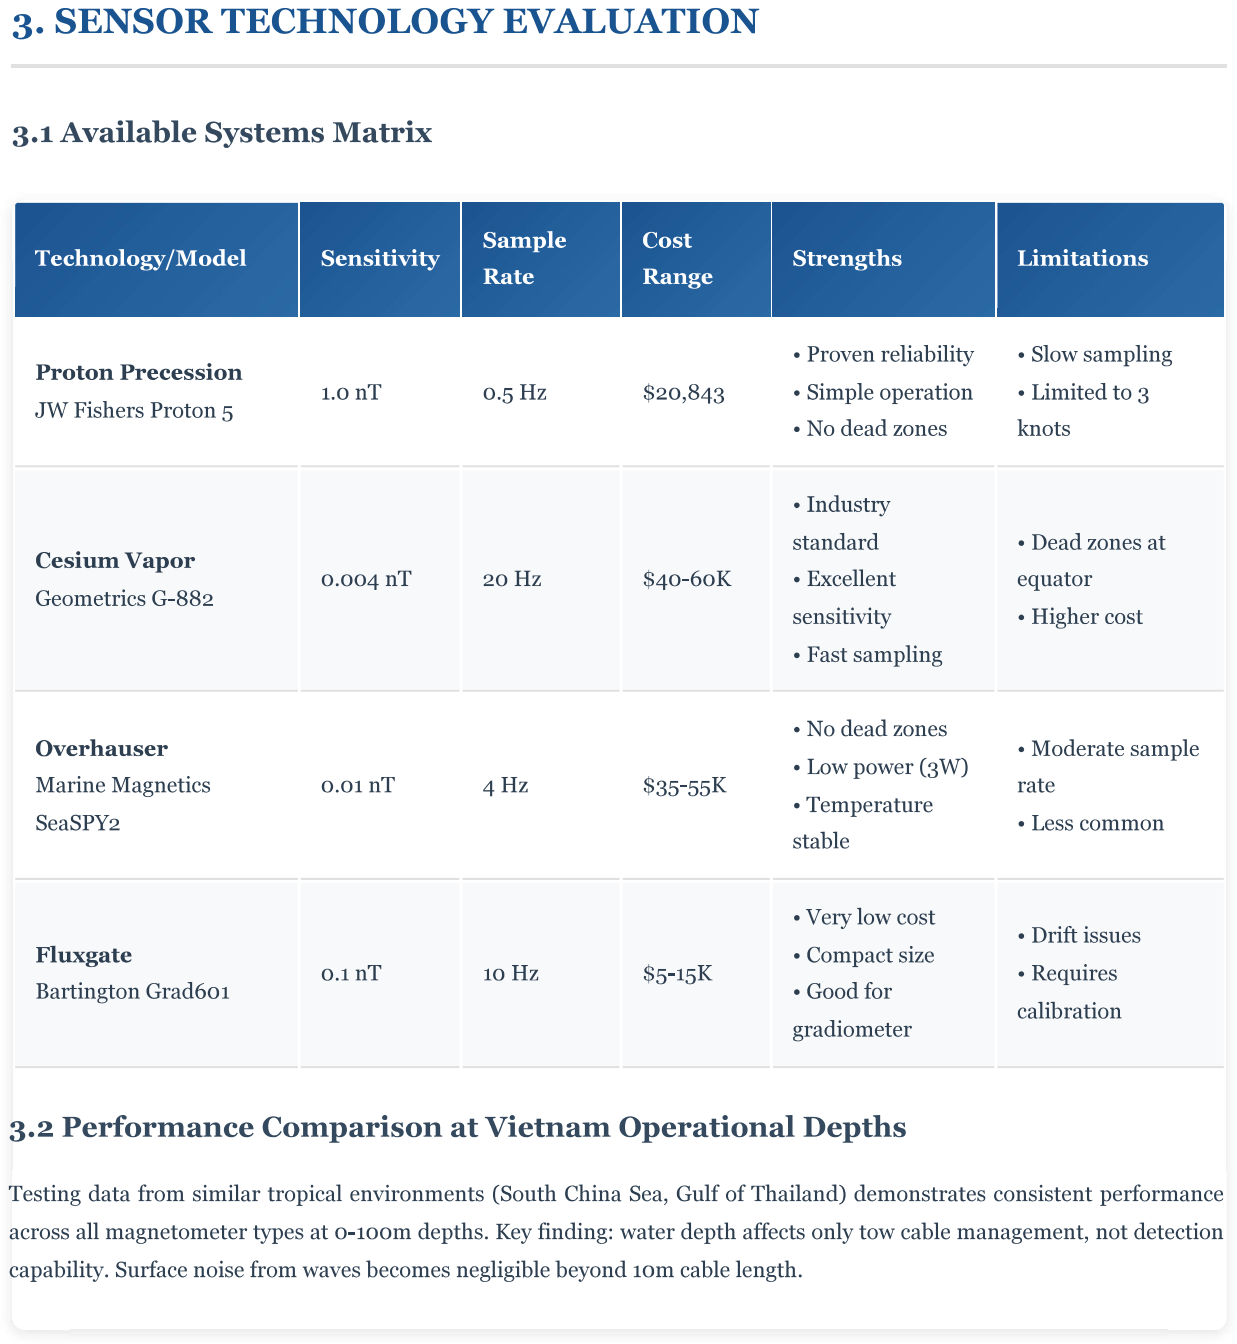
[picture p188: page 5]

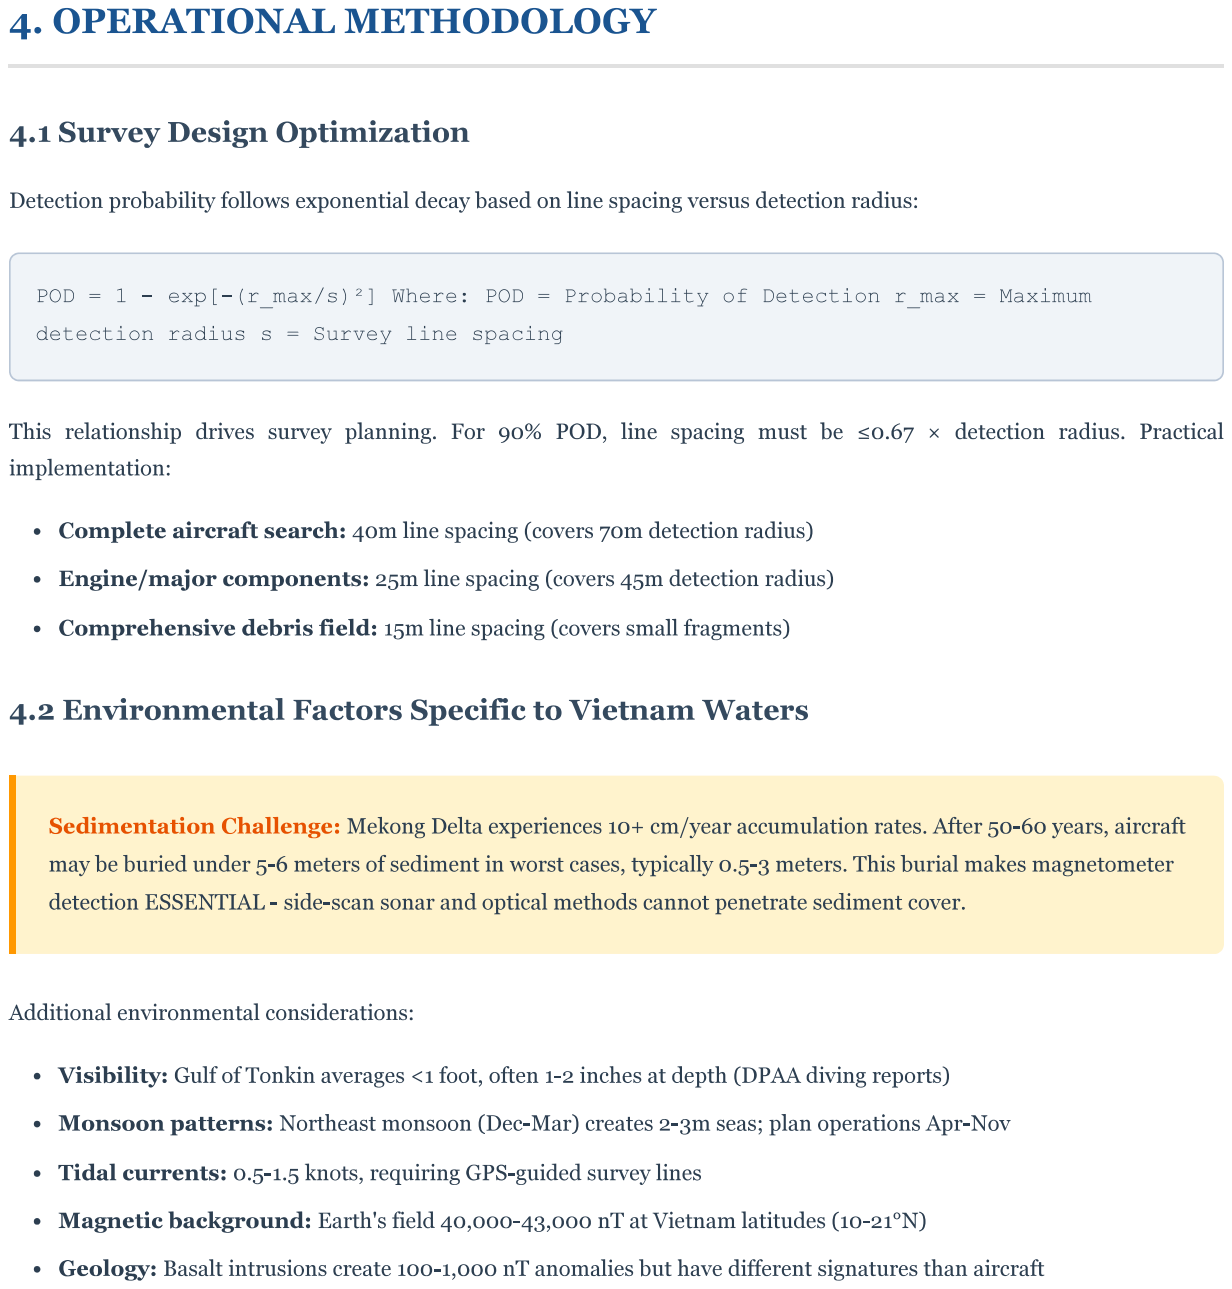
[picture p189: page 6]

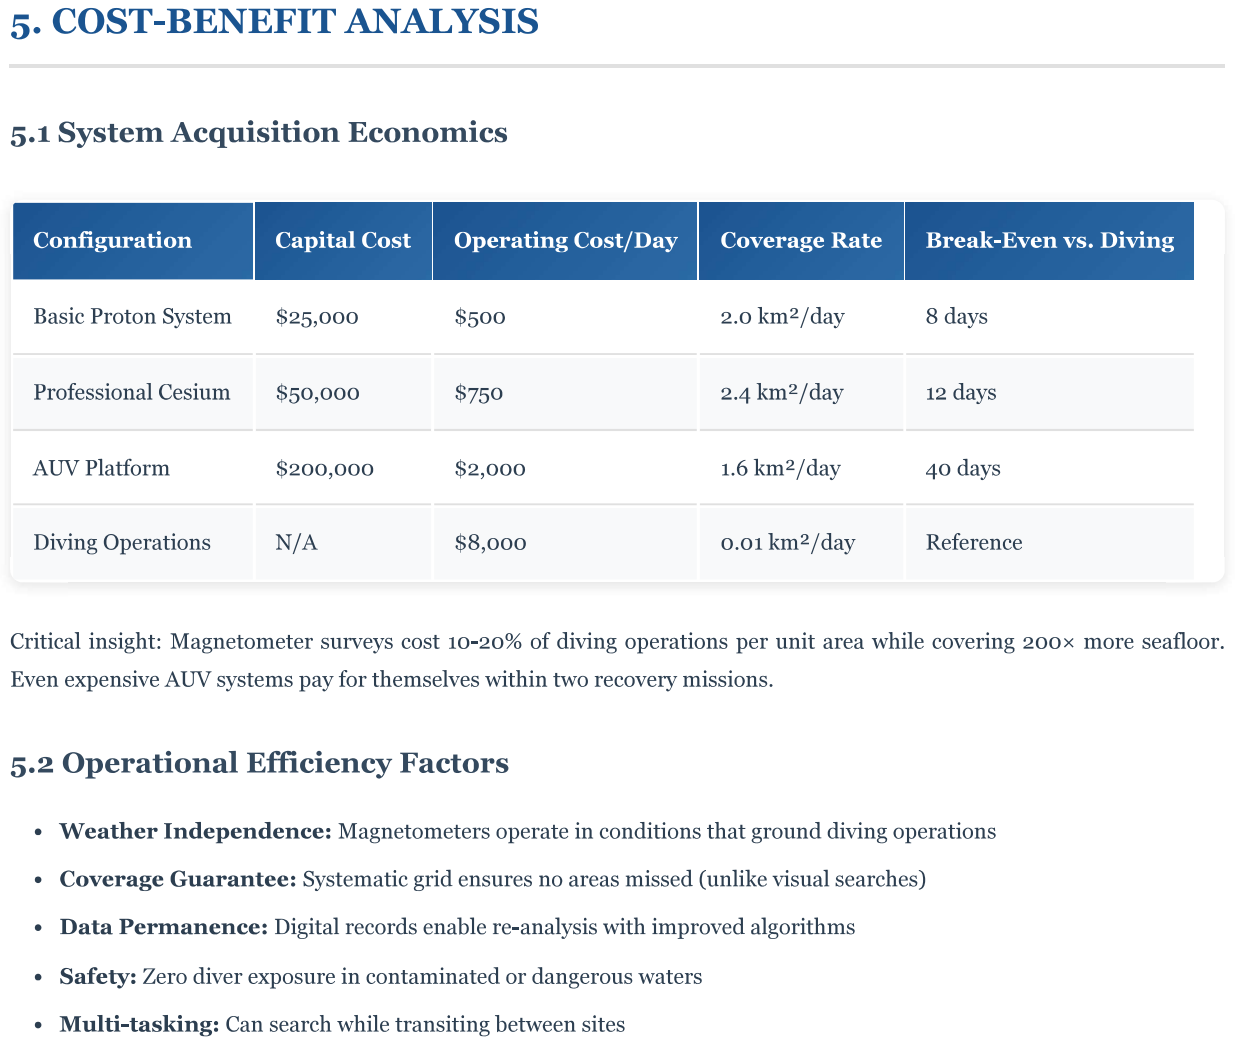
[picture p190: page 7]
