ethanewer/ece455/ltspice/AmplificationSim.asc

C1: cap; {Cnom*(1+tol)}
C2: cap; 1µF
C3: cap; 20p
C4: cap; 1µF
C5: cap; 4.6nF
C6: cap; 18nF
C7: cap; 20p
C8: cap; 2p
C9: cap; 2p
L1: ind; 28.11m; Rser=1m
R1: res; 10Meg
R2: res; 10k
R3: res; 50k
R4: res; 1K
R5: res; 39
R8: res; 1Meg
R9: res; 33k
R10: res; 50k
R11: res; 1K
R12: res; 33k
R13: res; 10Meg
R14: res; 1T
R15: res; 1T
U1: UniversalOpAmp2; Avol=316k GBW=3Meg Slew=2.4Meg; Ilimit=7m Rail=0.1 Vos=0.5m
U2: UniversalOpAmp2; Avol=316k GBW=3Meg Slew=2.4Meg; Ilimit=7m Rail=0.1 Vos=0.5m
V1: voltage; SINE(0 10uV 2268 0 1.0526 0)
V5: voltage; 2.5
V6: voltage; SINE(0 100u 60)
V8: voltage; 5V
V9: voltage; 2.5V
Named nets: 0, AIN1, 5P, VopAmpOut1, VopAmpOut2, AIN3, 25P
.tran 0 2 0 34us
175.2n is preferred
.param Cnom=180n
.step param tol list -0.05 0 0.05
-180uV to 180uV if we are starting the prototype here with signal generator (no coil)
