ethanewer/ece455/kicad/polarization_board/PolarizationBoard.kicad_pcb

## KiCad design kicad/polarization_board/PolarizationBoard.kicad_pcb (2026-10-28)

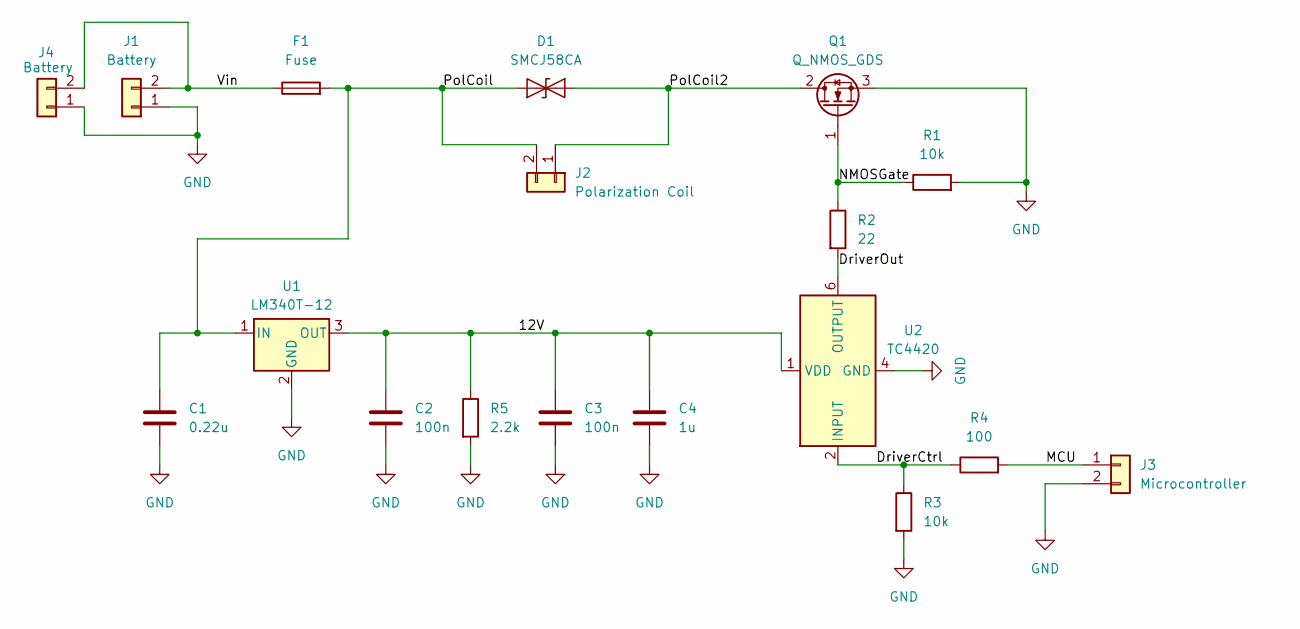
[picture p191: schematic PolarizationBoard.kicad_sch, Proton Precession Magnetometer Polarization Board]

Parts:
C1: 0.22u; C_1206_3216Metric_Pad1.33x1.80mm_HandSolder; Manufacturing Part Numb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 GRM319R71H224KA01D
C2, C3: 100n; C_1206_3216Metric_Pad1.33x1.80mm_HandSolder; Manufacturing Part Numb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 12065C104K4T2A
C4: 1u; C_1206_3216Metric_Pad1.33x1.80mm_HandSolder; Manufacturing Part Numb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 GRM31CR71H105KA61L
D1: SMCJ58CA; D_SMC_Handsoldering; Manufacturing Part Numb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 SMCJ58CA
F1: Fuse; Fuseholder_Cylinder-5x20mm_Schurter_0031_8201_Horizontal_Op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; Manufacturing Part Numb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 0031.8201
J1, J4: Battery; TerminalBlock_Phoenix_MKDS-1,5-2_1x02_P5.00mm_Horizontal; Manufacturing Part Numb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 1715721
J2: Polarization Coil; TerminalBlock_Phoenix_MKDS-1,5-2_1x02_P5.00mm_Horizontal; Manufacturing Part Numb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 1715721
J3: Microcontroller; TerminalBlock_Phoenix_MKDS-1,5-2_1x02_P5.00mm_Horizontal; Manufacturing Part Numb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 1715721
Q1: Q_NMOS_GDS; TO-220-3_Vertical; Manufacturing Part Numb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 IRFB4227PBF
R1, R3: 10k; R_1206_3216Metric_Pad1.30x1.75mm_HandSolder; Manufacturing Part Numb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 RMCF1206FT10K0
R2: 22; R_1206_3216Metric_Pad1.30x1.75mm_HandSolder; Manufacturing Part Numb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 RMCF1206JT22R0
R4: 100; R_1206_3216Metric_Pad1.30x1.75mm_HandSolder; Manufacturing Part Numb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 RMCF1206FT100R
R5: 2.2k; R_1206_3216Metric_Pad1.30x1.75mm_HandSolder; Manufacturing Part Numb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 RMCF1206FT2K20
U1: LM340T-12; TO-220-3_Vertical; Manufacturing Part Numb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 LM340T-12/NOPB
U2: TC4420; SOIC-8_3.9x4.9mm_P1.27mm; Manufacturing Part Numb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 TC4420VOA713

Connections:
/12V: C2.1, C3.1, C4.1, R5.1, U1.3 (OUT), U2.1 (VDD), U2.8 (VDD)
/DriverCtrl: R3.1, R4.1, U2.2 (INPUT)
/DriverOut: R2.2, U2.6 (OUTPUT), U2.7 (OUTPUT)
/MCU: J3.1, R4.2
/NMOSGate: Q1.1 (G), R1.1, R2.1
/PolCoil: C1.1, D1.1 (A1), F1.2, J2.2, U1.1 (IN)
/PolCoil2: D1.2 (A2), J2.1, Q1.2 (D)
/Vin: F1.1, J1.2, J4.2
GND: C1.2, C2.2, C3.2, C4.2, J1.1, J3.2, J4.1, Q1.3 (S), R1.2, R3.2, R5.2, U1.2 (GND), U2.4 (GND), U2.5 (GND)

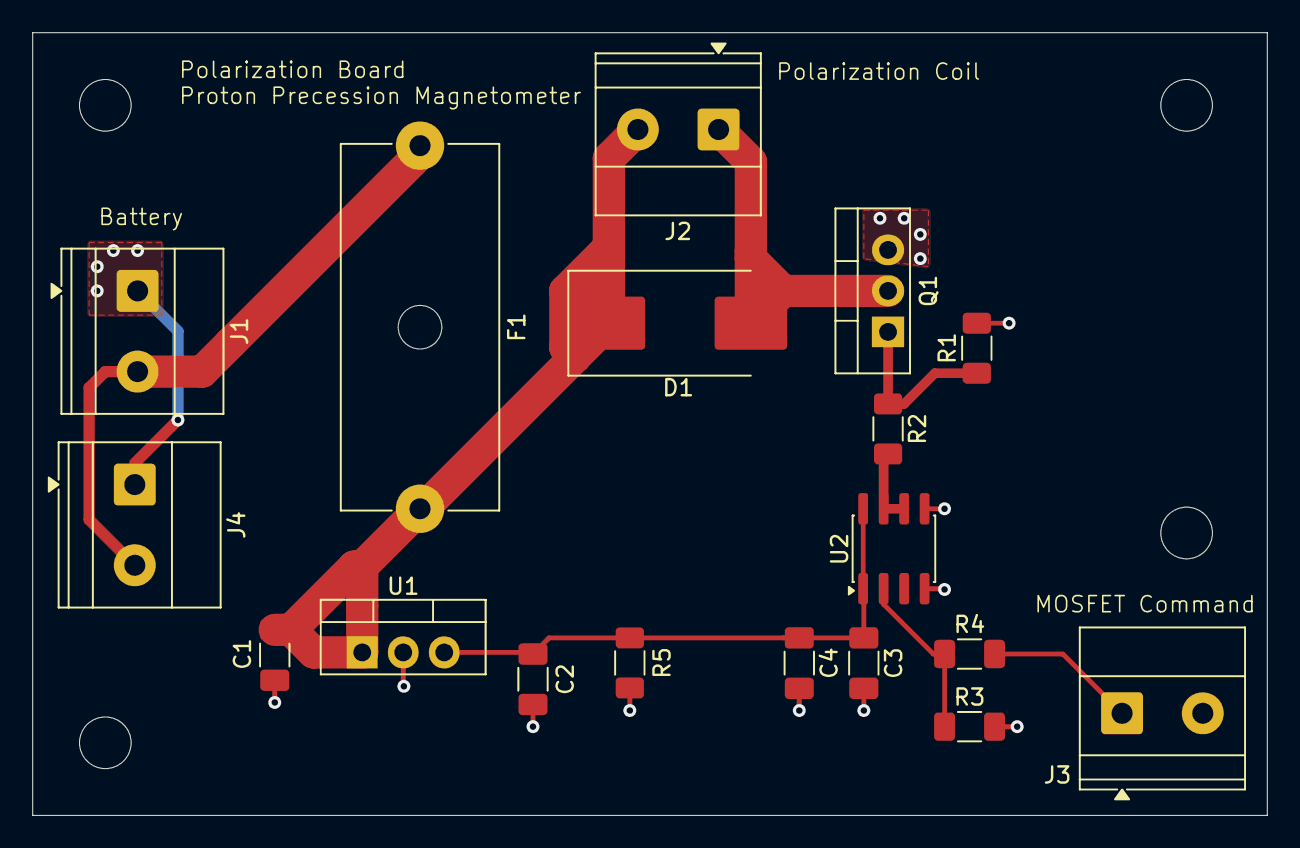
[picture p192: board PolarizationBoard.kicad_pcb from above]

Board: 2 copper layers, 76.5 x 48.5 mm, 22 parts (0 on the bottom side), 9 nets.

Other parts of the board:
H1, H2, H3, H4: MountingHole_3.2mm_M3
