ethanewer/ece455/kicad/signal_control_board/SignalProcessing&ControlBoard.kicad_pcb

## KiCad design kicad/signal_control_board/SignalProcessing&ControlBoard.kicad_pcb (2026-10-28)

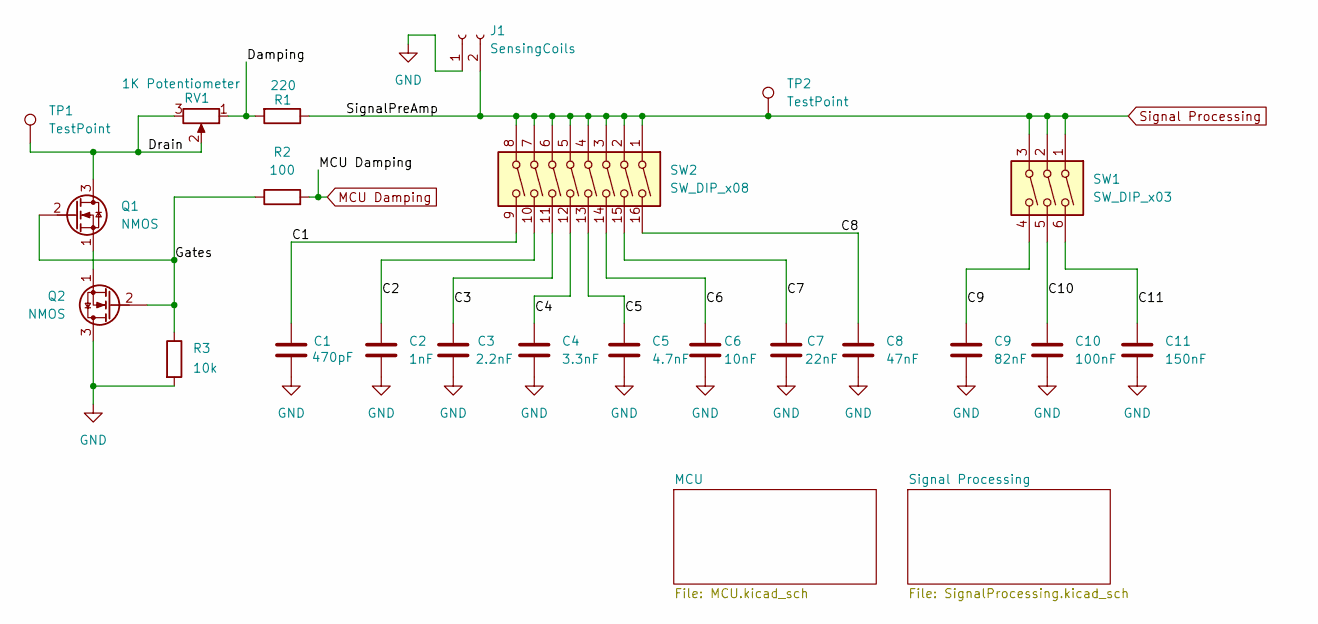
[picture p193: schematic SignalProcessing&ControlBoard.kicad_sch, Proton Precession Magnetometer Control Board]

Parts:
C1: 470pF; C_1206_3216Metric_Pad1.33x1.80mm_HandSolder
C2: 1nF; C_1206_3216Metric_Pad1.33x1.80mm_HandSolder
C3: 2.2nF; C_1210_3225Metric_Pad1.33x2.70mm_HandSolder
C4: 3.3nF; C_1206_3216Metric_Pad1.33x1.80mm_HandSolder
C5: 4.7nF; C_1206_3216Metric_Pad1.33x1.80mm_HandSolder
C6: 10nF; C_1206_3216Metric_Pad1.33x1.80mm_HandSolder
C7: 22nF; C_Rect_L13.0mm_W6.0mm_P10.00mm_FKS3_FKP3_MKS4
C8: 47nF; C_Rect_L18.0mm_W6.0mm_P15.00mm_FKS3_FKP3
C9: 82nF; C_Rect_L26.5mm_W6.0mm_P22.50mm_MKS4
C10: 100nF; C_Rect_L18.0mm_W9.0mm_P15.00mm_FKS3_FKP3
C11: 150nF; C_Rect_L18.0mm_W11.0mm_P15.00mm_FKS3_FKP3
J1: SensingCoils; TerminalBlock_Phoenix_MKDS-1,5-2-5.08_1x02_P5.08mm_Horizont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
Q1, Q2: NMOS; TO-92_Inline
R1: 220; R_1206_3216Metric_Pad1.30x1.75mm_HandSolder
R2: 100; R_1206_3216Metric_Pad1.30x1.75mm_HandSolder
R3: 10k; R_1206_3216Metric_Pad1.30x1.75mm_HandSolder
RV1: 1K Potentiometer; Potentiometer_Bourns_3296W_Vertical
SW1: SW_DIP_x03; SW_DIP_SPSTx03_Slide_9.78x9.8mm_W7.62mm_P2.54mm
SW2: SW_DIP_x08; SW_DIP_SPSTx08_Slide_9.78x22.5mm_W7.62mm_P2.54mm
TP1, TP2: TestPoint; TestPoint_Keystone_5000-5004_Miniature

Connections:
/C1: C1.1, SW2.9
/C2: C2.1, SW2.10
/C3: C3.1, SW2.11
/C4: C4.1, SW2.12
/C5: C5.1, SW2.13
/C6: C6.1, SW2.14
/C7: C7.1, SW2.15
/C8: C8.1, SW2.16
/C9: C9.1, SW1.4
/C10: C10.1, SW1.5
/C11: C11.1, SW1.6
/Damping: R1.2, RV1.1
/Drain: Q1.3 (D), RV1.2, RV1.3, TP1.1 (1_1)
/Gates: Q1.2 (G), Q2.2 (G), R2.1, R3.1
GND: C1.2, C2.2, C3.2, C4.2, C5.2, C6.2, C7.2, C8.2, C9.2, C10.2, C11.2, J1.1, Q2.3 (D), R3.2; also elsewhere on the board
MCU Damping: R2.2; also elsewhere on the board
unnamed: Q1.1 (S), Q2.1 (S)
Signal Processing: J1.2, R1.1, SW1.1, SW1.2, SW1.3, SW2.1, SW2.2, SW2.3, SW2.4, SW2.5, SW2.6, SW2.7, SW2.8, TP2.1 (1_1); also elsewhere on the board

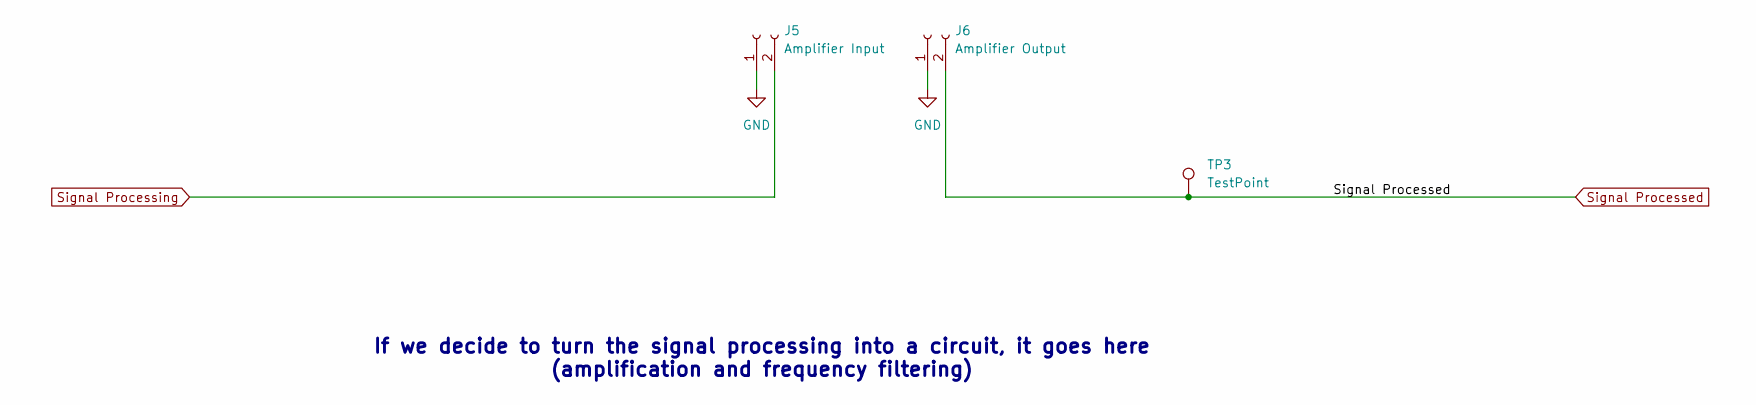
[picture p194: schematic SignalProcessing.kicad_sch, Proton Precession Magnetometer Signal Processing]

Parts:
J5: Amplifier Input; TerminalBlock_Phoenix_MKDS-1,5-2-5.08_1x02_P5.08mm_Horizont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
J6: Amplifier Output; TerminalBlock_Phoenix_MKDS-1,5-2-5.08_1x02_P5.08mm_Horizont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
TP3: TestPoint; TestPoint_Keystone_5000-5004_Miniature

Connections:
GND: J5.1, J6.1; also elsewhere on the board
Signal Processed: J6.2, TP3.1 (1_1); also elsewhere on the board
Signal Processing: J5.2; also elsewhere on the board

Notes on the sheet:
If we decide to turn the signal processing into a circuit, it goes here (amplification and frequency filtering)

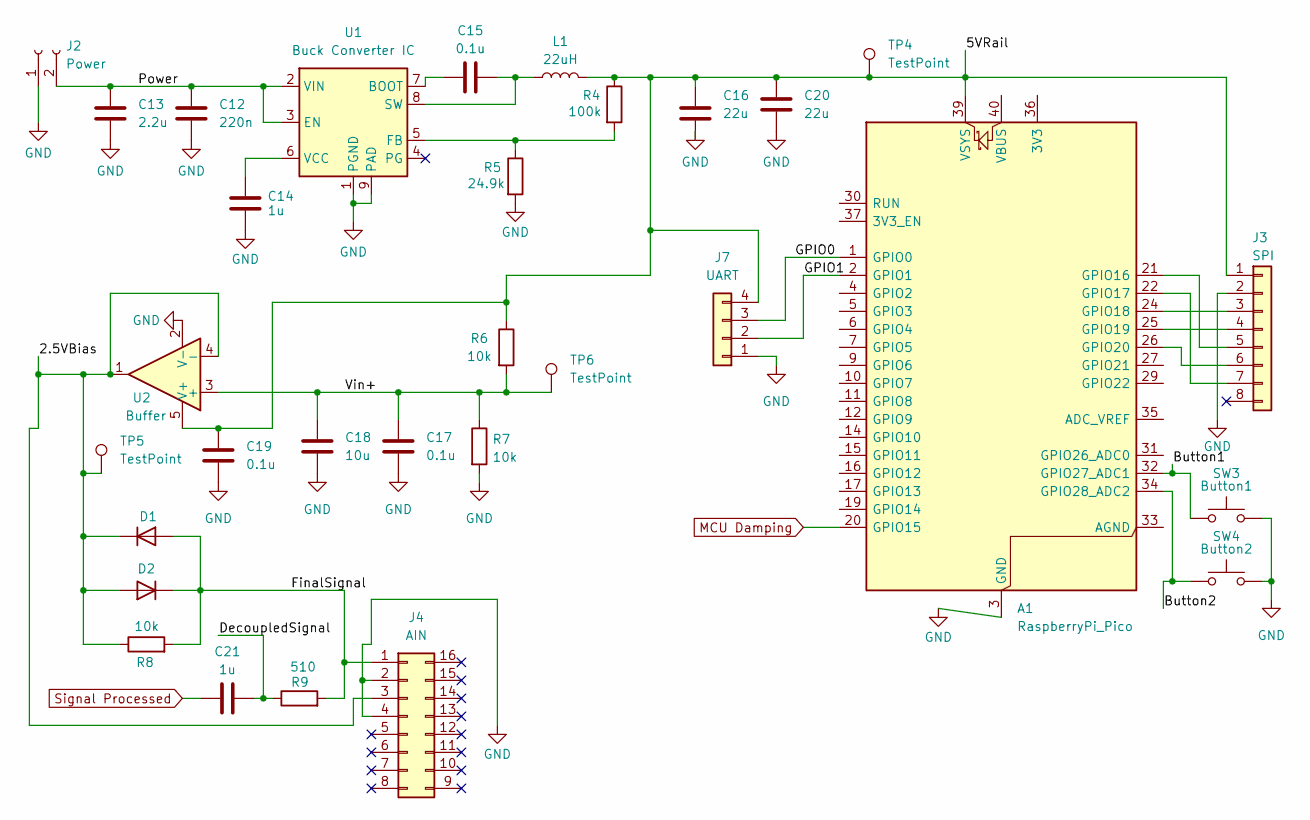
[picture p195: schematic MCU.kicad_sch, Proton Precession Magnetometer Signal Processing Board]

Parts:
A1: RaspberryPi_Pico; RaspberryPi_Pico_Common_Unspecified
C12: 220n; C_1206_3216Metric_Pad1.33x1.80mm_HandSolder
C13: 2.2u; C_1206_3216Metric_Pad1.33x1.80mm_HandSolder
C14, C21: 1u; C_1206_3216Metric_Pad1.33x1.80mm_HandSolder
C15, C17, C19: 0.1u; C_1206_3216Metric_Pad1.33x1.80mm_HandSolder
C16, C20: 22u; C_1206_3216Metric_Pad1.33x1.80mm_HandSolder
C18: 10u; C_1206_3216Metric_Pad1.33x1.80mm_HandSolder
D1, D2: D; D_SOD-123
J2: Power; TerminalBlock_Phoenix_MKDS-1,5-2-5.08_1x02_P5.08mm_Horizont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
J3: SPI; PinSocket_1x08_P2.54mm_Vertical
J4: AIN; PinSocket_2x08_P2.54mm_Vertical
J7: UART; PinSocket_1x04_P2.54mm_Vertical
L1: 22uH; L_Wurth_7447714220_WE-PD_1050
R4: 100k; R_1206_3216Metric_Pad1.30x1.75mm_HandSolder
R5: 24.9k; R_1206_3216Metric_Pad1.30x1.75mm_HandSolder
R6, R7, R8: 10k; R_1206_3216Metric_Pad1.30x1.75mm_HandSolder
R9: 510; R_1206_3216Metric_Pad1.30x1.75mm_HandSolder
SW3: Button1; SW_PUSH_6mm_H9.5mm
SW4: Button2; SW_PUSH_6mm_H9.5mm
TP4, TP5, TP6: TestPoint; TestPoint_Keystone_5000-5004_Miniature
U1: Buck Converter IC; Texas_HTSOP-8-1EP_3.9x4.9mm_P1.27mm_EP2.95x4.9mm_Mask2.4x3.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
U2: Buffer; SOT-23-5

Connections:
/MCU/2.5VBias: D1.1 (K), D2.2 (A), J4.3, R8.1, TP5.1 (1_1), U2.1, U2.4 (-)
/MCU/5VRail: A1.39 (VSYS), C16.2, C19.1, C20.2, J3.1, J7.4, L1.2, R4.1, R6.1, TP4.1 (1_1), U2.5 (V+)
/MCU/Button1: A1.32 (GPIO27_ADC1), SW3.1
/MCU/Button2: A1.34 (GPIO28_ADC2), SW4.1
/MCU/DecoupledSignal: C21.2, R9.1
/MCU/FinalSignal: D1.2 (A), D2.1 (K), J4.1, R8.2, R9.2
/MCU/GPIO0: A1.1 (GPIO0), J7.3
/MCU/GPIO1: A1.2 (GPIO1), J7.2
/MCU/Power: C12.1, C13.1, J2.2, U1.2 (VIN), U1.3 (EN)
/MCU/Vin+: C17.1, C18.1, R6.2, R7.1, TP6.1 (1_1), U2.3 (+)
GND: A1.3 (GND), A1.8 (GND), A1.13 (GND), A1.18 (GND), A1.23 (GND), A1.28 (GND), A1.38 (GND), C12.2, C13.2, C14.2, C16.1, C17.2, C18.2, C19.2, C20.1, J2.1, J3.2, J4.2, J4.4, J7.1, R5.2, R7.2, SW3.2, SW4.2, U1.1 (PGND), U1.9 (PAD), U2.2 (V-); also elsewhere on the board
MCU Damping: A1.20 (GPIO15); also elsewhere on the board
unnamed: A1.21 (GPIO16), J3.5
unnamed: A1.22 (GPIO17), J3.7
unnamed: A1.24 (GPIO18), J3.3
unnamed: A1.25 (GPIO19), J3.4
unnamed: A1.26 (GPIO20), J3.6
unnamed: C15.1, U1.7 (BOOT)
unnamed: R4.2, R5.1, U1.5 (FB)
unnamed: C15.2, L1.1, U1.8 (SW)
unnamed: C14.1, U1.6 (VCC)
Signal Processed: C21.1; also elsewhere on the board

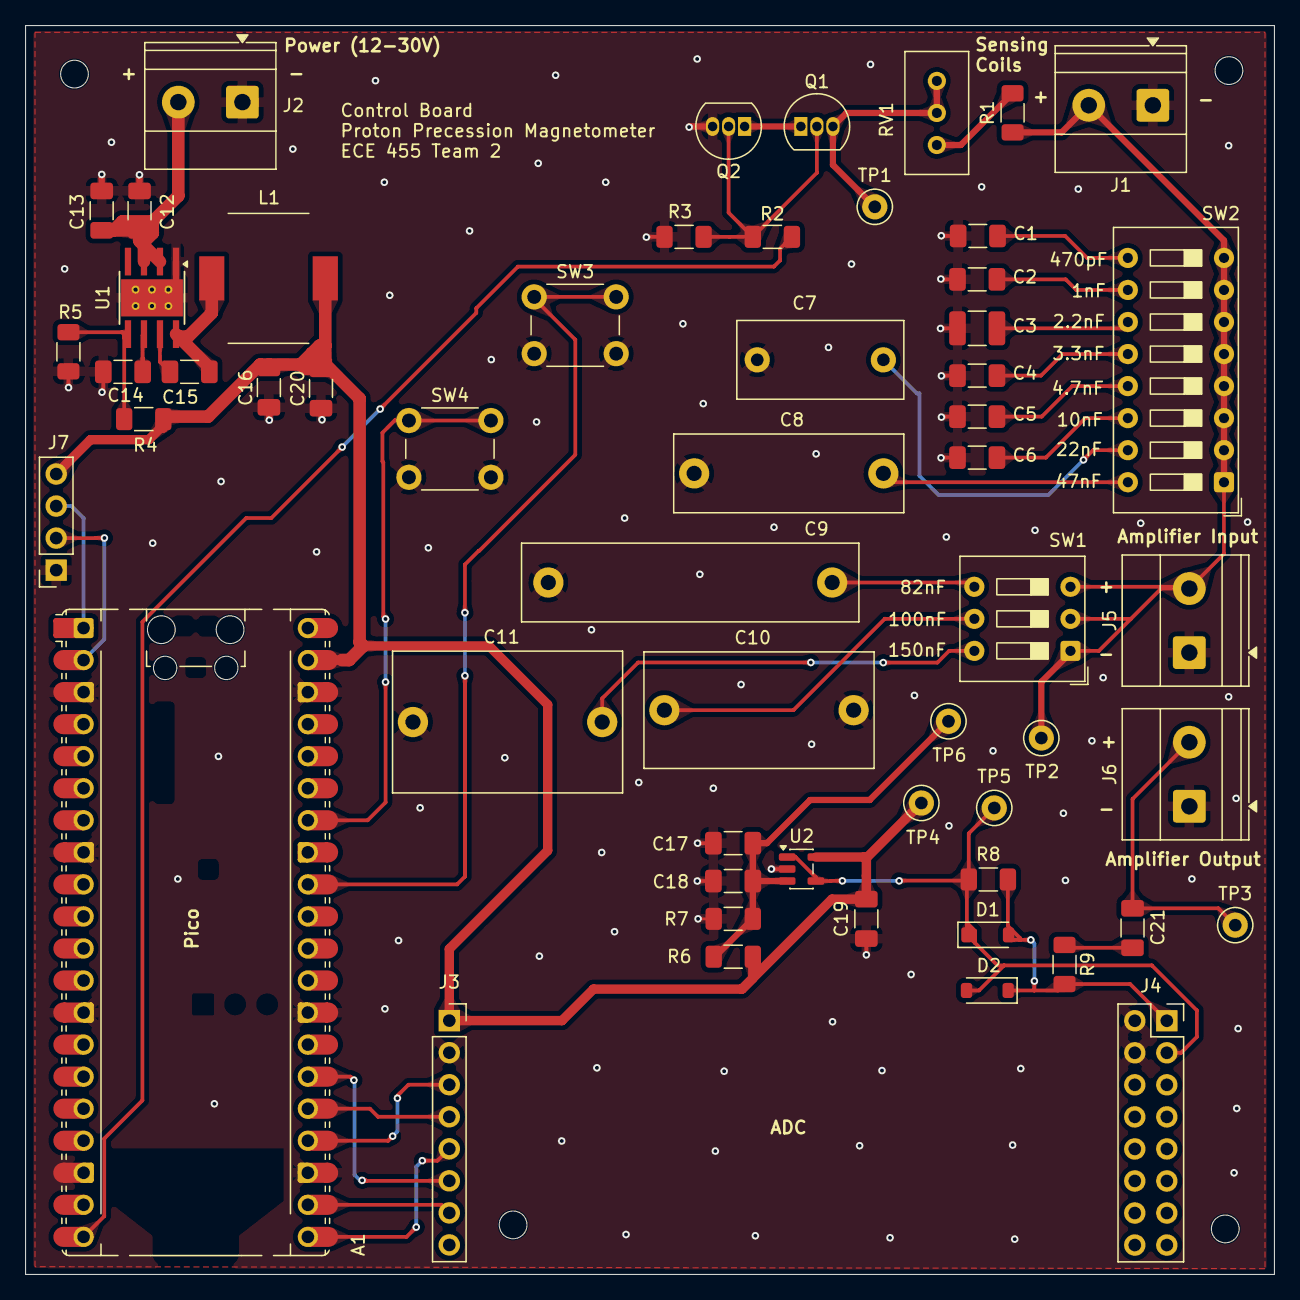
[picture p196: board SignalProcessing&ControlBoard.kicad_pcb from above]

Board: 2 copper layers, 99.0 x 99.0 mm, 60 parts (0 on the bottom side), 38 nets.

Other parts of the board:
Hole1, Hole2, Hole3, Hole4: MountingHole_2.2mm_M2
