ethanewer/ece455/(commit log)

2026-09-18 Redesign main for single-design verification
    [Polarization Coil V1.SLDPRT, Sensor coil V1.SLDPRT, receiver.kicad_pcb]
2026-09-18 Complete ADS1256 receiver design and verification workflow
    [bom.csv, receiver-frequency-response.csv, receiver-waveforms.csv, receiver.kicad_pcb]
2026-09-19 Broaden receiver passband and raise gain
    [bom.csv, receiver-frequency-response.csv, receiver-waveforms.csv]
2026-09-19 Render construction schematics on white
2026-09-19 Improve construction schematic layout
2026-09-23 Make the receiver and estimator ready for a 30 kSPS measurement.
    Bias the amplifiers where their noise is specified, keep a saturated output inside the ADC buffer limit, and fit a 1.5 s record in the estimator.
    [bom.csv, receiver-frequency-response.csv, receiver-waveforms.csv]
2026-09-25 updated design
    [CoilDesign.xlsx, bom.csv, receiver-frequency-response.csv, receiver-waveforms.csv]
2026-09-25 Keep receiver tuning external to high-impedance input
    [bom.csv, receiver-frequency-response.csv, receiver-waveforms.csv]
2026-09-25 Group receiver BOM by part and quantity
    [bom.csv]
2026-09-25 Revise receiver for lab parts and document prototype build
    [bom.csv, digikey_missing_components.csv, receiver-frequency-response.csv, receiver-waveforms.csv]
2026-09-29 Replace receiver with minimal discrete high-impedance amplifier
    The receiver is now 24 Thomson kit parts: a low-noise 2N3904/2N3906
    series-feedback input stage, one common-emitter gain stage, and a single
    DC loop whose filtered node doubles as the ADS1256 AIN1 reference. In
    ngspice it gives at least 2000 V/V from J1 across 1.5-2.5 kHz and
    |Z_in| above 1 megohm at beta, temperature, and USB-voltage corners.
    Its noise keeps the frequency Cramer-Rao bound well under 1 nT.
    Diode-connected 2N3904 clamps replace the 1N4148s, whose leakage
    dropped |Z_in| below 1 megohm when warm. The analog bandpass and SPI
    level translators are removed: the ADS1256 sinc filter rejects
    aliases, and its SPI inputs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
    [bom.csv, receiver-frequency-response.csv, receiver-waveforms.csv]
2026-09-29 Add receiver band-pass filter and enforce requirements in make verify
    A Sallen-Key high-pass (1.1 kHz, Q 1.05) buffered by a 2N3904 follower
    now drives AIN0. C7 moves to ground as a 5.3 kHz low-pass pole, and R8
    drops to 150 ohm so stage 1 gains 35 to cover the filter's band-edge
    loss. In ngspice the 30-part receiver gives 2665-2701 V/V across
    1.6-2.2 kHz, 0.46 V/V at 60 Hz, and |Z_in| of 1.81-2.32 Mohm.
    receiver_design/requirements.py defines three requirements:
    - gain >= 2000 V/V across 1.6-2.2 kHz
    - |Z_in| >= 1 Mohm across 1.5-2.5 kHz
    - noise <= 5 nV/rtHz with the coil, including ADC noise
    verify.py simulates them at nine beta, temperature, and USB-voltage
    corners and exits with an erro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
    [bom.csv, receiver-frequency-response.csv, receiver-waveforms.csv]
2026-09-29 Filter receiver between stages and require interference tolerance
    requirements.py adds a fourth hard requirement: no stage may clip for
    a 10 mV peak tone at J1 across 50-400 Hz or 2 mV across 8-50 kHz. Each
    stage's operating-point headroom divided by its gain from J1 gives the
    largest tolerable tone. make verify checks it at all nine corners.
    The band-pass now sits between the stages, so only stage 1's gain of
    35 precedes it. It is a fourth-order filter: a Sallen-Key high-pass
    at 1.31 kHz buffered by Q7, then a Sallen-Key low-pass at 3.05 kHz
    buffered by the PNP follower Q8. Q4's collector drives AIN0 again, and
    the single DC loop still sets every operating point.
    R4, R5, R6, and R9 are re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
    [bom.csv, receiver-frequency-response.csv, receiver-waveforms.csv]
2026-10-10 Replace discrete receiver with AD8421 module and RC anti-aliasing filter
    The receiver is now a purchased AD8421 instrumentation-amplifier module
    at G = 100 (R1 = 100 ohm), powered from two 9 V batteries, followed by a
    two-section RC low-pass (1 k/22 n, 10 k/2.2 n) into ADS1256 AIN0 with
    AIN1 at GND, buffer off, PGA 1. Diode-connected 2N3904 clamps stay at J1.
    amazon_purchases.json lists everything to buy with Amazon links: $48.95
    required (module, SMA-to-Dupont cable, battery clips, batteries) against
    the $50 budget, and $86.62 with a recommended spare module and clip-on
    ferrites. verify.py checks the links, totals, budget, and that the BOM
    uses every required item.
    requirements.py drops t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
2026-10-28 Add AD8421 receiver breadboard layout generator
    Snapshot of the AD8421 receiver work before the repository moves to the
    team's KiCad/Pico design: a fixed 830-point breadboard placement checked
    against spice/receiver.cir and kicad/receiver.net, its rendered drawing and
    hole list, export integration, and an updated assembly guide.
2026-10-28 Rebuild the repository around the team's KiCad, LTspice, and Pico design
    Replace the AD8421 receiver with the design in the team's files and
    reorganize by file type:
    - kicad/: polarization board and signal-processing & control board
    (KiCad 10 schematics, PCBs, Gerbers, BOM export)
    - ltspice/AmplificationSim.asc: coil, tuning tank, and off-board amplifier
    - firmware/: Pico 2 ADS1256 capture and frequency firmware, copied from
    hjvania10-rgb/PicoProgramECE455 at e9b393a
    - spreadsheets/TuningCapacitors.xlsx and 3d_models/ (coil forms)
    util/ holds everything that reads or tests them: KiCad, LTspice, and xlsx
    readers; an LTspice-to-ngspice translator whose UniversalOpAmp2 model
    matches LTspi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
2026-10-28 Back up weekly slides, hardware photos, and illustrations
    Snapshot of untracked files kept only in this working copy, committed so
    the next commit can remove them from the working tree while history keeps
    them:
    - From Downloads, Desktop & iCloud/: weekly progress slides (weeks 2-8)
    - local/board-photo/: photos of the built AD8421 module and breadboard
    - local/device-diagram-options/, local/spin-trilogy/: generated
    presentation illustrations with their prompts
    - local/gain-range/: one-off gain sweep and an earlier breadboard script
    for the AD8421 receiver
    Restore any of them with `git checkout <this commit> -- <path>`.
2026-10-28 Add the coil design workbook and estimate the FID from the coils
    Restore spreadsheets/CoilDesign.xlsx and read it, with the coil forms in
    3d_models/, to estimate what produces the FID:
    - util/coil.py reproduces the workbook's winding, resistance, and
    inductance method and inverts it. The measured inductances and the
    LTspice coil resistance both imply about 600 turns per sensing coil,
    not the 1477 planned.
    - util/printfile.py measures the printed forms from their sliced G-code.
    They match the workbook's bobbins and are sized for the two sensing
    coils to nest inside the polarizing coil.
    - util/physics.py gains the Curie-law FID amplitude. The simulation
    report now gives about 4.7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
2026-10-28 Sync the button-triggered firmware and add Pico build, flash, and plot
    Update firmware/ to hjvania10-rgb/PicoProgramECE455 at 3450aba: the start
    button on GP27 (SW3) now polarizes through GP0 for 8 s, waits 50 ms, and
    captures; records go to the plotter in binary; valid frequencies get an
    empirical +0.05 Hz correction. Leave out the repository's superseded
    variants. Local changes: the ready prompt prints the actual button pin,
    and adc_plots.py finds the Pico's serial port by itself.
    - make pico / make flash / make plot build with the Pico SDK and Arm
    toolchain under ~/.pico-sdk, flash over USB through the 1200-baud
    BOOTSEL reboot (util/flash.py), and run the plotter. pyserial is in the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
2026-10-28 Enlarge the plotter's text and wait longer for BOOTSEL when flashing
    adc_plots.py takes its text sizes from one FONT_SIZE setting (15 pt base,
    up from matplotlib's 10 pt) and widens the margins to fit. util/flash.py
    waits up to 30 s for the Pico's BOOTSEL drive instead of 10 s, which was
    too short on this Mac.
